Bill-Gkionis/IPM-synRM/README.md

# IPM synRM: an open motor design

A **36-slot, 8-pole permanent-magnet-assisted synchronous reluctance motor** (PMaSynRM): two N45 magnets per pole in a V, M-19 steel, a 90 mm rotor in a 128 mm stator. It is designed, simulated and optimized with open tools, and documented step by step, so that each result can be checked and reused. The motor is built to learn from, not for a specific application.

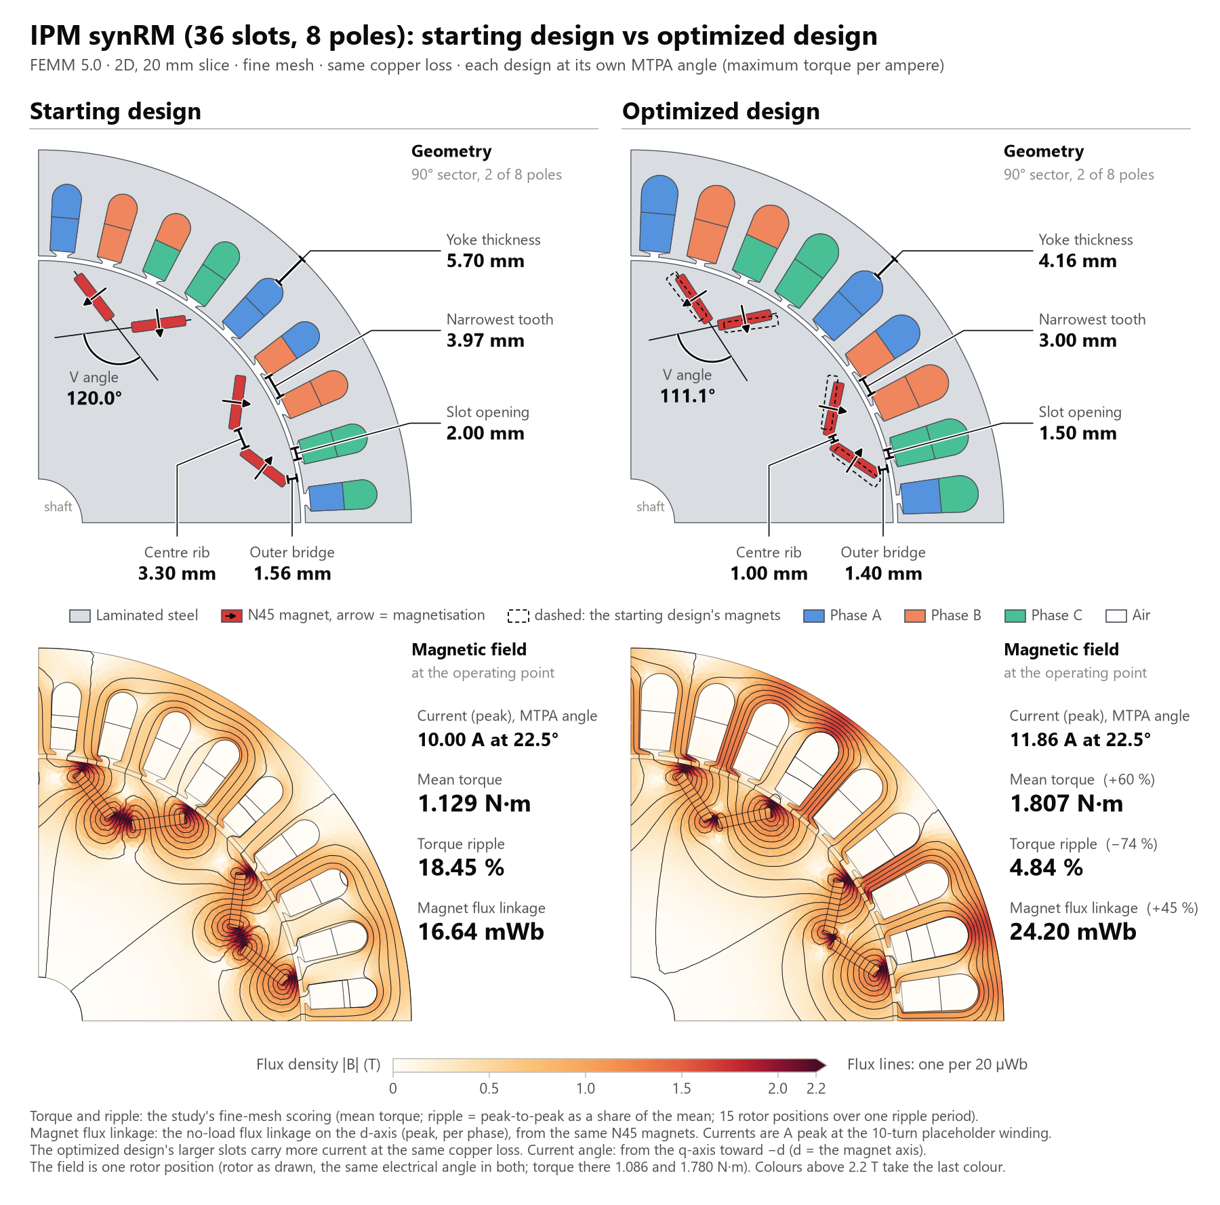
[picture p1: docs/figures/optimization/reference-vs-optimized.png]
The starting design and the optimized design, side by side: geometry and magnetic field


*The starting design (left) and the optimized design (right), at the same scale and the same copper loss, each at its own best current angle: the geometry with the changed dimensions, and the magnetic field. FEMM 5.0, 2D, fine mesh.*

> **Status (November 2026).**
> - **Done, and published here:**
>   - the cross-section, optimized;
>   - its rotor, checked for stress at speed;
>   - its flux maps over the whole current plane, with cross-saturation and the iron loss, validated in MATLAB;
>   - its thermal model;
>   - its copper losses, with the proximity effect, and the winding trade-offs;
>   - its torque–speed, loss and efficiency estimates ([Motor map.md](Motor%20map.md));
>   - an interactive flux page of the three designs ([open it](https://bill-gkionis.github.io/IPM-synRM/explorer/)).
> - **Next:** a flux-map-driven Simulink plant, in place of the constant parameters.
> - **Not yet measured:** every number here is a finite-element estimate. Nothing has been measured on hardware yet.

## The interactive flux page

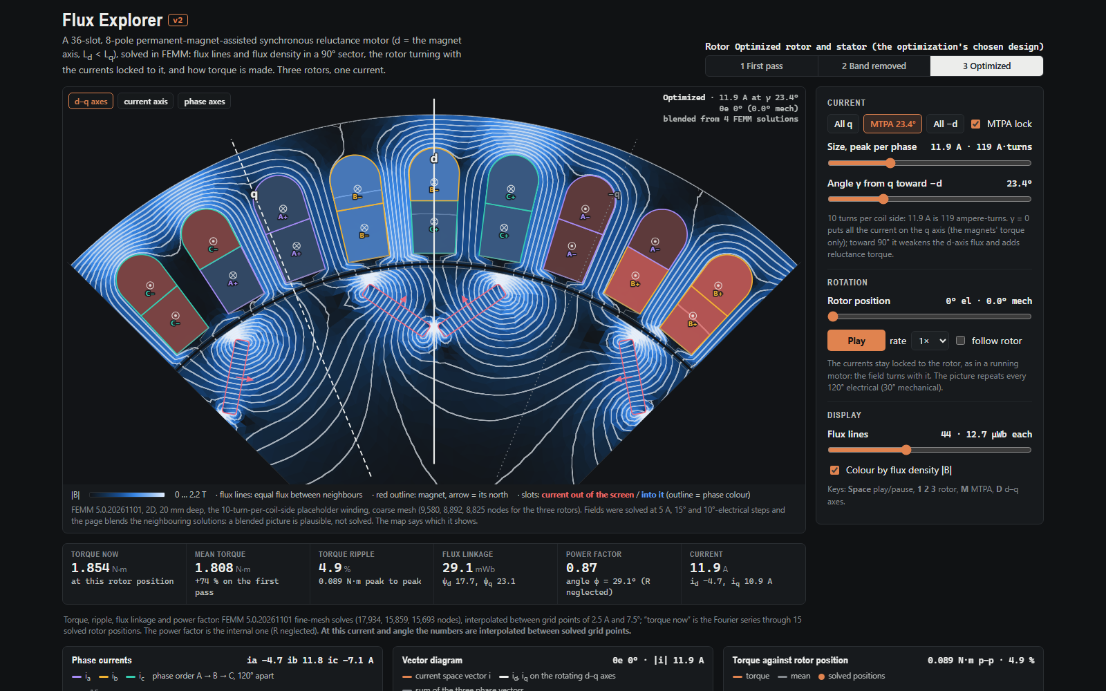
[picture p2: docs/figures/explorer/flux-explorer.png]
The Flux Explorer: the optimized motor's field, currents and torque


**[Open the Flux Explorer](https://bill-gkionis.github.io/IPM-synRM/explorer/)**: the three designs, the first pass with its air band, the band removed and the optimized motor, from 11,718 FEMM solves. It shows:
- the field, with the rotor turning;
- the current dial, with the MTPA angle;
- the phase currents and their vectors;
- the torque ripple;
- the current plane, with field weakening as the speed rises;
- about 3,400 of the designs the optimizer scored: the optimization runs (the 736 sweep designs aren't plotted).

One self-contained page, running in the browser. Pictures between solved points are blended, and the page says so.

## At a glance

| | |
|---|---|
| Topology | PM-assisted synchronous reluctance, interior V magnets, two per pole |
| Slots / poles | 36 / 8, double-layer distributed winding, q = 1.5, winding factor 0.945 |
| Stator | outer diameter 128 mm, bore 91.6 mm |
| Rotor | outer diameter 90 mm (air gap 0.8 mm), shaft Ø15 mm |
| Magnets | N45 sintered NdFeB, 1.57 × 9.08 × 19.14 mm |
| Steel | M-19, laminated |
| Supply | a 48–60 V DC bus (ultra-low voltage) |
| Axis convention | d = the magnet axis, so L_d < L_q |
| The optimized cross-section | outer bridge 1.4 mm, centre rib 1.0 mm, V angle 111°, slot opening 1.5 mm, tooth 3.0 mm, the same magnets. Against the starting design, at the same copper loss: **+60 % torque, and 4.8 % torque ripple instead of 18.5 %** |

**What it can do, estimated** ([Motor map.md](Motor%20map.md) has every assumption). On a 60 mm stack and a 48 V bus, with a fan on the shaft:
- **4.2 N·m continuously** at 3,000 rpm, and **8.7 N·m** for about 25 minutes from a cold start;
- **2.97 kW peak** short-term, and still 2.7 kW at 16,330 rpm, where the speed range ends: the rotor's safe speed, on placeholder strength values;
- **a best efficiency of 95.2 %** (motor only).

These are 2D finite-element estimates, not measurements.

## The pipeline

```mermaid
flowchart LR
  G["Geometry<br/>drawn in Python<br/>(motorgeo)"] --> F["FEMM 5.0<br/>2D magnetostatics,<br/>parallel workers"]
  F --> O["Optimizers<br/>NSGA-II · a full grid ·<br/>a blind Bayesian check"]
  O --> V["Verification<br/>CalculiX stress · Elmer ·<br/>ROSS · SALib"]
  V --> D["Motor data<br/>flux maps · thermal model ·<br/>copper losses"]
  D --> W["Winding<br/>every candidate,<br/>with the heat"]
  W --> P["Motor map<br/>torque–speed, losses,<br/>efficiency"]
  P --> N["Next<br/>MATLAB validation ·<br/>Simulink plant · inverter"]
```

**Three principles:**
- **The geometry is generated, not drawn.** One Python recipe writes the FEMM model, a DXF for CAD, and the meshes for Gmsh and Elmer, so an optimizer can change any dimension, and every candidate is checked for manufacturability before a solver opens.
- **One heavy run at a time.** Every solver run (FEMM, CalculiX, Elmer, MATLAB) takes a slot from a queue, runs at below-normal priority under a timeout, and ends only the processes it started.
- **Every result is checked by a second route:** a known analytic answer, a different solver, or an independent optimizer that never saw the first one's results.

**Solves so far:** about 122,500 FEMM solves:
- 95,588 for the optimization search (step 6);
- 15,202 for the flux maps (step 8);
- 11,718 for the interactive page.

That's besides the studies and the validation runs.

The code is in [`python/`](python/), with a guide to every file in [`python/README.md`](python/README.md).

## How it got here

### 1. The first pass (February–April 2026)

SolidWorks parts, a FEMM model with a rotor sweep by hand from 5° to 90°, the flux linkage extracted in MATLAB, and a first field-oriented-control (FOC) drive with space-vector PWM, in Simulink and Simscape Electrical. The plant ran unloaded, with constant motor parameters.
- **Files:** [`cad/`](cad/), [`femm/`](femm/), [`matlab/`](matlab/), and screenshots in [`docs/figures/`](docs/figures/).

### 2. A scriptable stack (October 2026)

The cross-section was redrawn in Python (`motorgeo`), and FEMM was driven from Python on a 90° sector with periodic boundaries and an air-gap element, in parallel workers.
- The new model reproduces the hand-drawn FEMM model's areas exactly (0.000 %).
- The 90° slice matches the full 360° model within about 1.5 %.

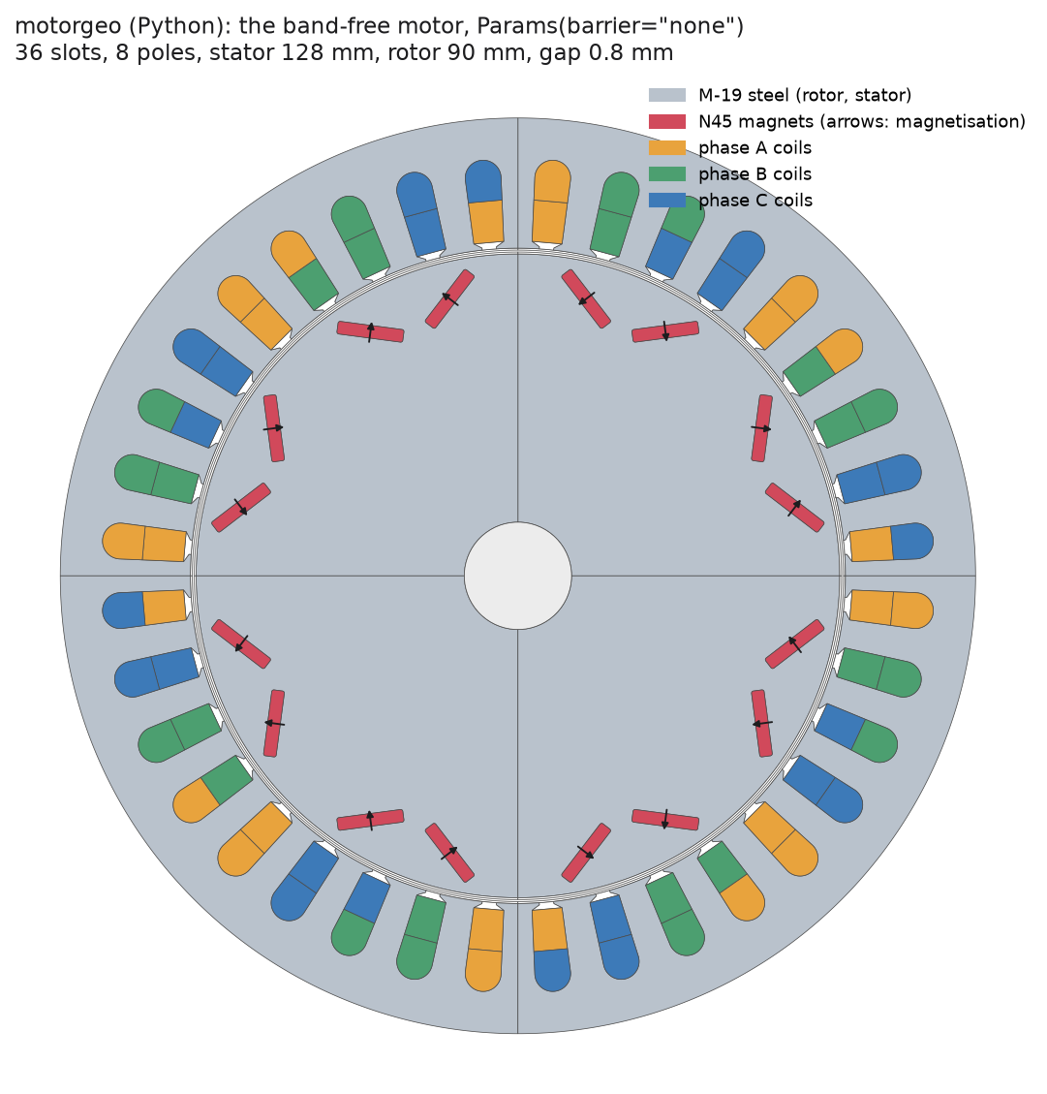
[picture p3: docs/figures/geometry/motorgeo-cross-section.png]
The cross-section drawn by motorgeo


### 3. The first study: the air band (October 2026)

The first-pass rotor had a 1.5 mm air band behind the magnets. Filled with steel, the same rotor gave **37 % more magnet flux and 31–38 % more torque** at the best current angle, with the same reluctance torque and per-cent ripple; the cogging doubled. The band sat in the magnets' return path. **It was removed.** *(FEMM 4.2.)*

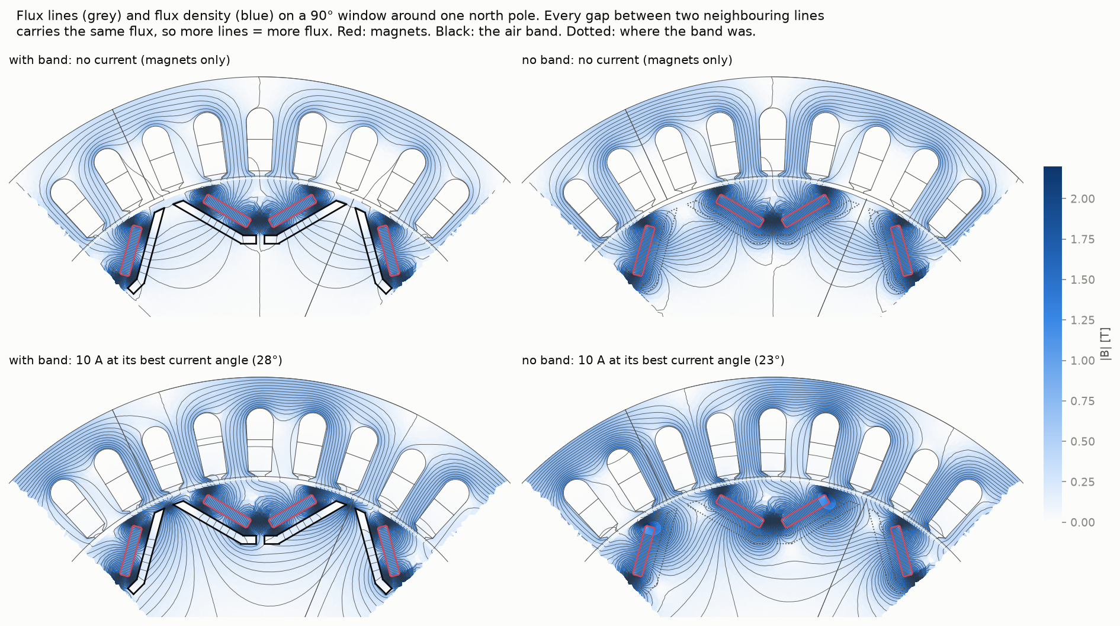
[picture p4: docs/figures/air-band/field-maps.png]
Flux and flux density with and without the air band


<details><summary>More from the air-band study</summary>

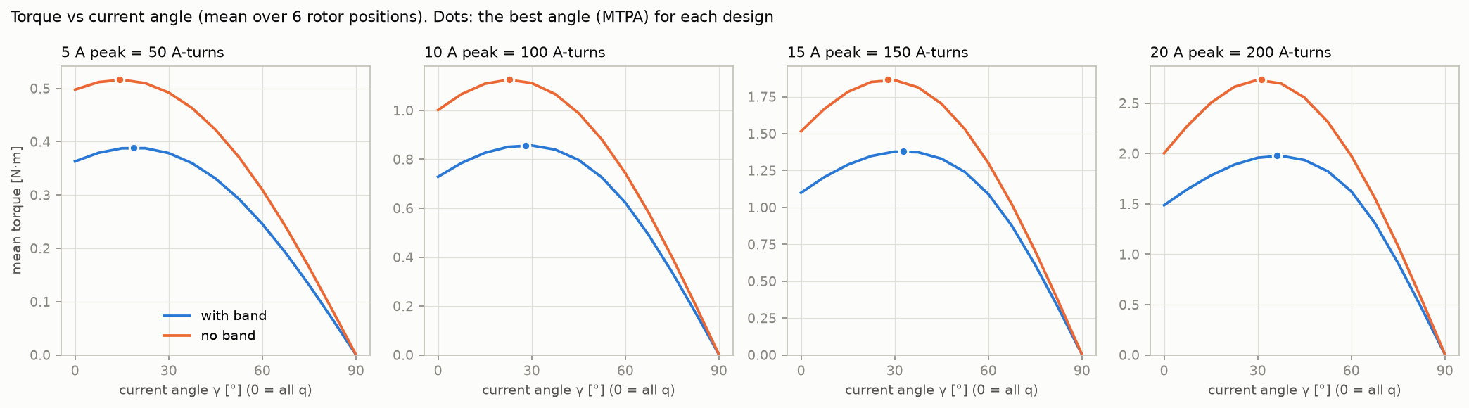
[picture p5: docs/figures/air-band/torque-vs-current-angle.png]
Torque against current angle, with and without the band

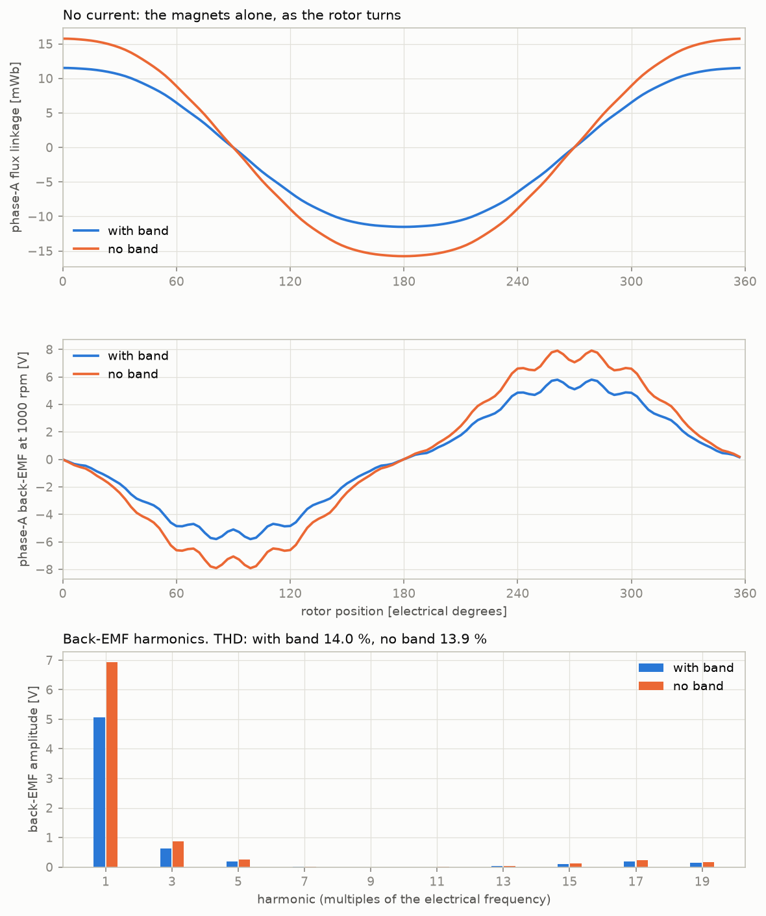
[picture p6: docs/figures/air-band/no-load-flux-and-back-emf.png]
No-load flux linkage and back-EMF


</details>

### 4. The tools, each proven on a known answer (November 2026)

- **FEMM 5.0** replaced FEMM 4.2 after a re-run of every study:
  - every mean torque and flux linkage within 1 % (fine mesh) or 2 % (coarse mesh), apart from a few cases the comparison explains;
  - the whole re-run took 8.6 minutes instead of 2 h 13 min.
- **CalculiX, Gmsh, Elmer, PrePoMax, ROSS and SALib** were each checked against a problem with a known answer, then run on the motor's own rotor in a test bench of 141 checks.
  - 116 of the 119 gating checks pass. The 3 that fail are explained: the chord error of curved edges.
- **The bench's first numbers on the band-free rotor:**
  - the bridges' peak stress: 33.45 MPa at 10,000 rpm (CalculiX);
  - the first critical speed: 22,838 rpm (ROSS, a 60 mm stack and an estimated bearing span);
  - Elmer agrees with FEMM at no load within 0.33 % on its default mesh.

<details><summary>The bench's figures</summary>

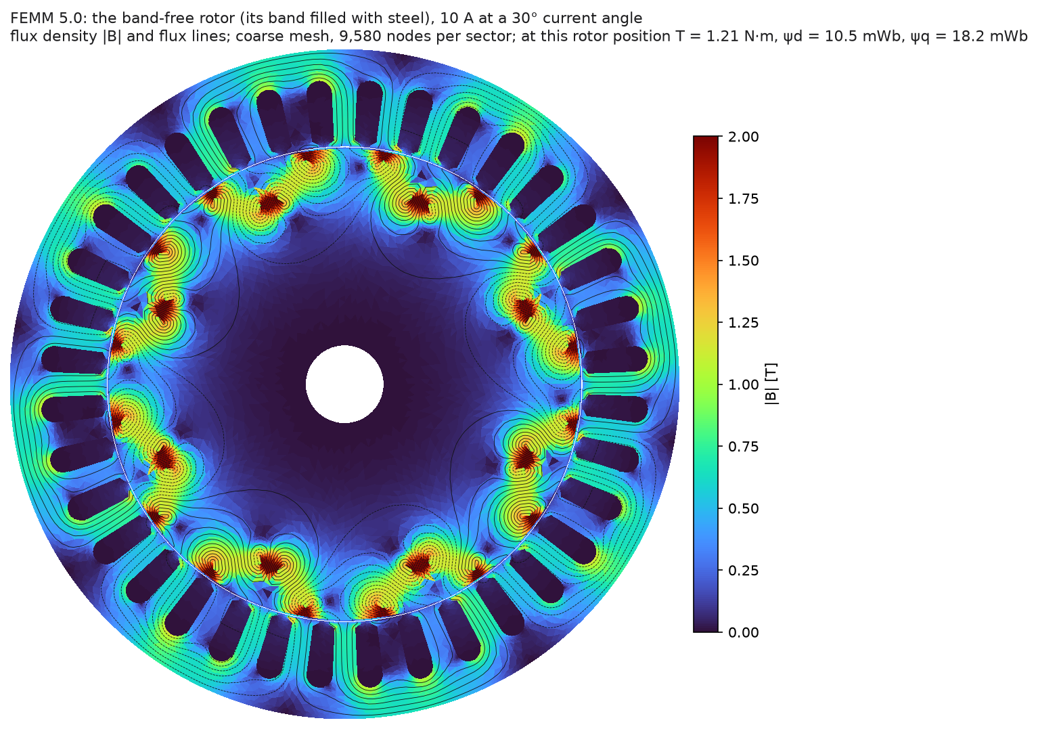
[picture p7: docs/figures/tools/femm-flux.png]
FEMM 5.0: flux density and flux lines of the band-free rotor

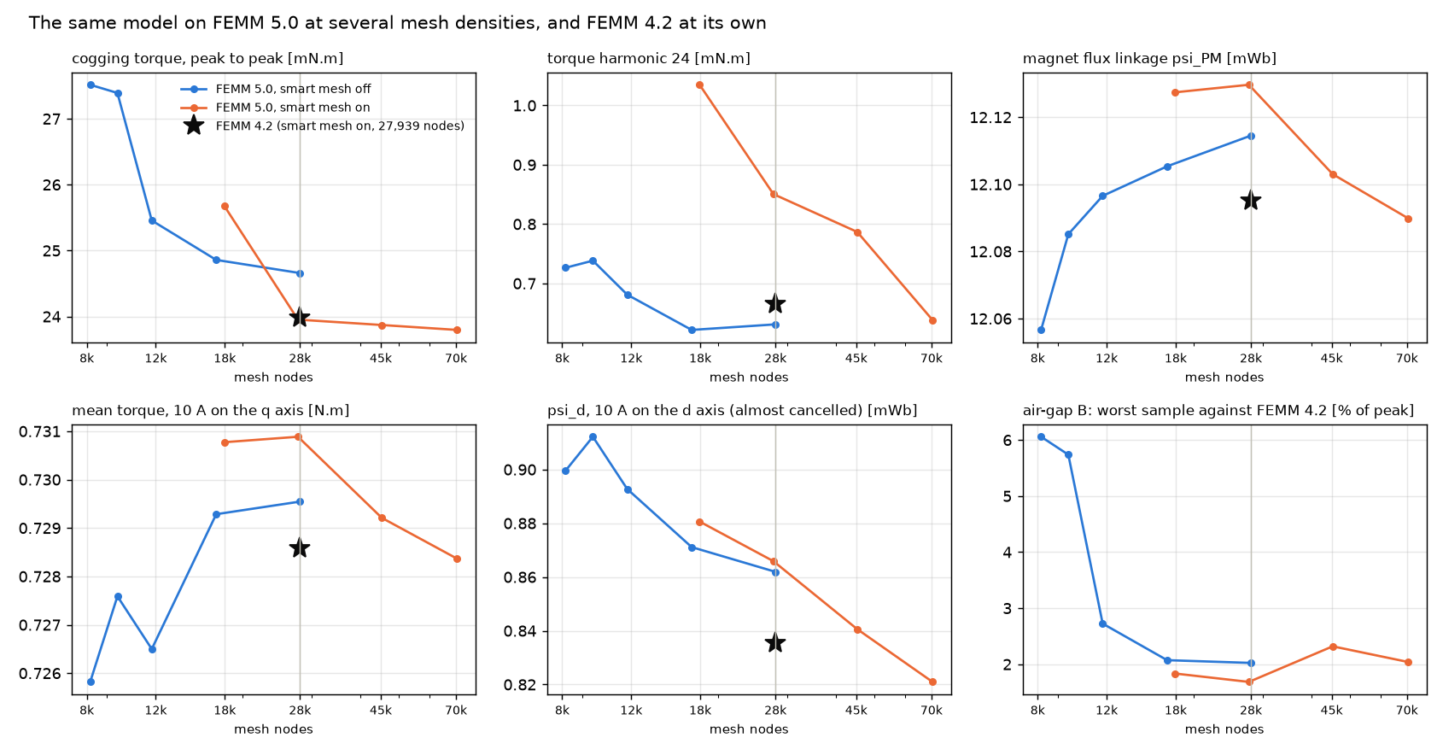
[picture p8: docs/figures/tools/femm-mesh-convergence.png]
FEMM 5.0 against FEMM 4.2: mesh convergence

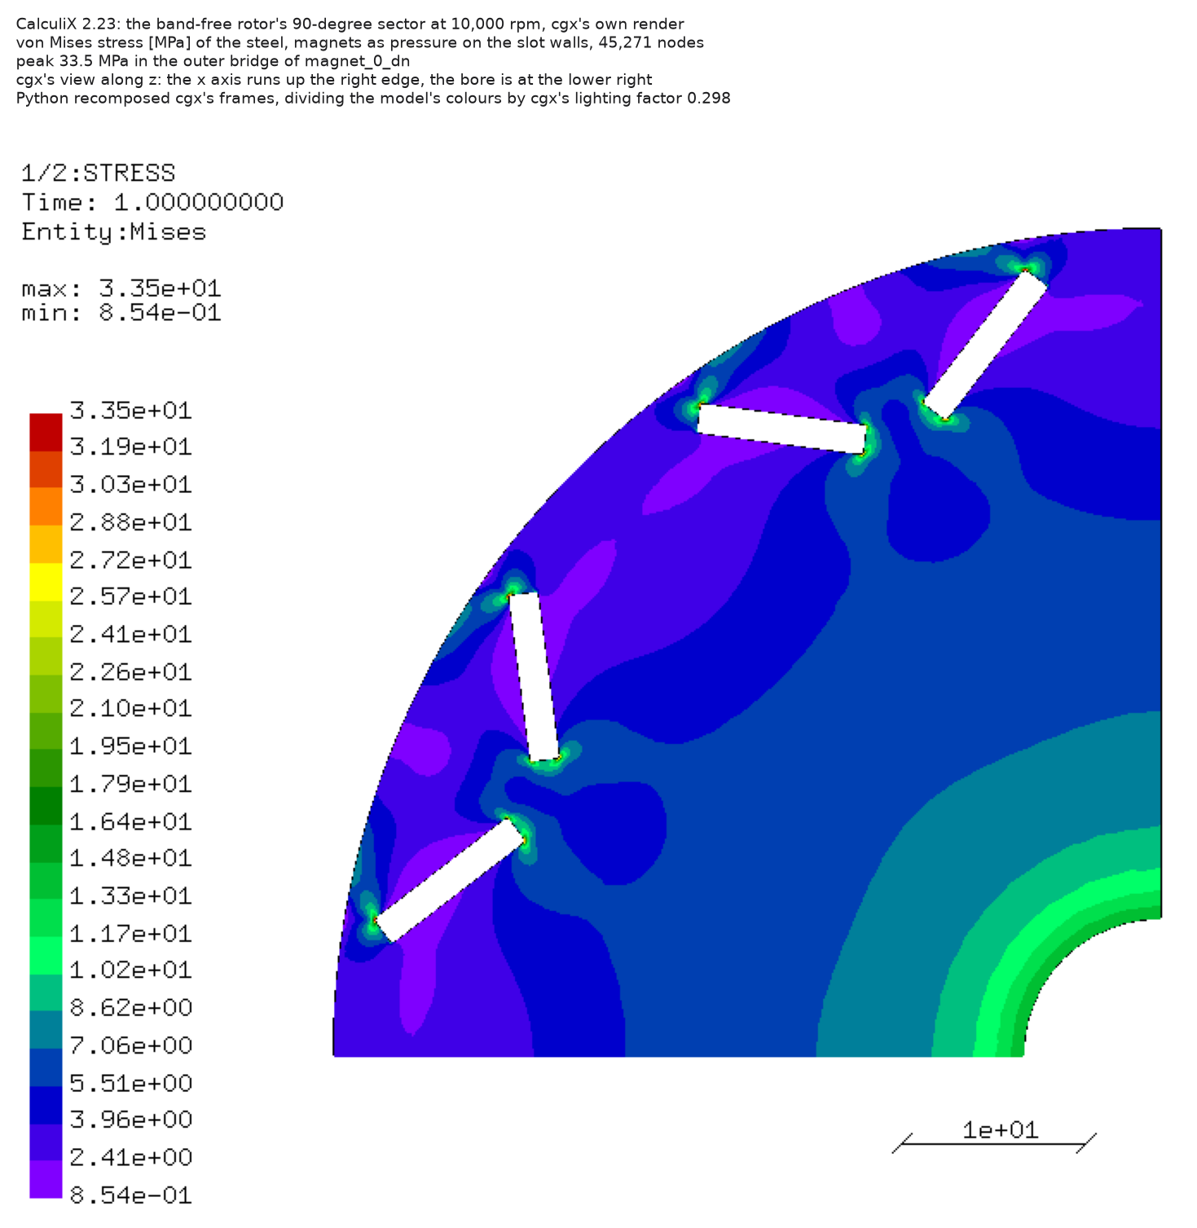
[picture p9: docs/figures/tools/calculix-bench.png]
The rotor's stress in CalculiX

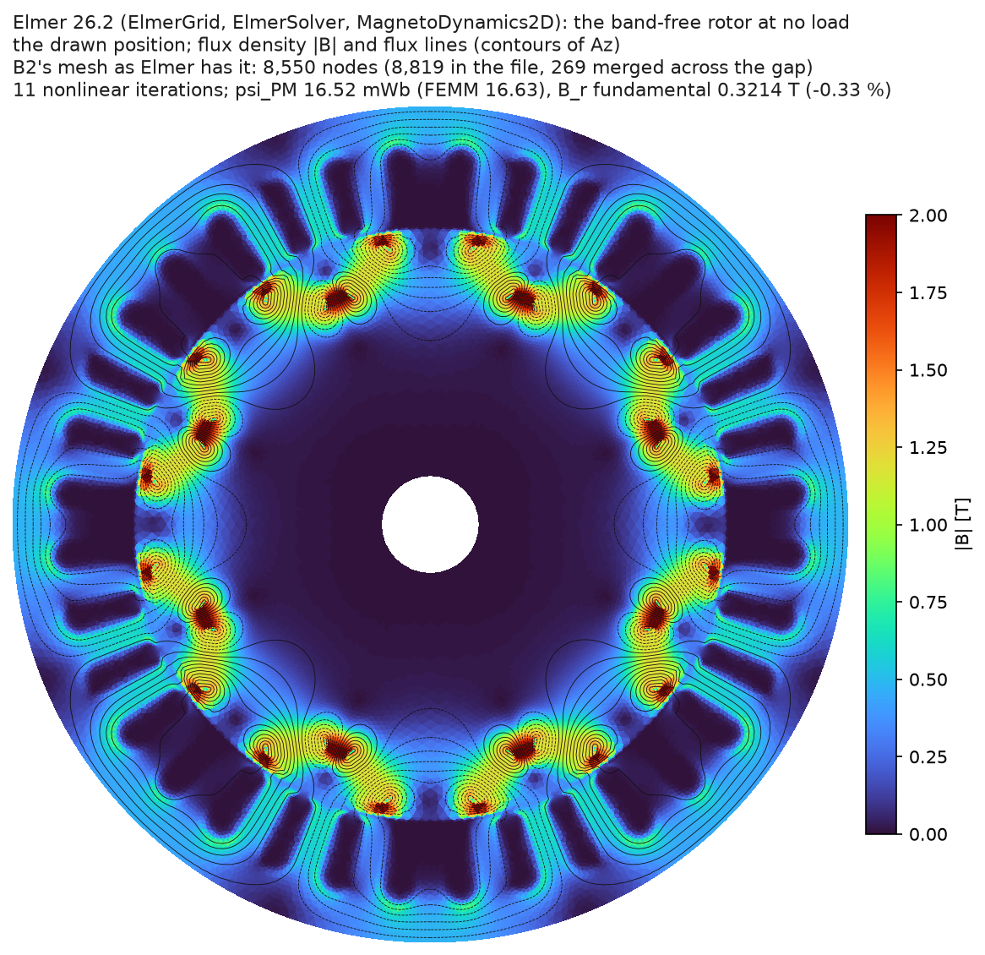
[picture p10: docs/figures/tools/elmer-bench.png]
Elmer against FEMM

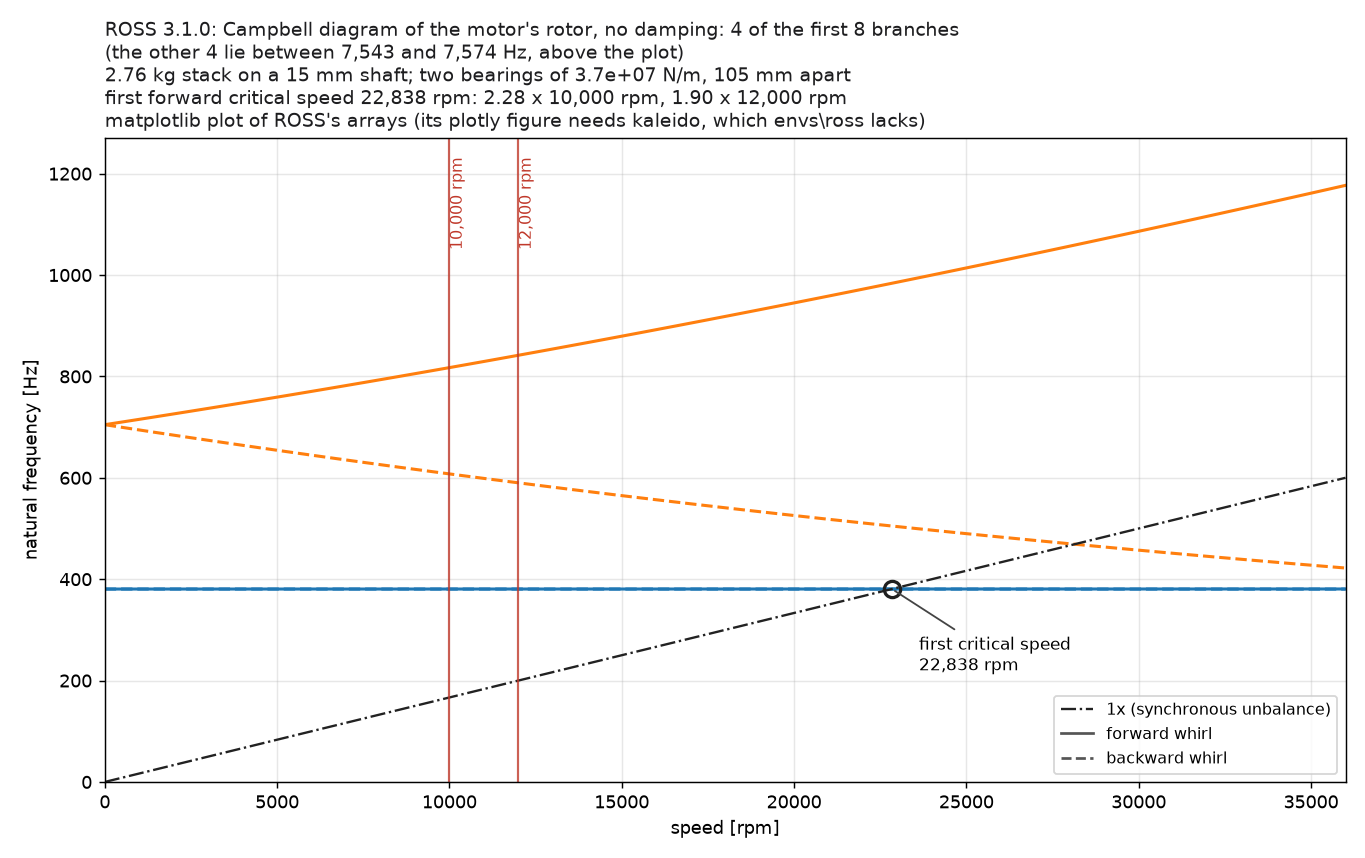
[picture p11: docs/figures/tools/ross-campbell.png]
The rotor's Campbell diagram in ROSS

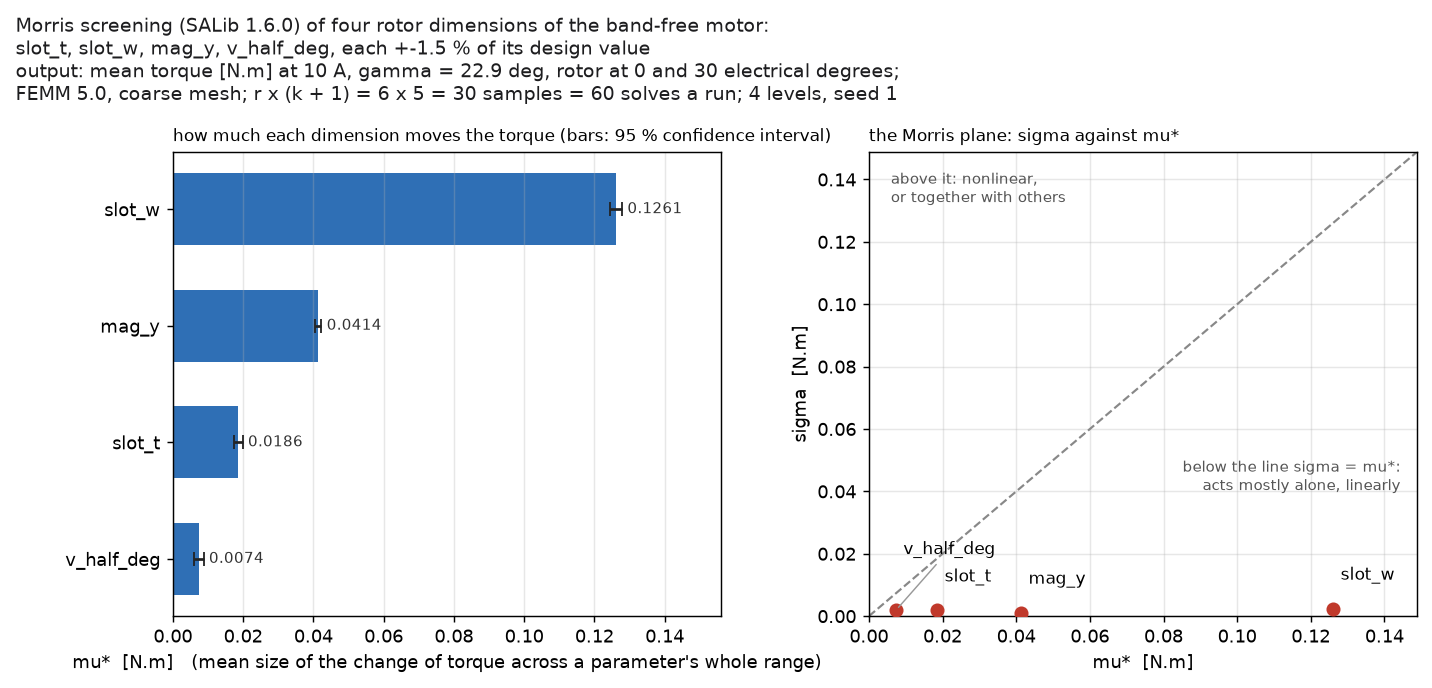
[picture p12: docs/figures/tools/salib-morris.png]
Morris screening of the rotor's dimensions with SALib

M-19's B-H curves

</details>

### 5. The physics, tested in FEMM (November 2026)

On the band-free rotor:
- **Torque in the d-q frame.** At 10 A the torque splits into three field-times-current terms: 0.918 + 0.461 − 0.253 = 1.127 N·m.
- **The magnets make the saliency.** With their coercivity set to zero, the unsaturated bridges short the barrier and L_d = L_q (saliency 1.00, against 1.82 with the magnets).
- **MTPA, the most torque per amp,** on this starting rotor (rated 10 A at the 10-turn placeholder winding), from 5 to 40 A:
  - FEMM's best current angle climbs from 22.9° at 10 A to 43.3° at 40 A;
  - the textbook formula with the 10 A point's constant L_d, L_q and ψ_PM says 37.5° at 40 A;
  - fed each current's own axis inductances instead, it even turns the wrong way, to 25°. Run at that angle, the motor loses about 10 % of its torque.

  The cause is **cross-saturation**, so the controller's table has to come from flux maps.

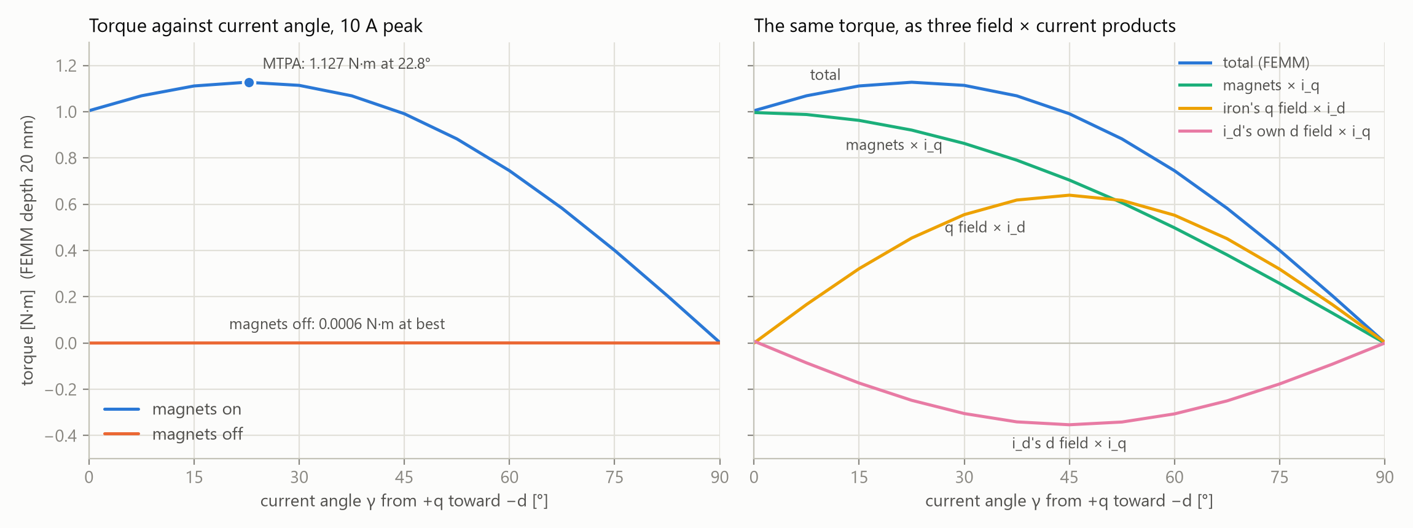
[picture p13: docs/figures/physics/torque-vs-current-angle.png]
Torque against current angle


<details><summary>More</summary>

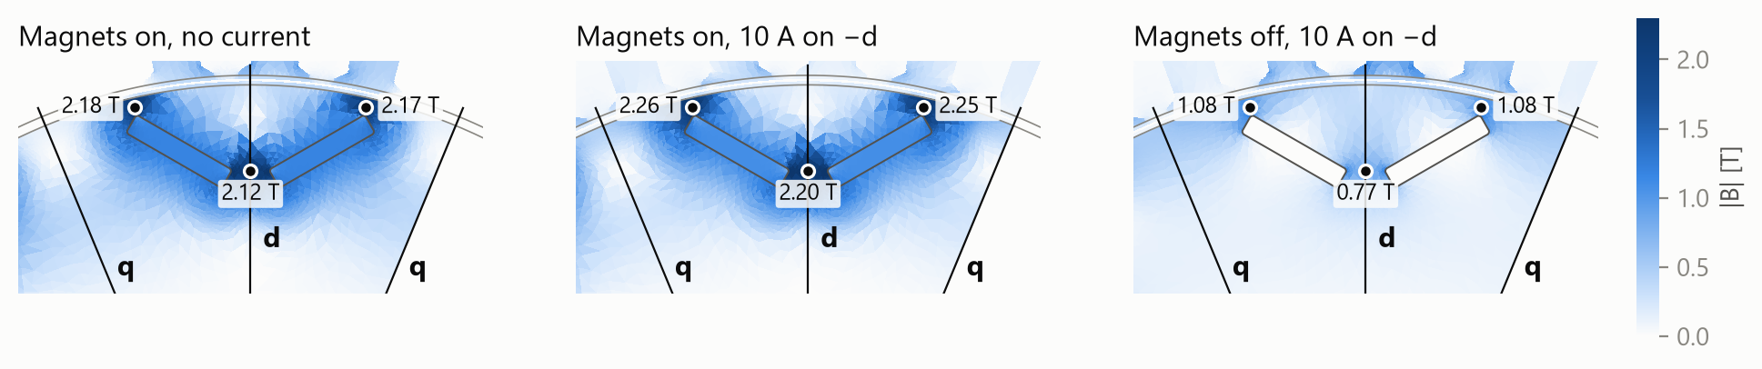
[picture p14: docs/figures/physics/bridges-magnets-on-off.png]
The bridges, with the magnets on and off

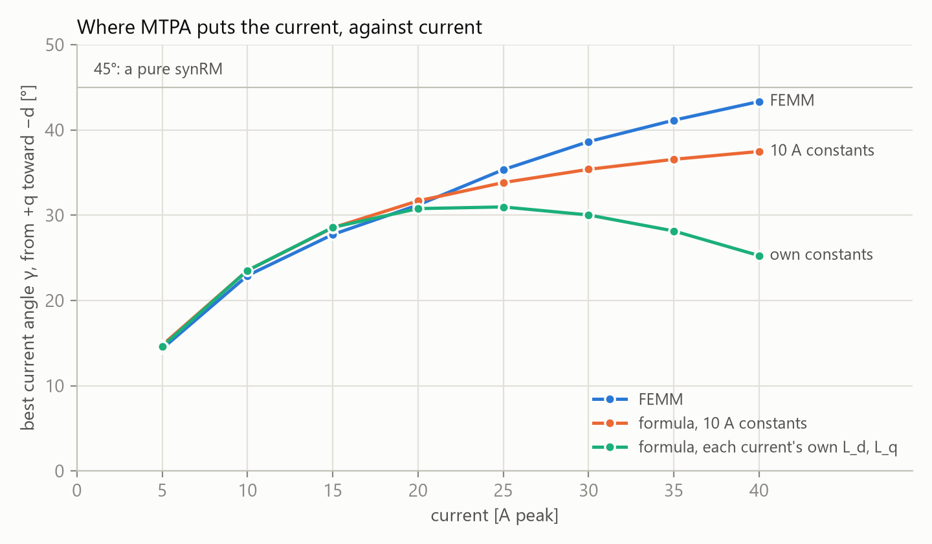
[picture p15: docs/figures/physics/mtpa-angle-vs-current.png]
The best current angle against current

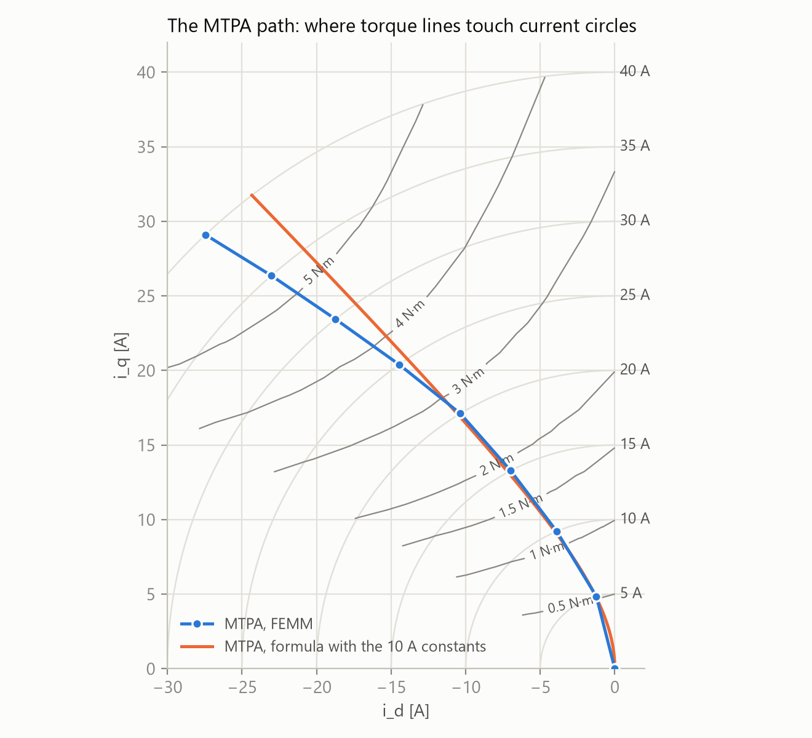
[picture p16: docs/figures/physics/mtpa-path.png]
The MTPA path in the i_d–i_q plane


</details>

### 6. The optimization (November 2026)

**The landscape came first:** sweeps of each dimension, two maps, and a Morris screening. Then each part got the optimizer its landscape called for:
- **NSGA-II (pymoo) for the rotor,** a full grid for the stator, NSGA-II for both together, and every combination for the winding;
- **a blind second run** with a different method (a Bayesian search on Gaussian-process surrogates) found the same design region, with a slightly better front in fewer designs. The chosen design comes from its front.

**The size of the search:** 4,156 designs, each scored with 23 FEMM solves, about 96,000 solves in all:
- the sweeps, 736;
- the screening, NSGA-II and the grid, 1,973;
- the blind run, 1,447.

**The result, on the fine mesh, at the starting design's copper loss:**

| | Starting design | Optimized |
|---|---|---|
| Mean torque | 1.129 N·m | **1.807 N·m (+60 %)** |
| Torque ripple | 18.45 % | **4.84 %** |
| Power factor (resistance neglected) | 0.810 | 0.868 |
| Magnet flux linkage | 16.64 mWb | 24.20 mWb (+45 %, the same magnets) |

**Why:**
- the centre rib went from 3.3 to 1.0 mm, so far less of the magnets' flux is spent saturating steel;
- the bigger slot carries more current at the same loss;
- the V angle and the narrower slot opening cut the ripple.

The side-by-side picture at the top of this page shows both designs.

**Four of the six variables sit on a limit:** the bridge (1.4 mm), the rib (1.0 mm), the tooth (3.0 mm) and the slot opening (1.5 mm). Those limits are the design decisions.

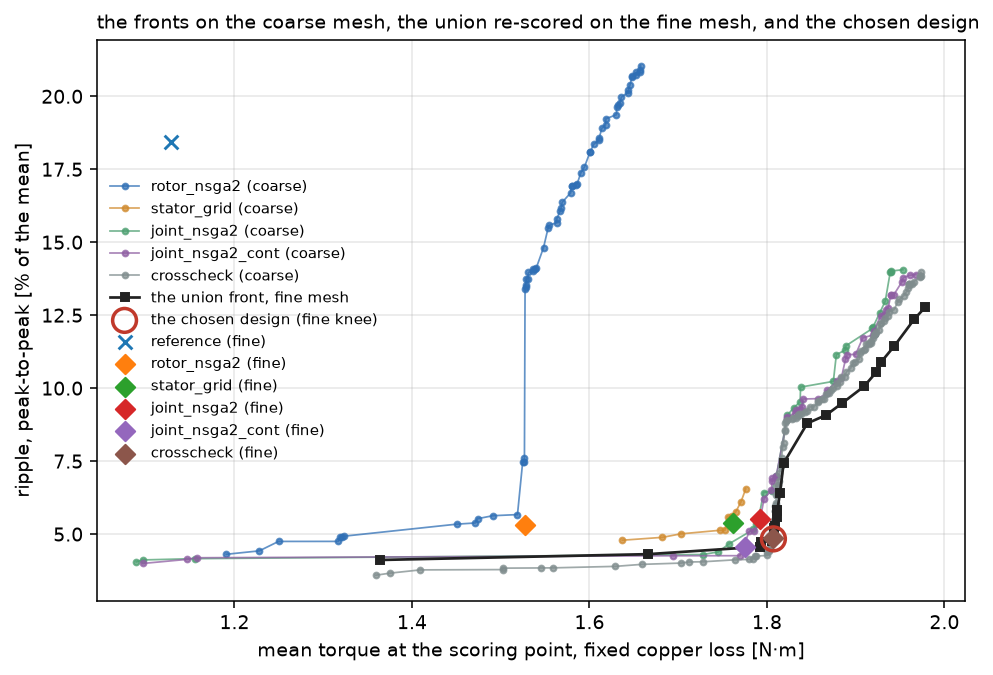
[picture p17: docs/figures/optimization/fronts-fine-mesh.png]
The fronts, re-scored on the fine mesh


*The torque–ripple fronts of each run (the rotor NSGA-II, the stator grid, the joint NSGA-II and its continuation, and the blind Bayesian cross-check), and their union re-scored on the fine mesh. The chosen design sits at the knee.*

<details><summary>More from the optimization</summary>

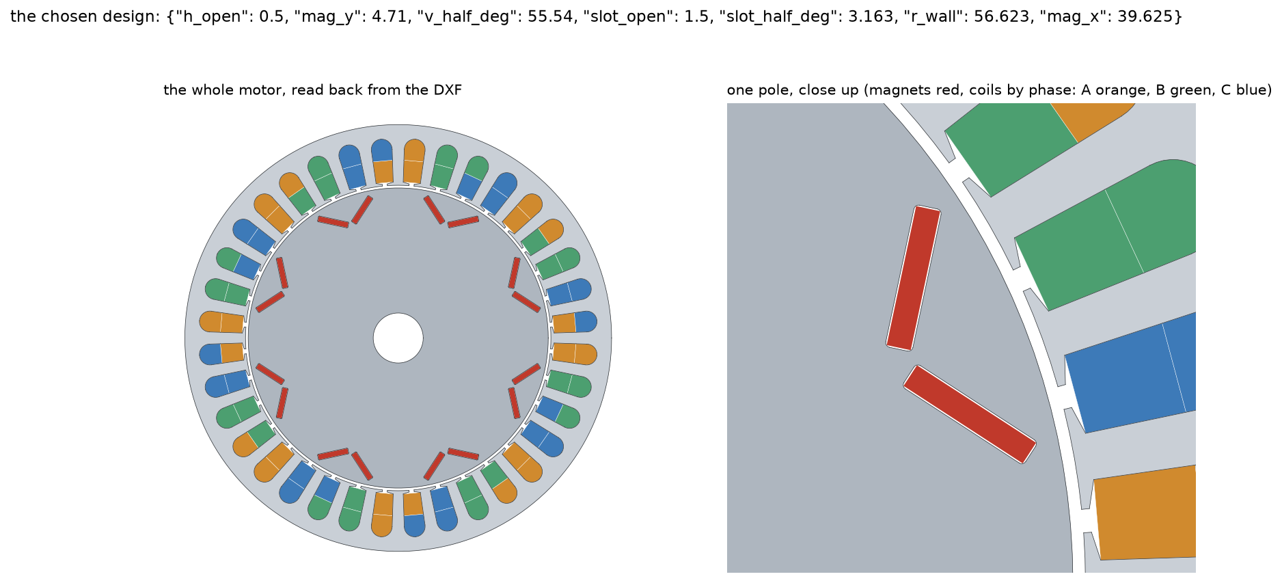
[picture p18: docs/figures/optimization/chosen-motor.png]
The optimized motor, whole

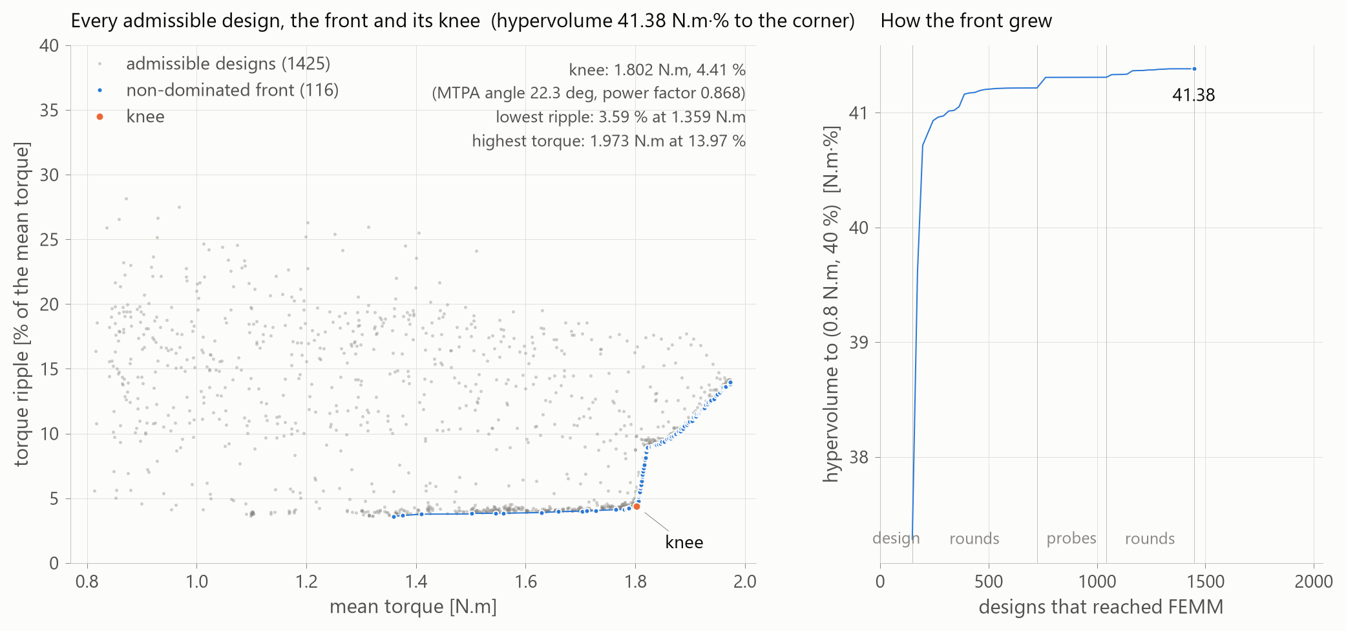
[picture p19: docs/figures/optimization/independent-run.png]
The independent Bayesian run against NSGA-II

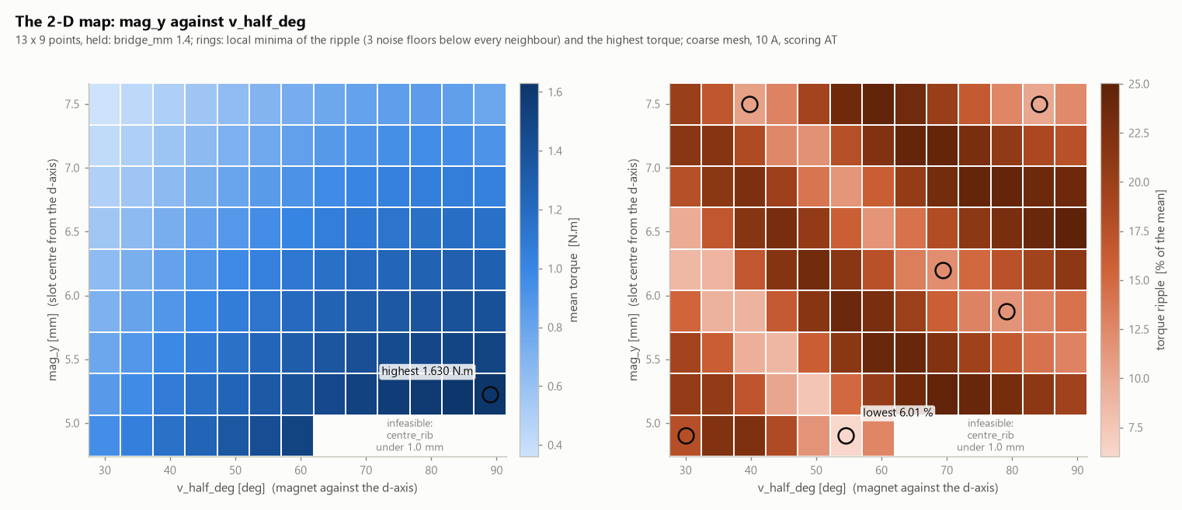
[picture p20: docs/figures/optimization/rotor-ripple-map.png]
The rotor's ripple map

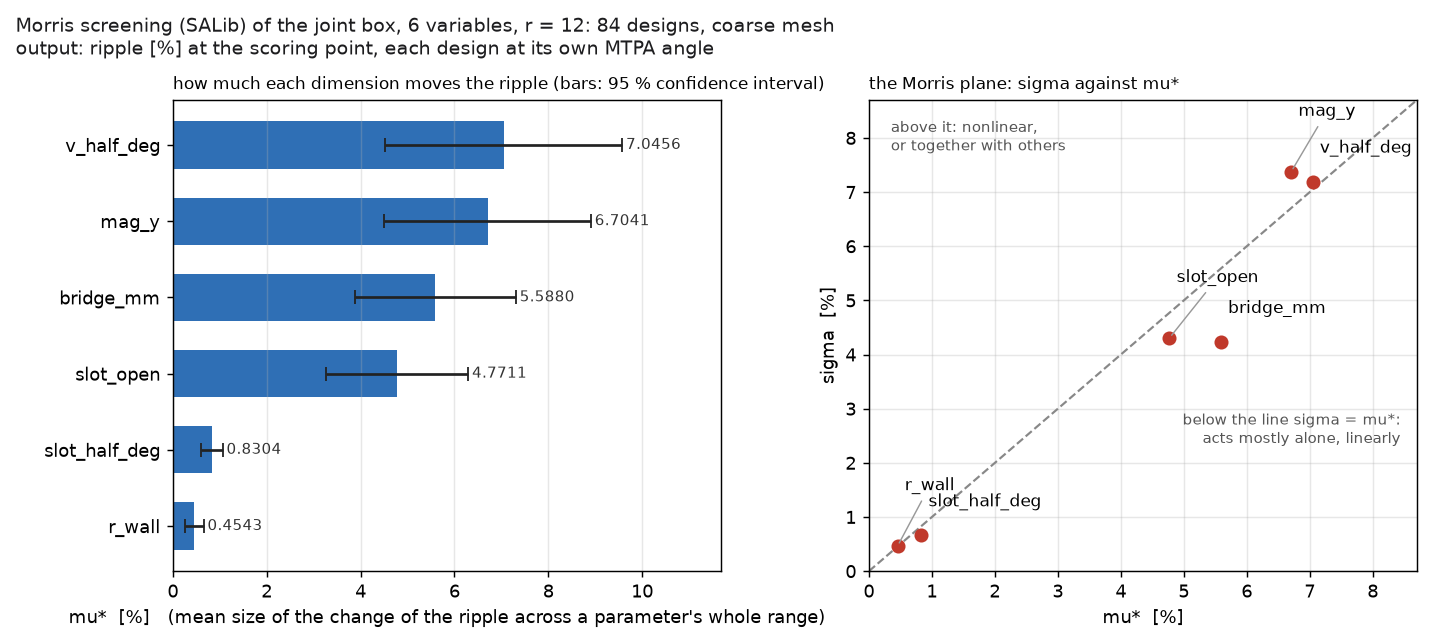
[picture p21: docs/figures/optimization/morris-ripple.png]
Morris screening of the ripple

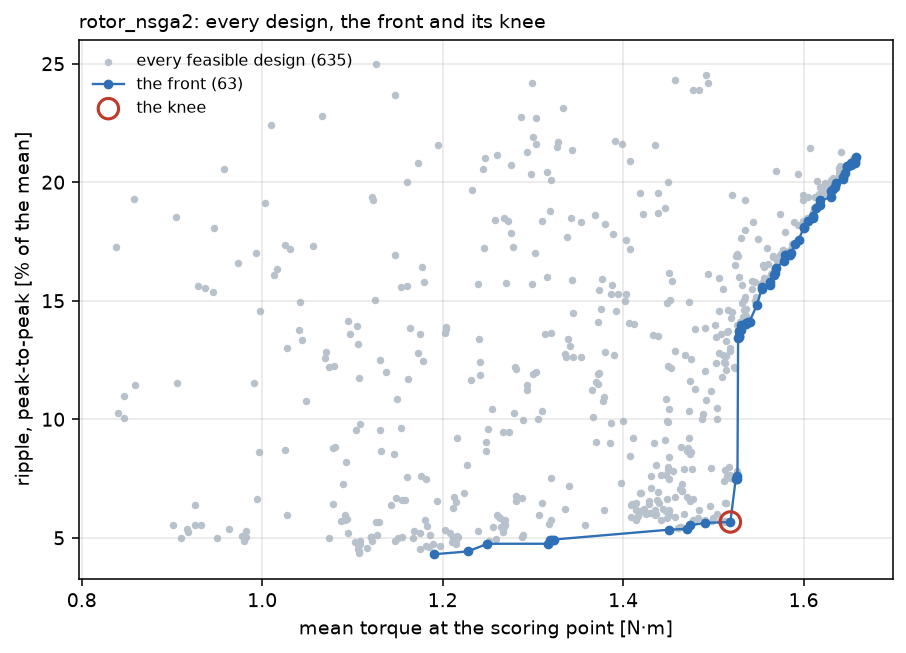
[picture p22: docs/figures/optimization/rotor-front.png]
The rotor's front

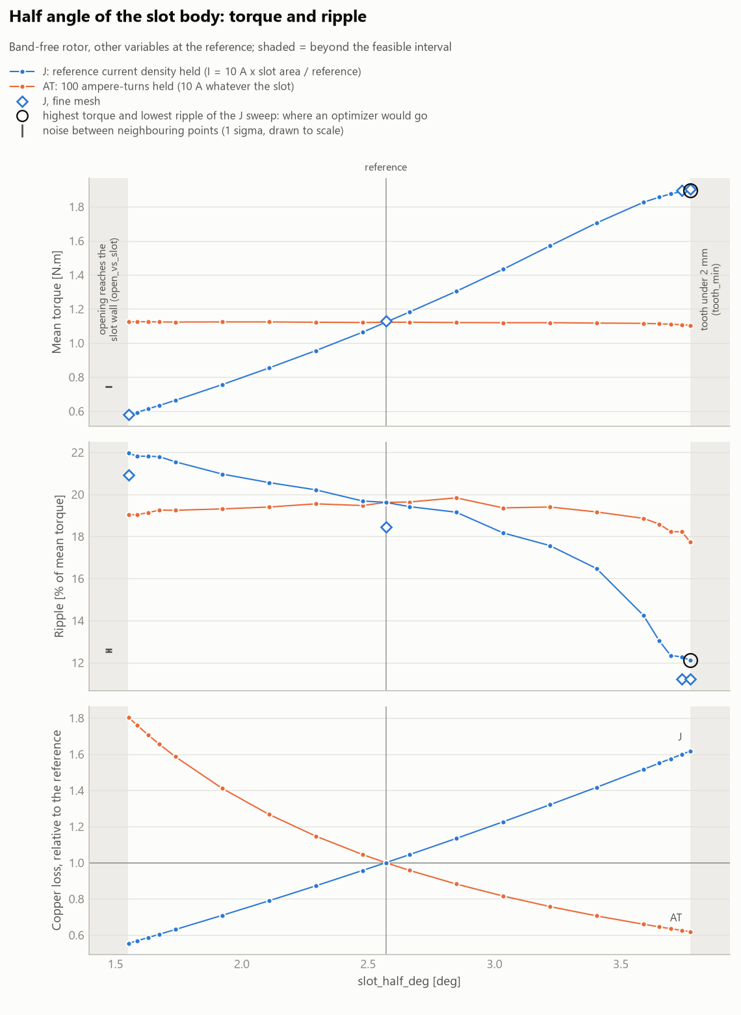
[picture p23: docs/figures/optimization/stator-fixed-j-vs-at.png]
The stator at fixed current density against fixed ampere-turns

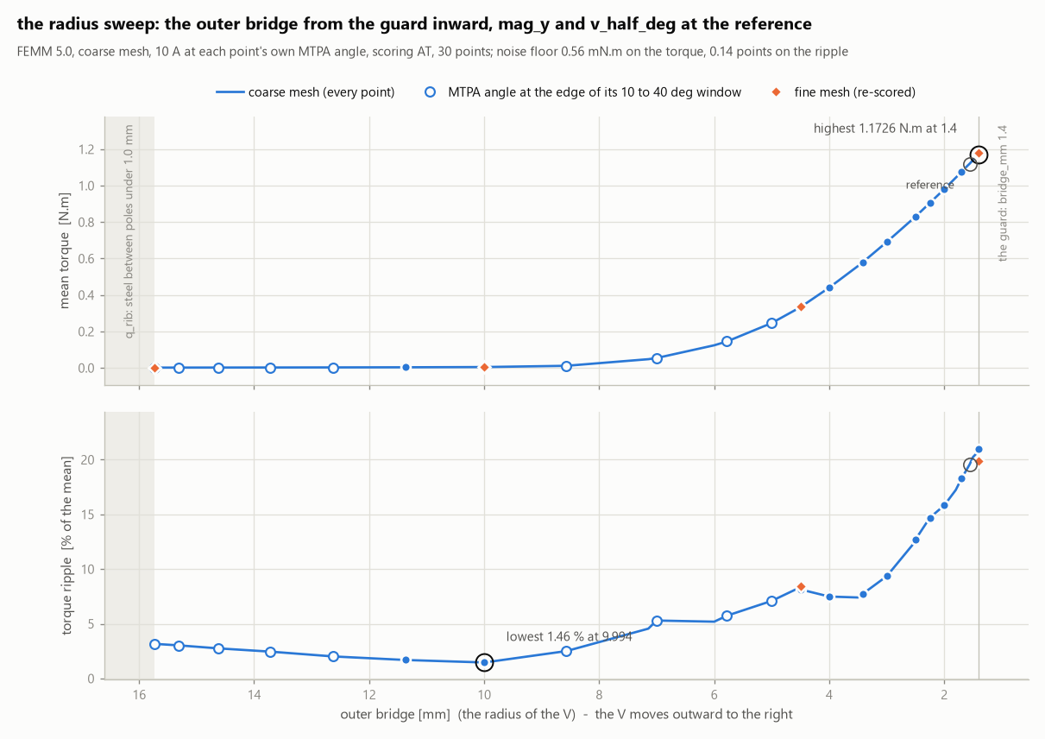
[picture p24: docs/figures/optimization/radius-sweep.png]
The radius sweep

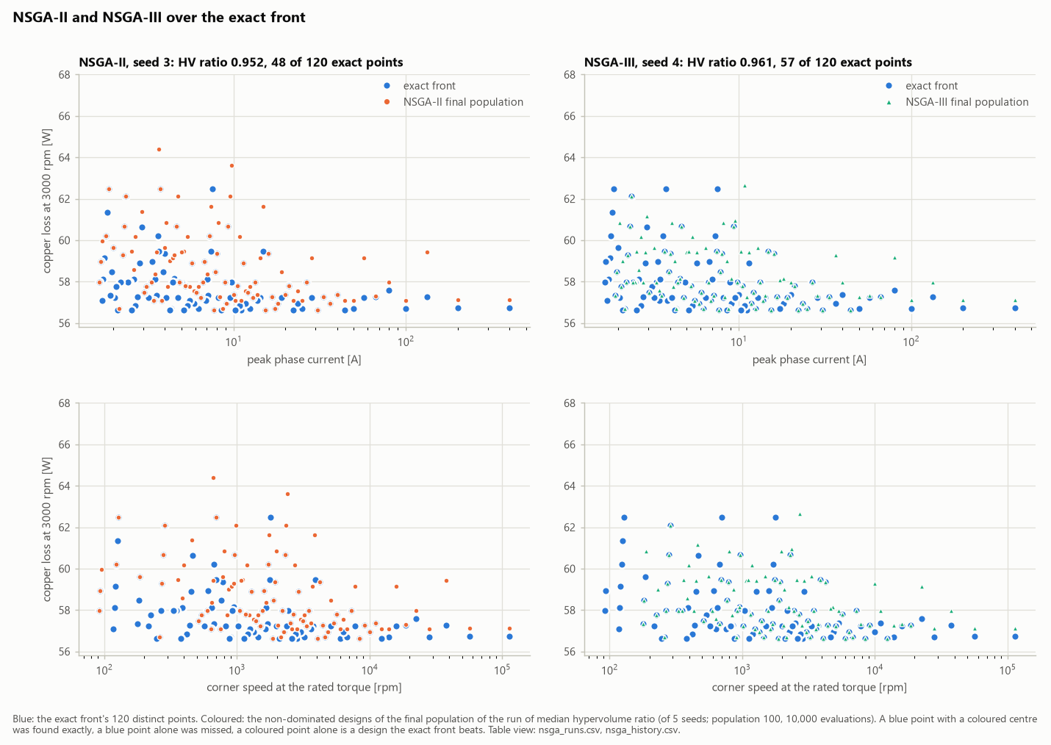
[picture p25: docs/figures/optimization/winding-nsga-vs-exact.png]
The winding: NSGA-II against the exact front


</details>

### 7. The stress check (November 2026)

CalculiX, in 2D plane stress, with the magnets as loose loads on their slot walls (the upper bound):
- **The optimized rotor peaks at 39.06 MPa at 10,000 rpm,** now in the 1.0 mm centre rib. The starting design peaked at 33.45 MPa, in a bridge.
- **Safe speed:** with half the steel's yield stress at a 1.2 × overspeed, on placeholder strength values, it is safe to **16,330 rpm**. The speed range ends there.

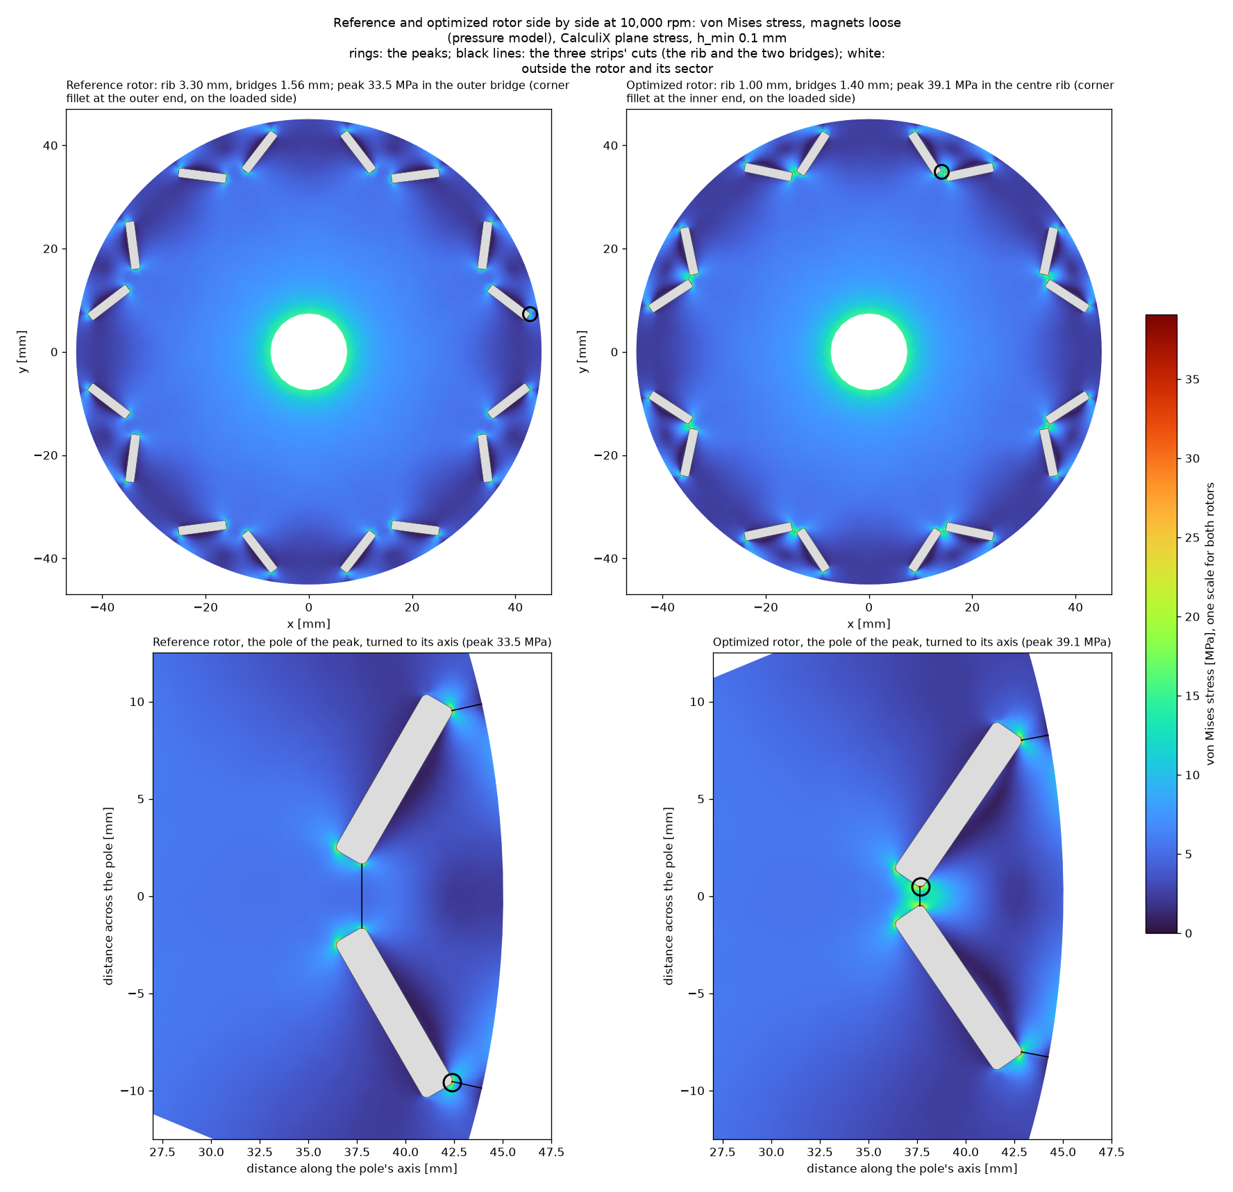
[picture p26: docs/figures/stress/reference-vs-optimized.png]
Stress at 10,000 rpm, starting design against optimized


<details><summary>More</summary>

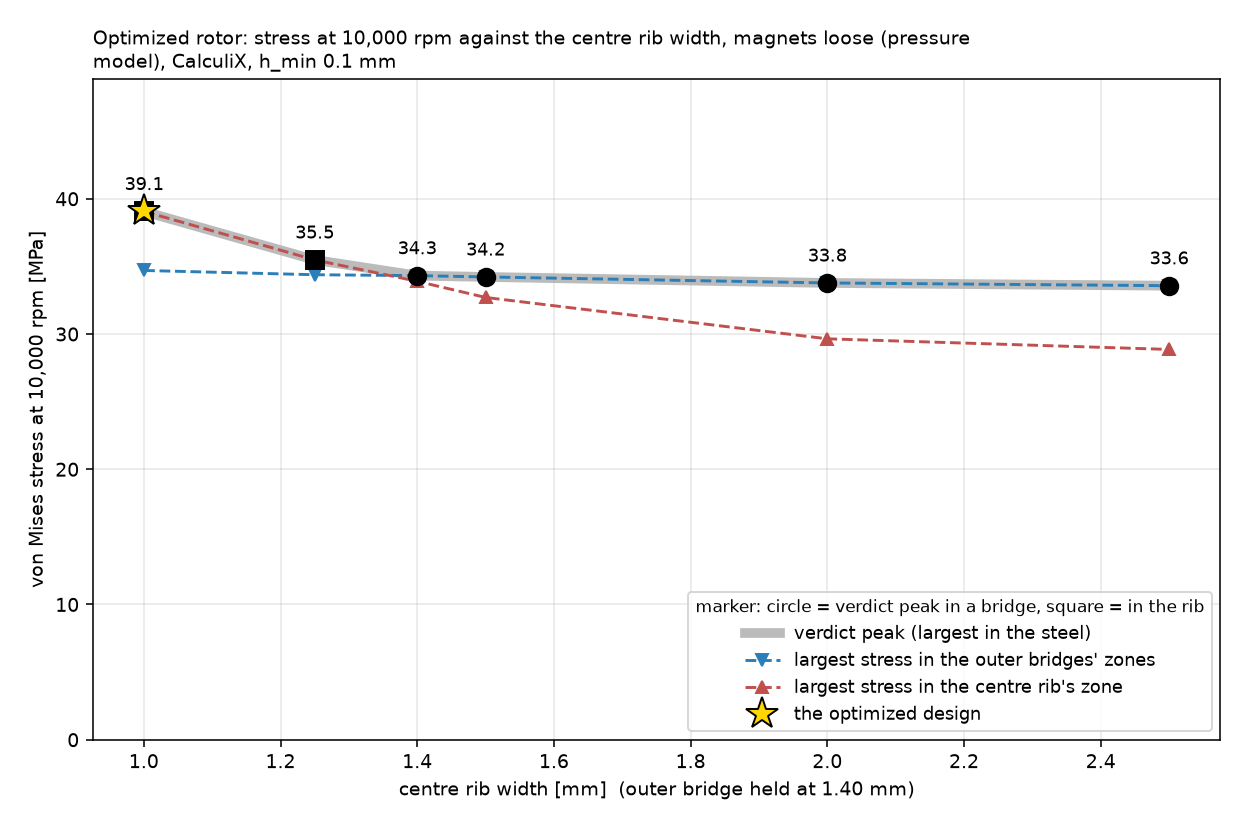
[picture p27: docs/figures/stress/peak-vs-rib.png]
The peak stress against the rib

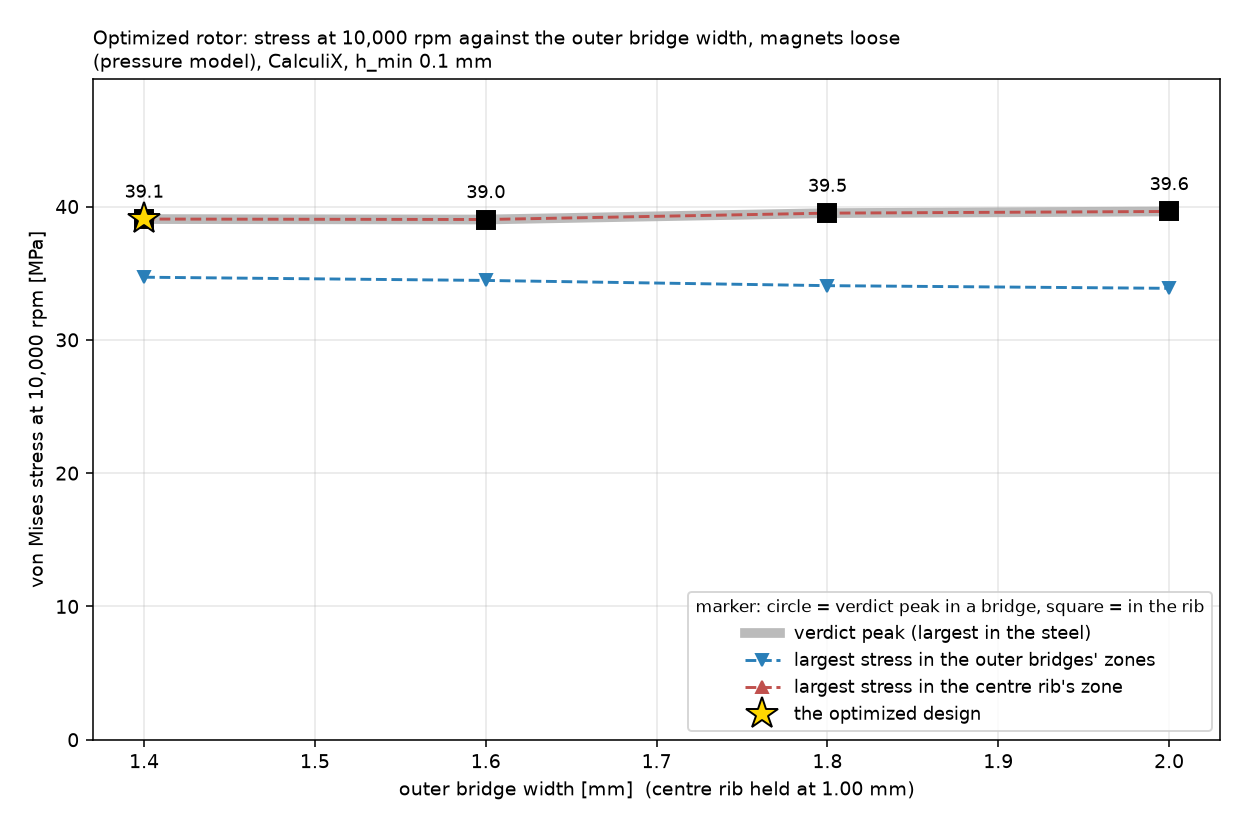
[picture p28: docs/figures/stress/peak-vs-bridge.png]
The peak stress against the bridge


</details>

### 8. The flux maps (November 2026)

The optimization scored one operating point. A drive needs the whole current plane. So the optimized motor's flux linkages ψ_d and ψ_q, its torque and its ripple were mapped over (i_d, i_q), up to 3 × the rated current and into field weakening:
- **425 operating points, 15,202 FEMM solves** on the fine mesh. The negative-i_q half was solved, not mirrored, because the winding isn't mirror-symmetric about the d axis.
- **The checks:**
  - the d-q torque 1.5 p (ψ_d i_q − ψ_q i_d), fed from the maps, matches FEMM's own torque to **0.085 %** at worst;
  - the two cross inductances agree, as reciprocity says they must (median difference 0.015 %).
- **Cross-saturation is strong.** On the optimized rotor, rated at 11.86 A at the placeholder winding (so 3 × rated is 35.6 A):
  - the best current angle (MTPA) is 23.5°, 37.4° and **43.3°** at 1, 2 and 3 × rated;
  - the formula with the rated point's constant L_d, L_q and ψ_PM says 17.3°, 26.2° and **30.9°**. Its angle still rises with current, because magnet torque grows as I and reluctance torque as I², but too little;
  - run at that angle, the motor loses only 3.6 % of its torque at 3 × rated, because the curve is flat near its top;
  - the constant-parameter **model's own torque prediction** there is **41 % too high**: a plant built on it would promise torque the motor can't make.

  So the controller's MTPA table and the Simulink plant both come from the maps. *(The 43.3° here and in step 5 are two rotors at two currents.)*
- **The iron loss:**
  - **The model:** a Bertotti model fitted to M-19 data (rms **6.9 %** cross-validated), applied to every harmonic of each mesh triangle's flux-density waveform over a full electrical period.
  - **The result:** 9.0 W at the rated point at 3,000 rpm, and 129 W at 16,330 rpm (a 20 mm stack, 0.3 mm laminations).
- **For MATLAB and Simulink:** the maps, with five scripts for Simscape's FEM-Parameterized PMSM block, are in [`matlab/maps/`](matlab/maps/).
  - **Validated in MATLAB R2025b:** `check_fem_maps.m` passes all 14 checks against the Python reference, with the MTPA angles to 0° and the torques to 2 × 10⁻¹⁶.
  - **On the 60 mm motor's own winding,** MATLAB and Python agree within 0.2° and 0.02 %.
  - **Next:** filling the Simulink block.

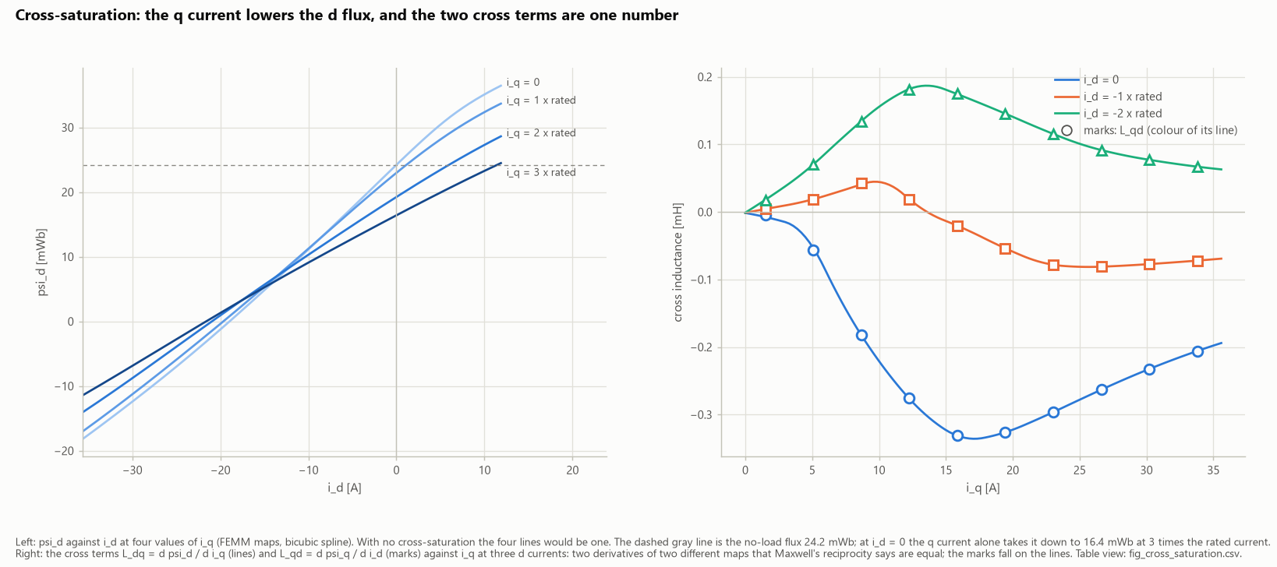
[picture p29: docs/figures/maps/cross-saturation.png]
Cross-saturation: ψ_d against i_d at four values of i_q, and the two cross inductances


<details><summary>More from the flux maps</summary>

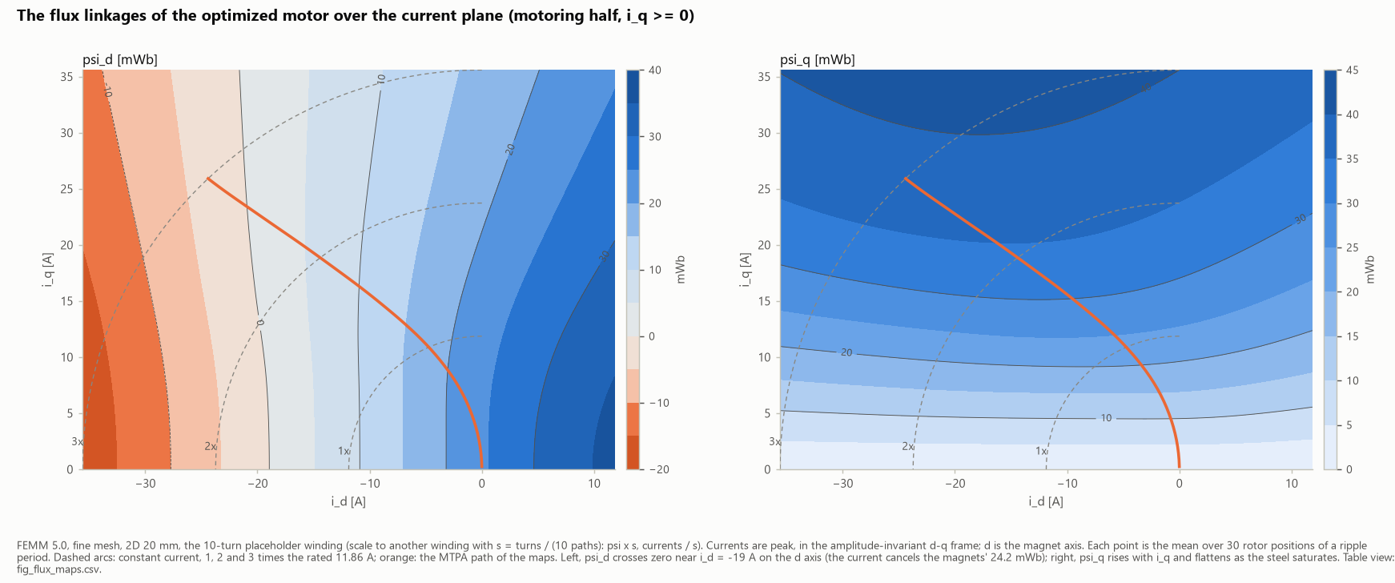
[picture p30: docs/figures/maps/flux-maps.png]
ψ_d and ψ_q over the current plane

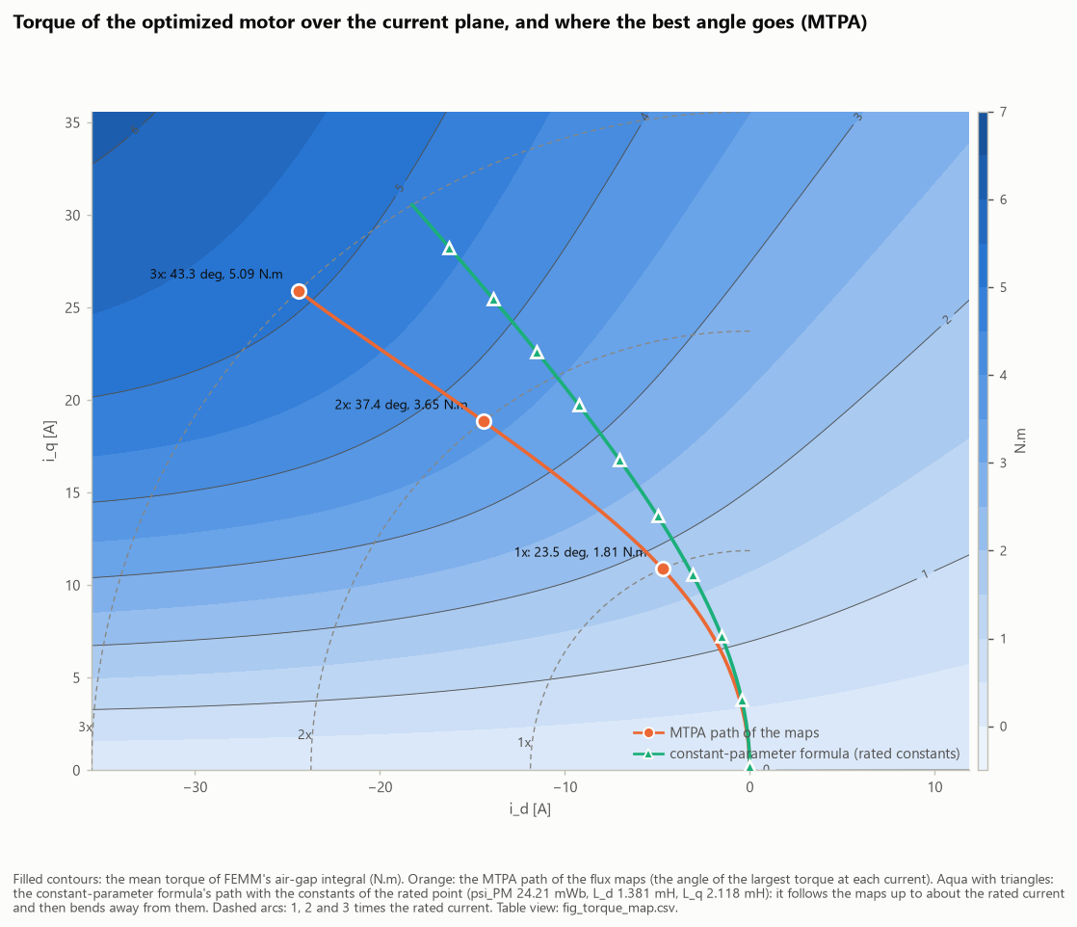
[picture p31: docs/figures/maps/torque-and-mtpa.png]
The torque over the current plane, and the MTPA path from the maps against the constant-parameter formula's

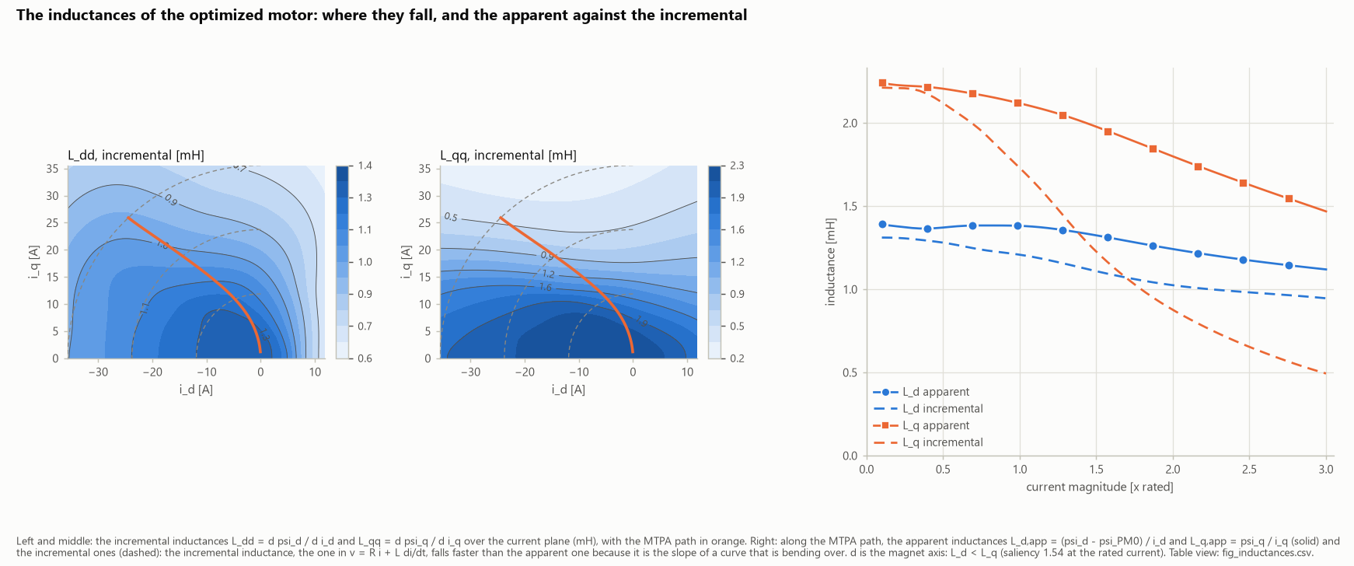
[picture p32: docs/figures/maps/inductances.png]
Apparent and incremental inductances

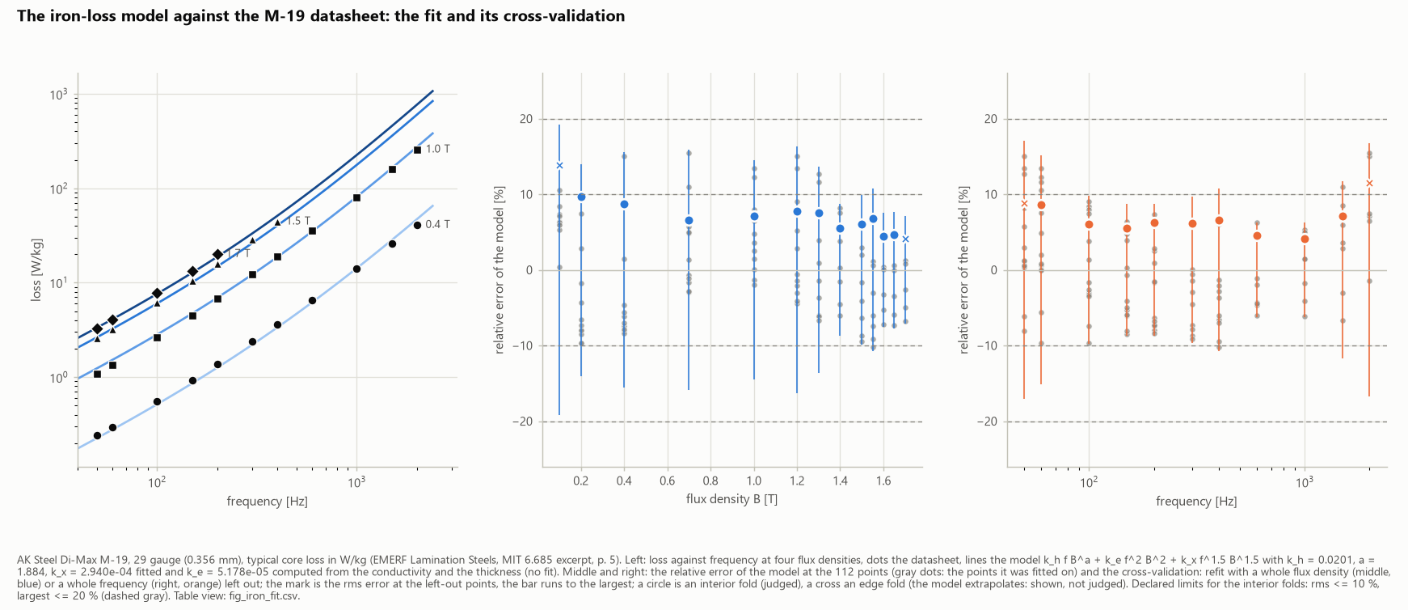
[picture p33: docs/figures/maps/m19-loss-fit.png]
The Bertotti model against the M-19 data

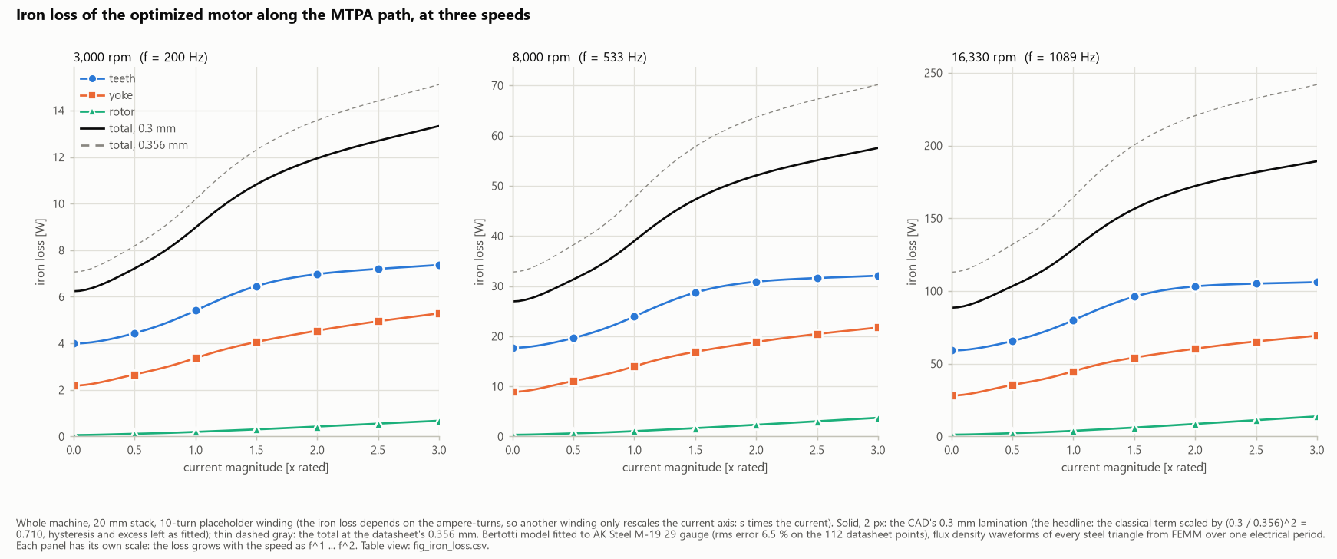
[picture p34: docs/figures/maps/iron-loss.png]
The iron loss along the MTPA path at three speeds, by region


</details>

### 9. The thermal model (November 2026)

**The model:** a lumped thermal network of eleven parts:
- the winding in the slots and its end turns;
- the teeth and the yoke;
- the housing, the end bells and the air in the end spaces;
- the rotor, the magnets, the shaft and the bearings.

Each loss enters at its own part. A steady state solves in a fraction of a millisecond, so the winding study and the motor map can call it at every speed.

**Calibrated first:**
- FEMM's heat flow and CalculiX matched two exact solutions within 0.13 %;
- the network was then checked against a 2D finite-element slice of the stator, and agrees **within 2 %** on the hot spot and on the winding's mean temperature;
- FEMM and CalculiX agree with each other to 0.033 %.

**The cooling** is a fan on the shaft over a finned housing. Its airflow follows the speed, and its own power grows as the cube of the speed, as a load on the shaft.

**What sheds the heat:**
- **with the shaft fan,** forced air over the housing's fins and the end bells carries 73–95 % of it;
- **in still air,** radiation carries 58 %;
- **inside the motor,** the copper in the slots passes about three quarters of its heat to the teeth.

**What limits the rating:** the N45 magnets reach their 80 °C before the winding nears its 155 °C, in every cooling, because the air gap ties the rotor to the stator's temperature. A 150 °C magnet grade would hand the limit to the winding, for 1.4–2.4 × the current.

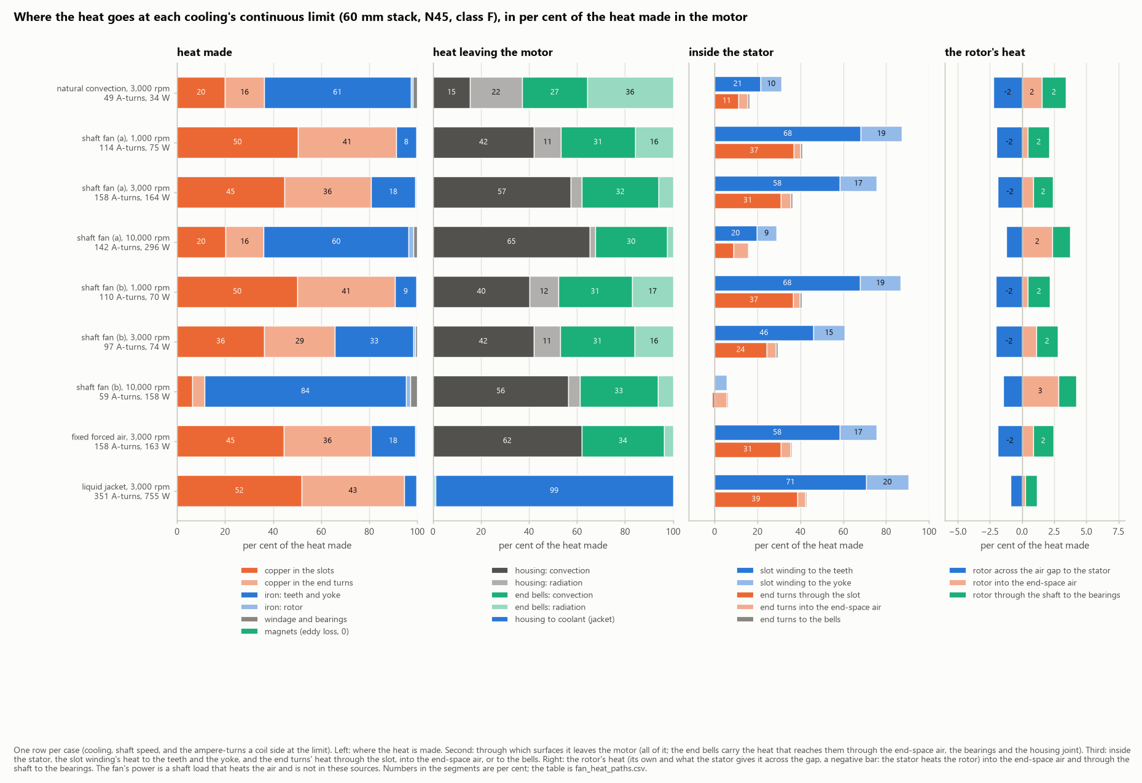
[picture p35: docs/figures/thermal/heat-paths.png]
Where the heat goes at each cooling's continuous limit


<details><summary>More from the thermal model</summary>

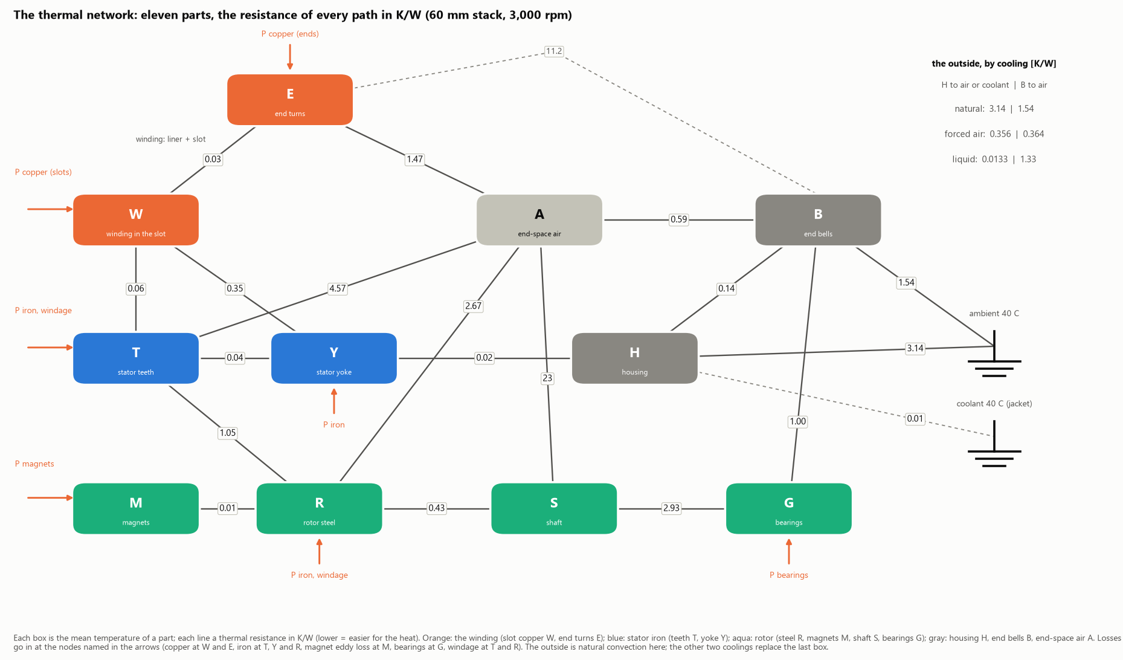
[picture p36: docs/figures/thermal/network.png]
The network and the thermal resistance of every path

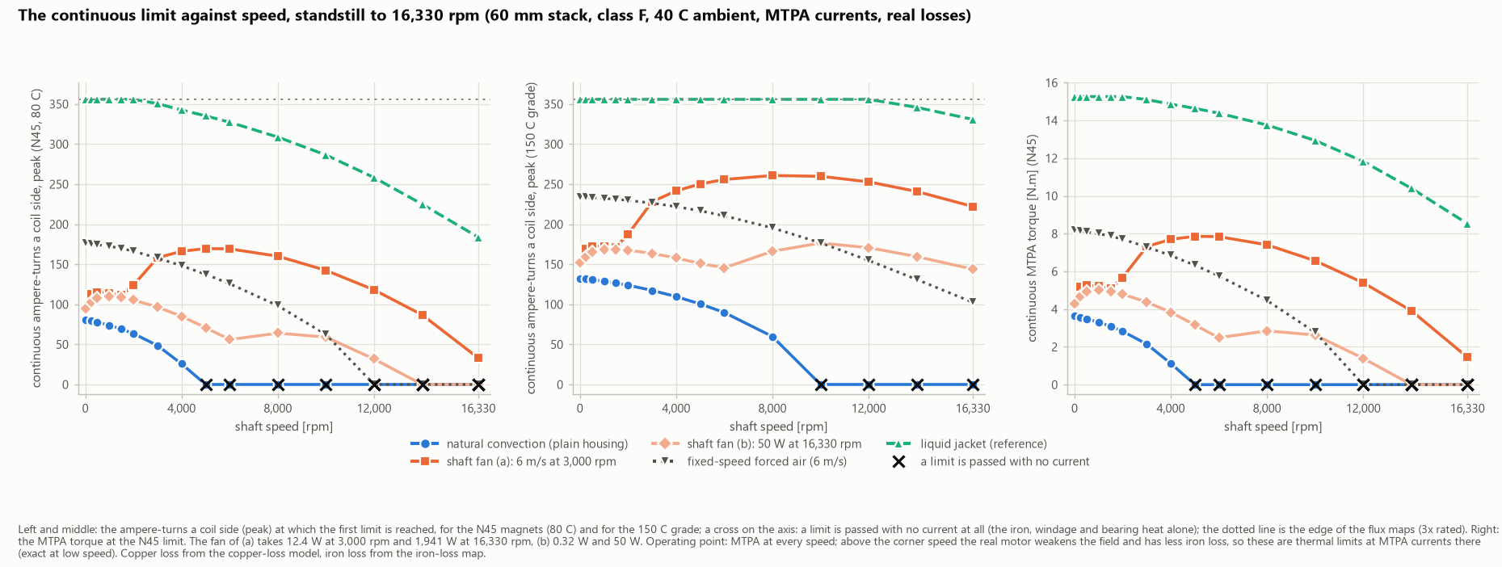
[picture p37: docs/figures/thermal/continuous-limit-vs-speed.png]
The continuous limit against speed for each cooling

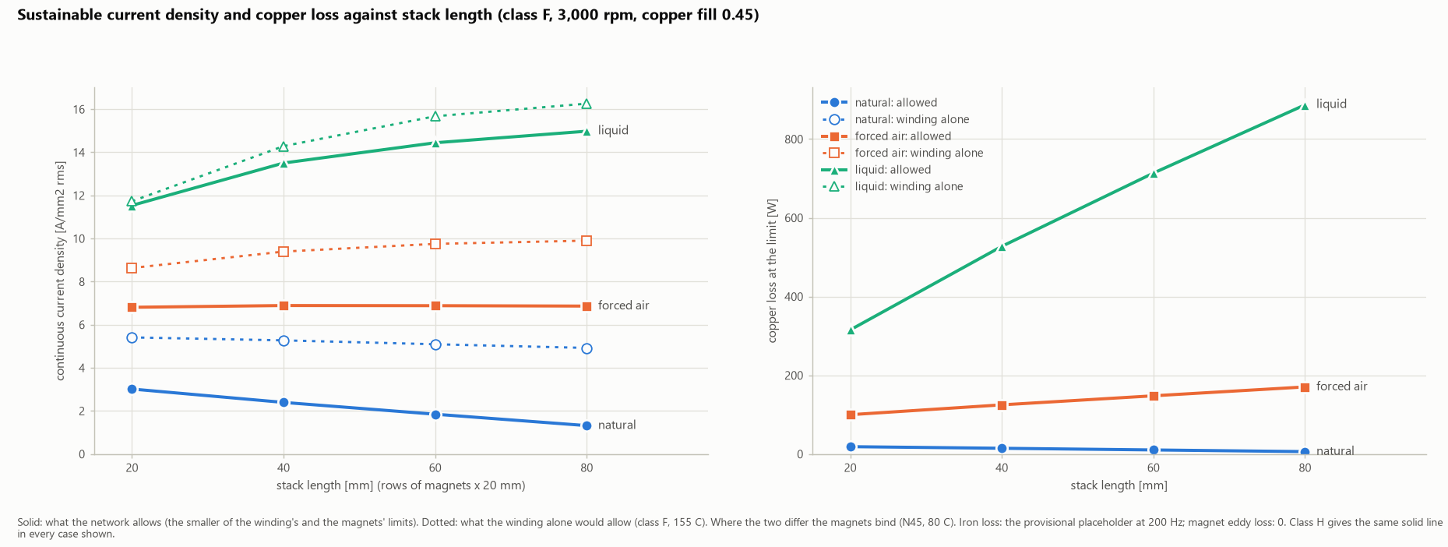
[picture p38: docs/figures/thermal/sustainable-current.png]
The copper loss each cooling can carry, per stack length

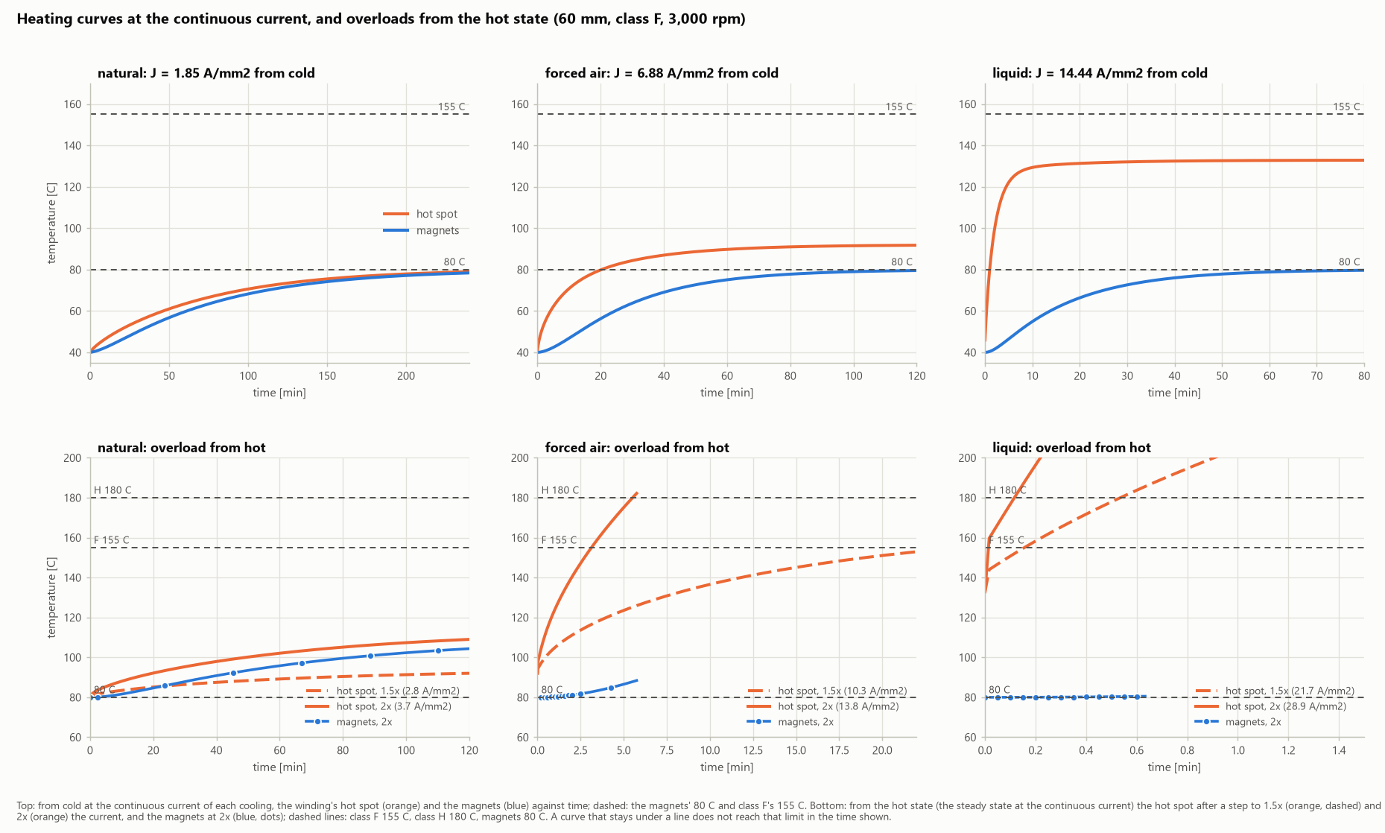
[picture p39: docs/figures/thermal/transients.png]
Heating from cold, and overloads


</details>

### 10. The copper losses and the winding (November 2026)

**The method:**
- FEMM's time-harmonic solver was first checked against the exact solutions for a round wire, over the range of strand sizes the winding uses;
- then the optimized slot was solved strand by strand (416 strands), in the machine's own field over a rotation, with the inverter's PWM ripple and the current circulating between parallel strands.

**What it found:**
- **The proximity loss is small with fine strands:** 0.42 % of the DC loss at 16,330 rpm for 0.315 mm strands, and 1.7 % for 0.63 mm. The PWM ripple adds 0.017 %.
- **The term that matters** is current circulating between a turn's parallel strands when they're spread over the slot's depth: up to 14 % at the top speed, against 0.3–0.4 % when they're bundled together.

**The winding:** every winding that fits the slot, 20,316 of them, was then enumerated against:
- the full copper loss;
- the heat, from the thermal model (step 9);
- the inverter current that the 48 V bus calls for.

The trade-off front shows the choice:
- fewer turns buy speed for current;
- each extra row of magnets raises the current.

The final pick waits for the stack length and the size of the shaft fan.

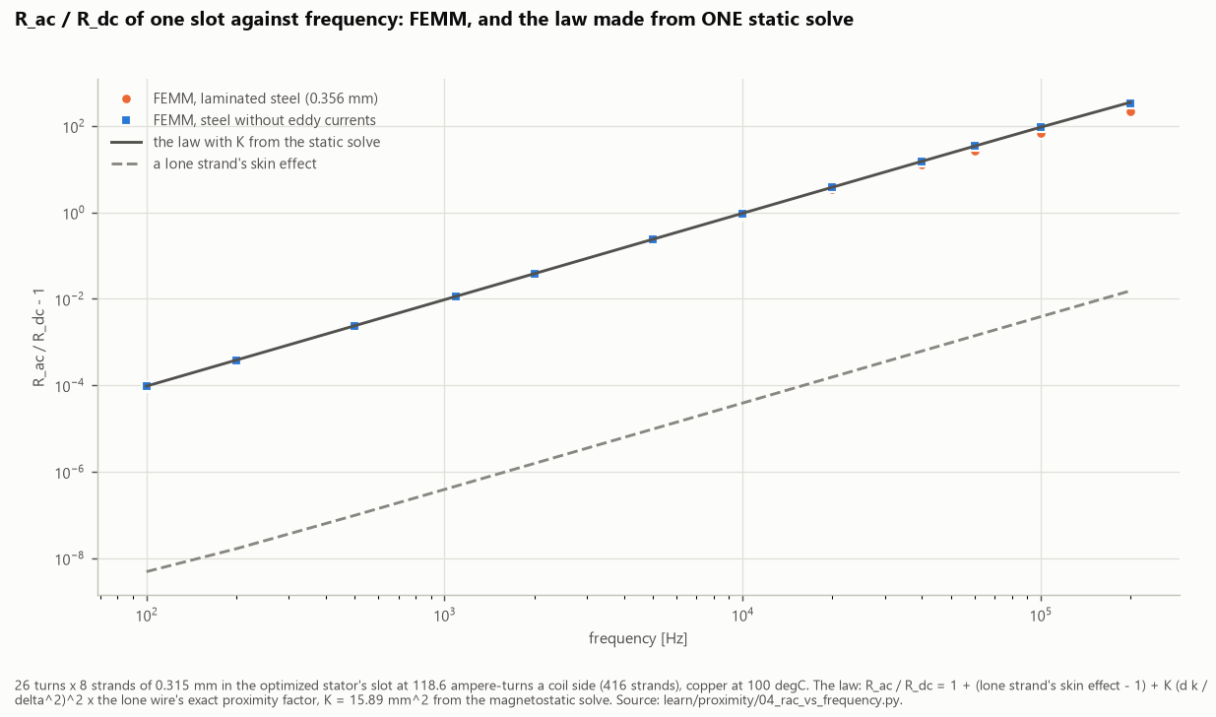
[picture p40: docs/figures/copper-loss/rac-rdc-vs-frequency.png]
R_ac / R_dc against frequency


<details><summary>More on the copper losses and the winding</summary>

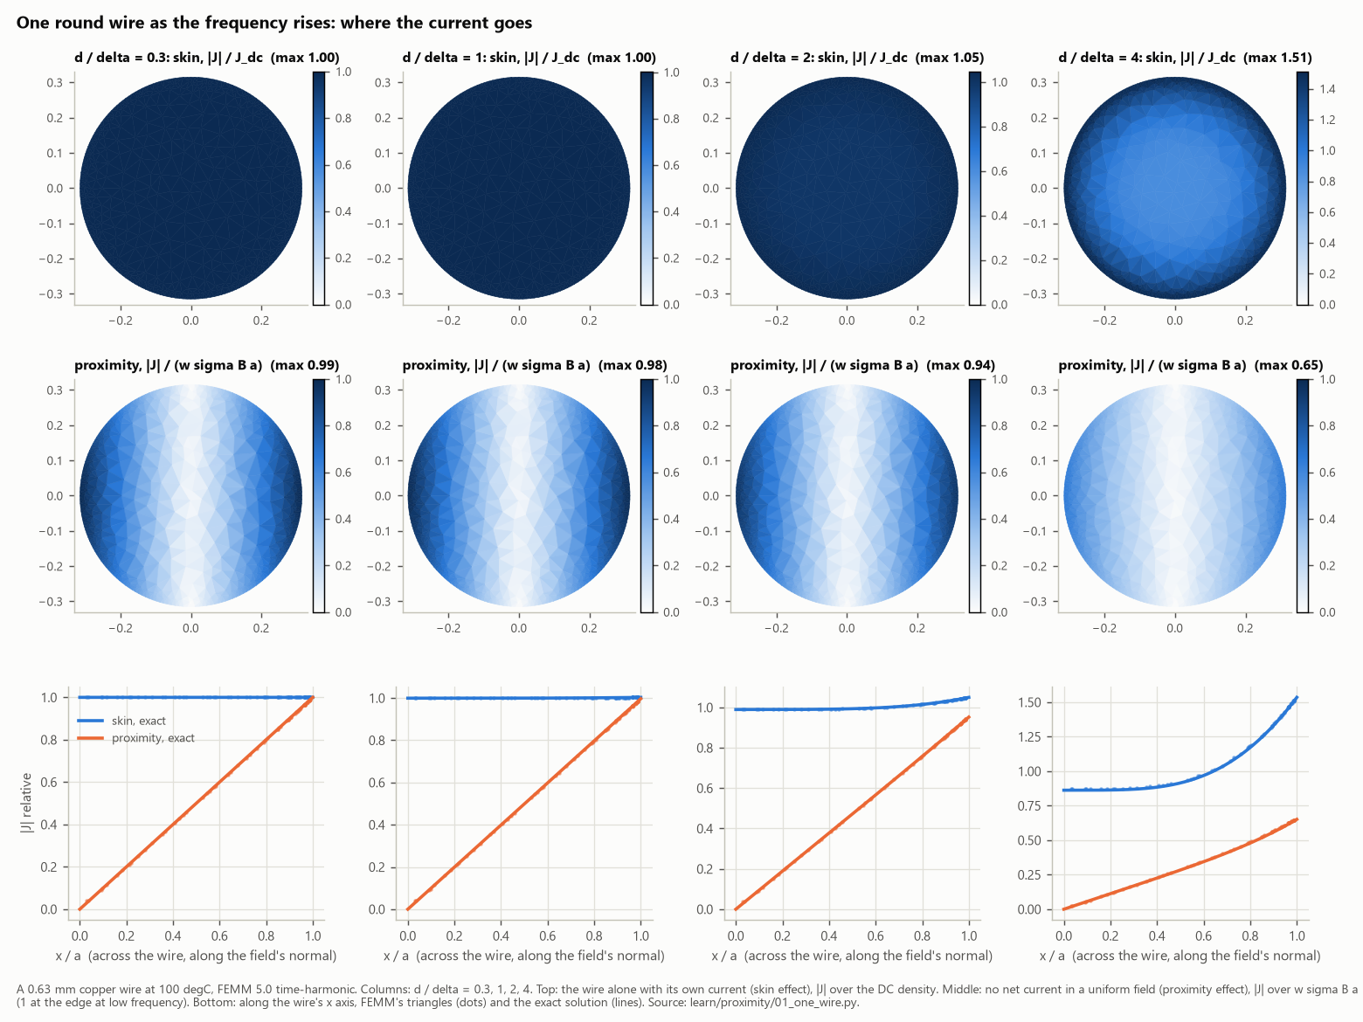
[picture p41: docs/figures/copper-loss/one-wire.png]
One wire: the skin effect

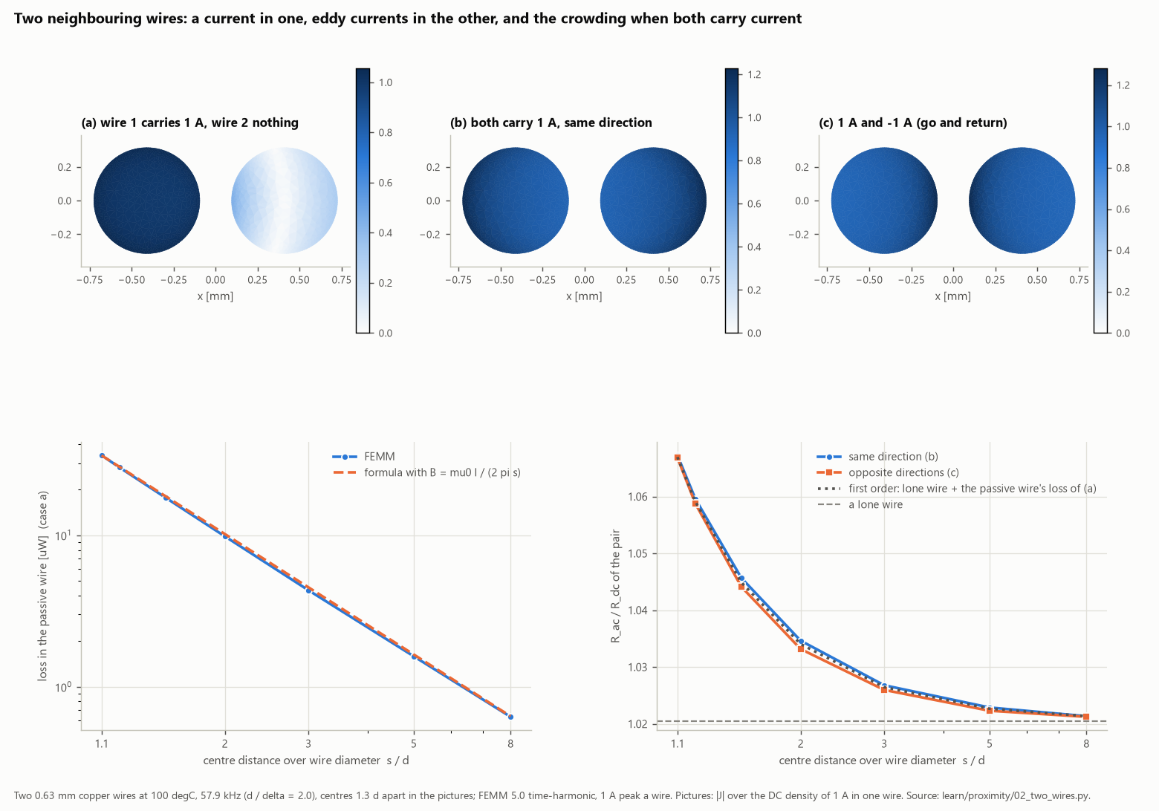
[picture p42: docs/figures/copper-loss/two-wires.png]
Two wires: the proximity effect

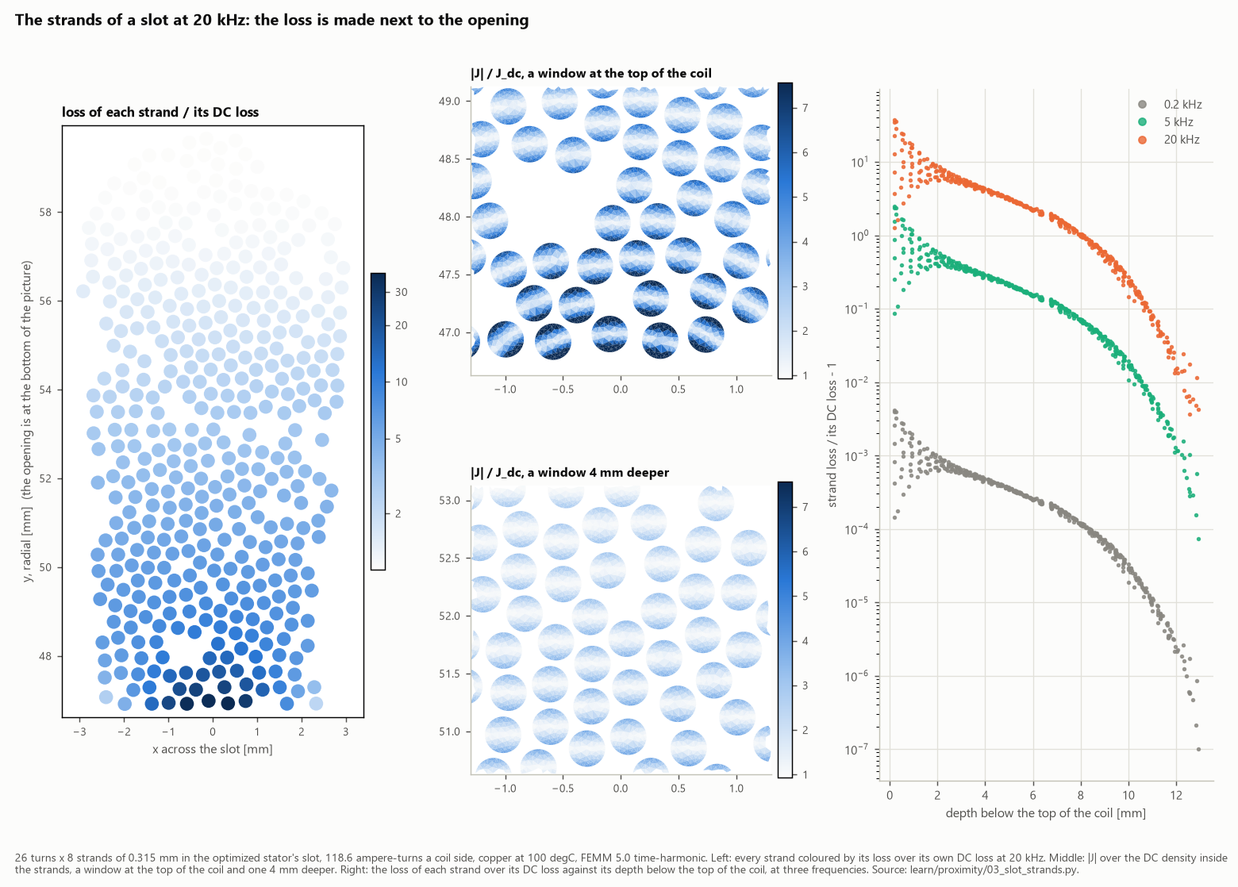
[picture p43: docs/figures/copper-loss/slot-strands-20khz.png]
The slot's strands at 20 kHz

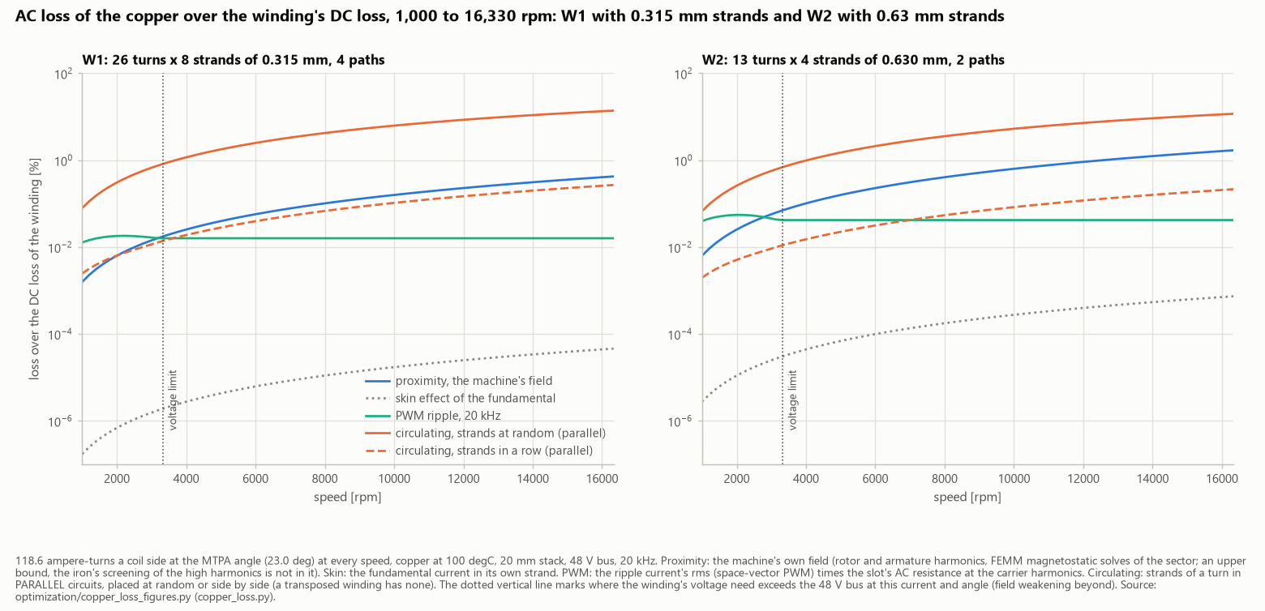
[picture p44: docs/figures/copper-loss/ac-loss-vs-speed.png]
The AC loss against speed

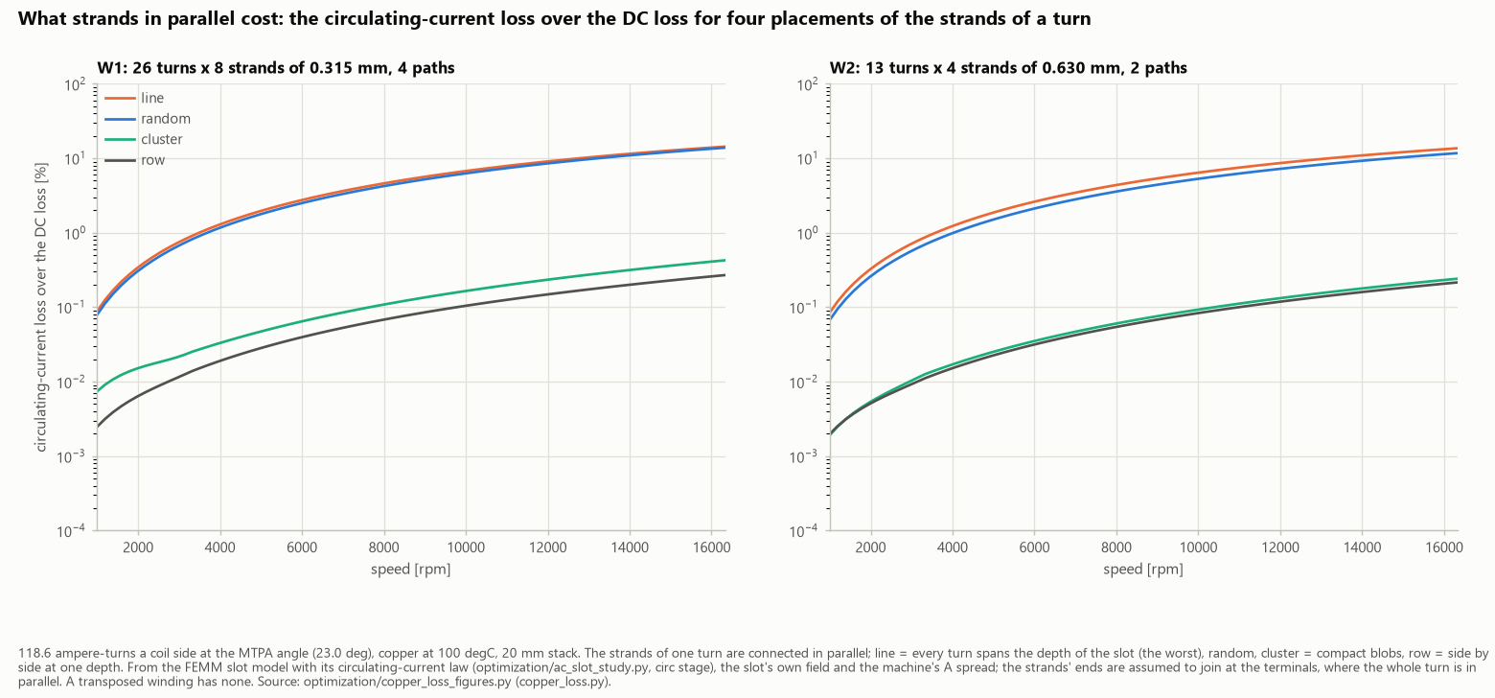
[picture p45: docs/figures/copper-loss/circulating-currents.png]
Circulating currents between parallel strands

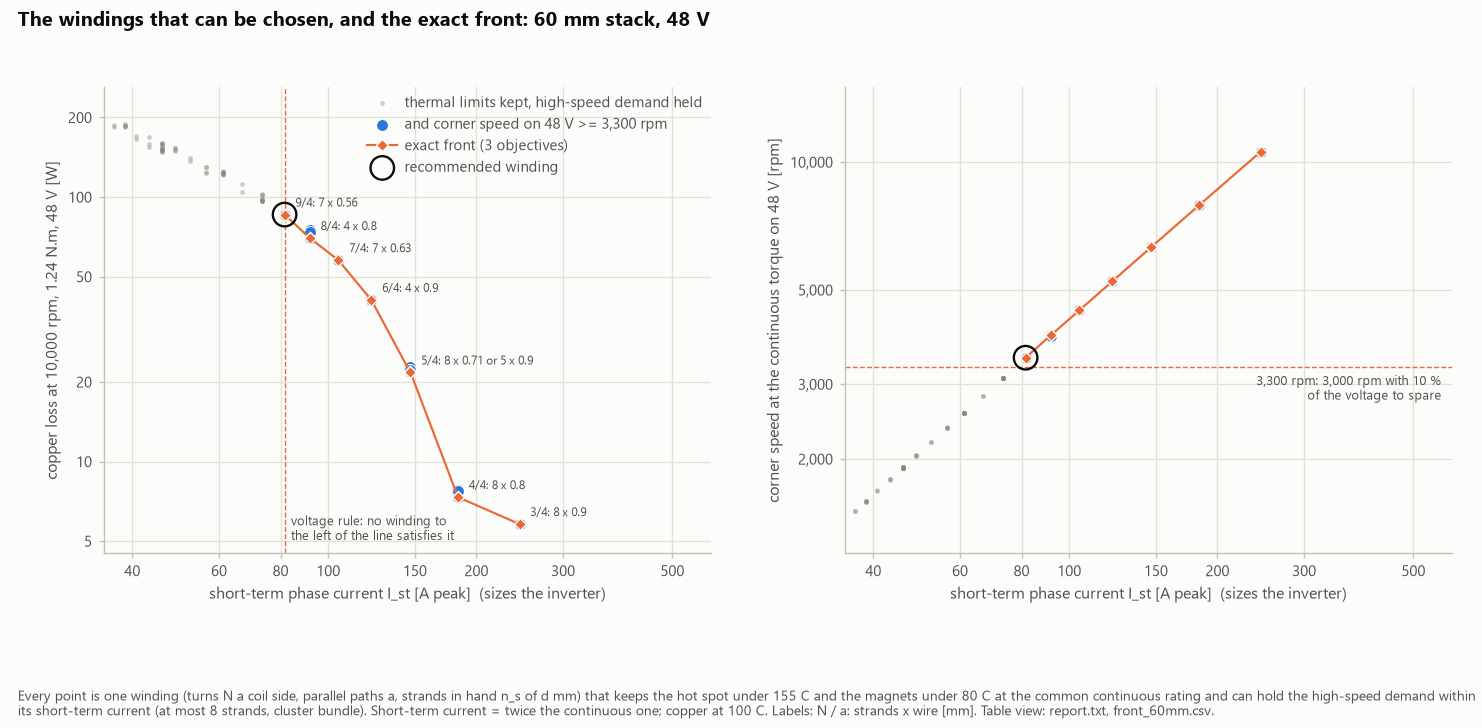
[picture p46: docs/figures/winding/exact-front.png]
Every winding and the exact front

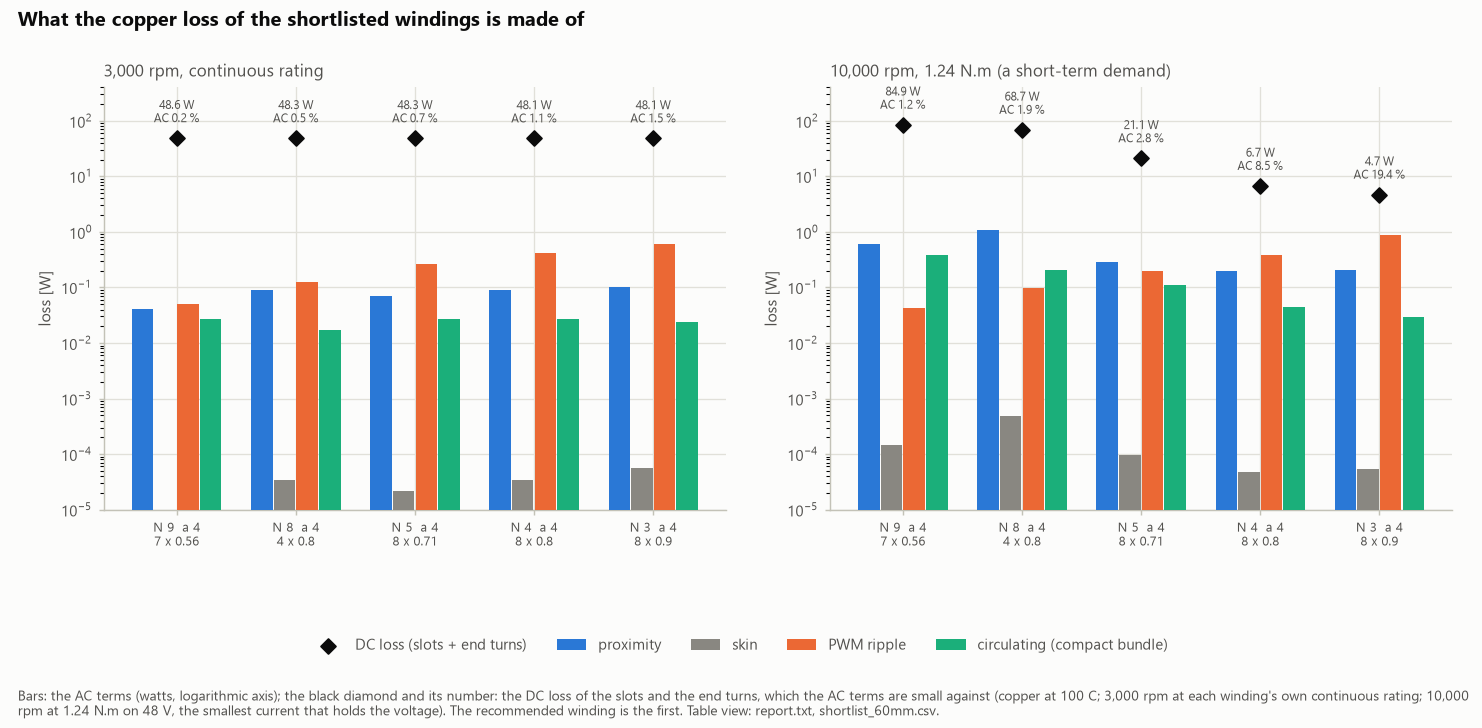
[picture p47: docs/figures/winding/copper-loss-parts.png]
What the copper loss is made of

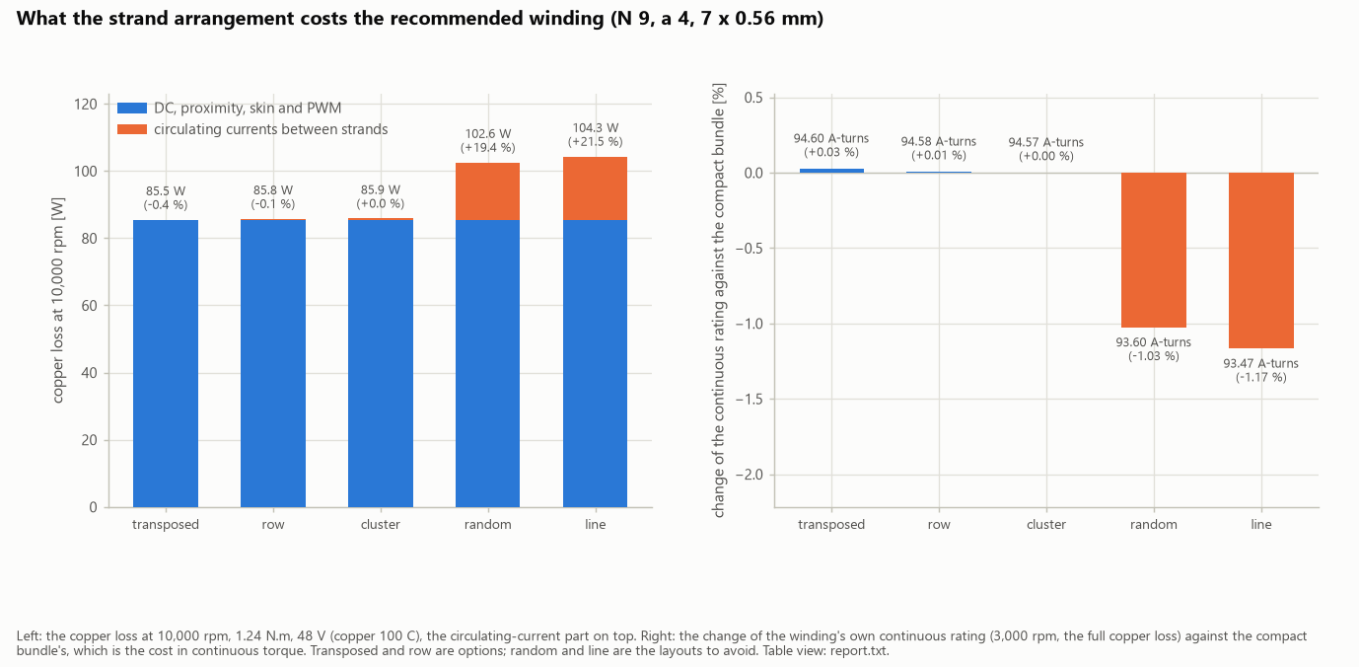
[picture p48: docs/figures/winding/strand-arrangements.png]
The strand arrangements


</details>

### 11. The motor map (November 2026)

The flux maps, the losses and the thermal network combine into what the motor can do across its speed range. [Motor map.md](Motor%20map.md) has every table, figure and assumption.

**On a 60 mm stack and a 48 V bus,** with the smallest of the three shaft fans studied (50 W at the top speed):
- **4.2 N·m continuously** at 3,000 rpm (1.32 kW);
- **8.7 N·m short-term,** up to 2,718 rpm, for about 25 minutes from a cold start;
- **2.97 kW peak,** and still 2.72 kW at 16,330 rpm, the end of the speed range (the rotor's safe speed, on placeholder strength values). The short-term current equals the motor's characteristic current (84 A), so the power stays nearly flat to the top speed;
- **a best efficiency of 95.2 %** (motor only), at 3,746 rpm and 2.9 N·m.

**How it's solved and checked:**
- MTPA, field weakening and MTPV are solved at every speed from the maps;
- the energy balance closes at all 43,493 operating points;
- FEMM re-solves of deep field-weakening points reproduce the maps within 0.016 %.

**Also compared:** three fan sizes, four stack lengths, the winding's alternatives, a 150 °C magnet grade, and natural, external-fan and liquid cooling.

**A note for the inverter:**
- above 4,049 rpm the magnets' own voltage passes the 48 V bus, reaching 194 V at the top speed, so the inverter must hold a field-weakening current at speed;
- an active short circuit is mild here: 84 A steady, and a brake of 0.12 N·m at the top speed.

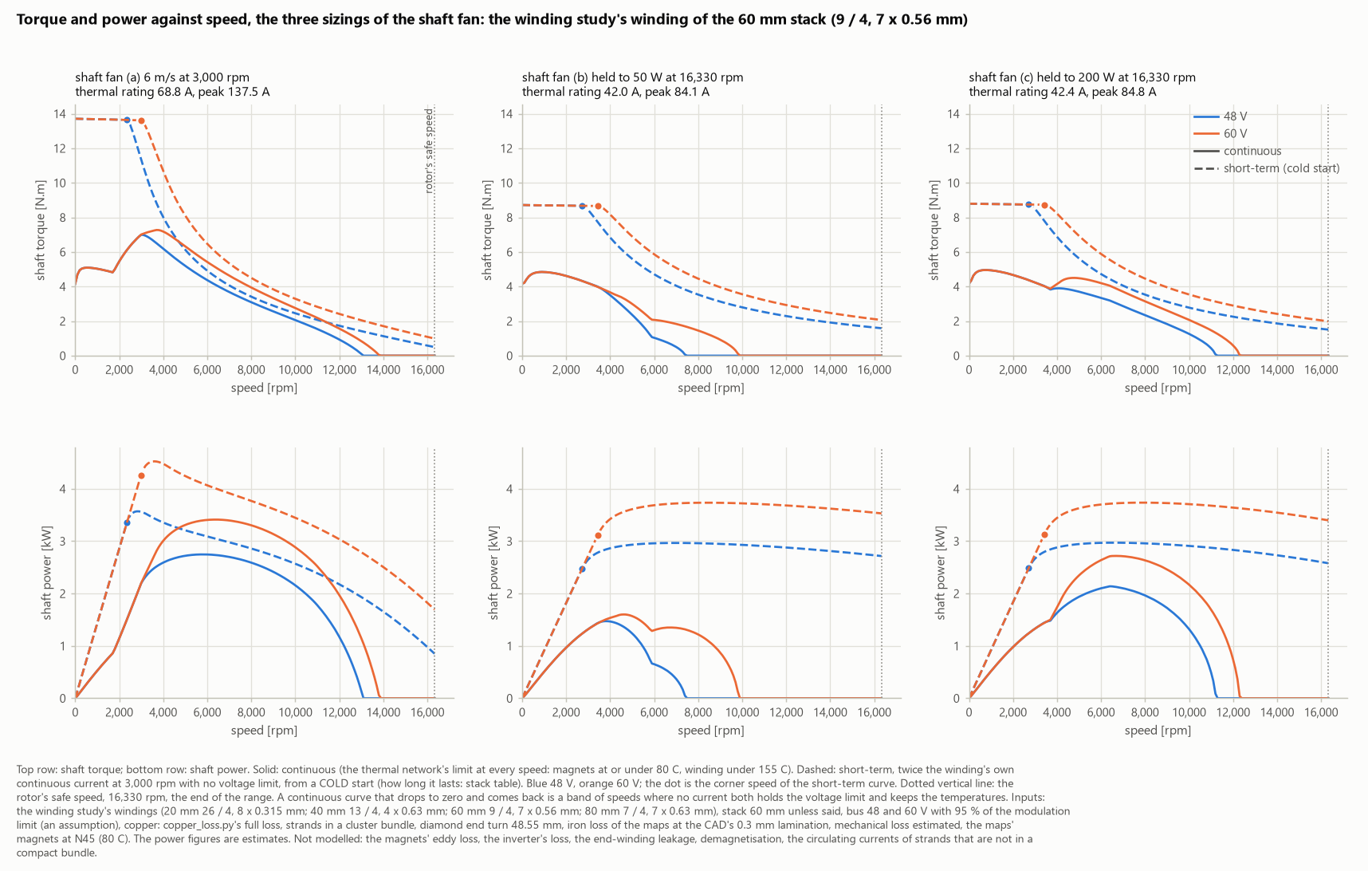
[picture p49: docs/figures/motor-map/envelopes-shaft-fans.png]
Torque and power against speed with the three shaft fans


<details><summary>More from the motor map</summary>

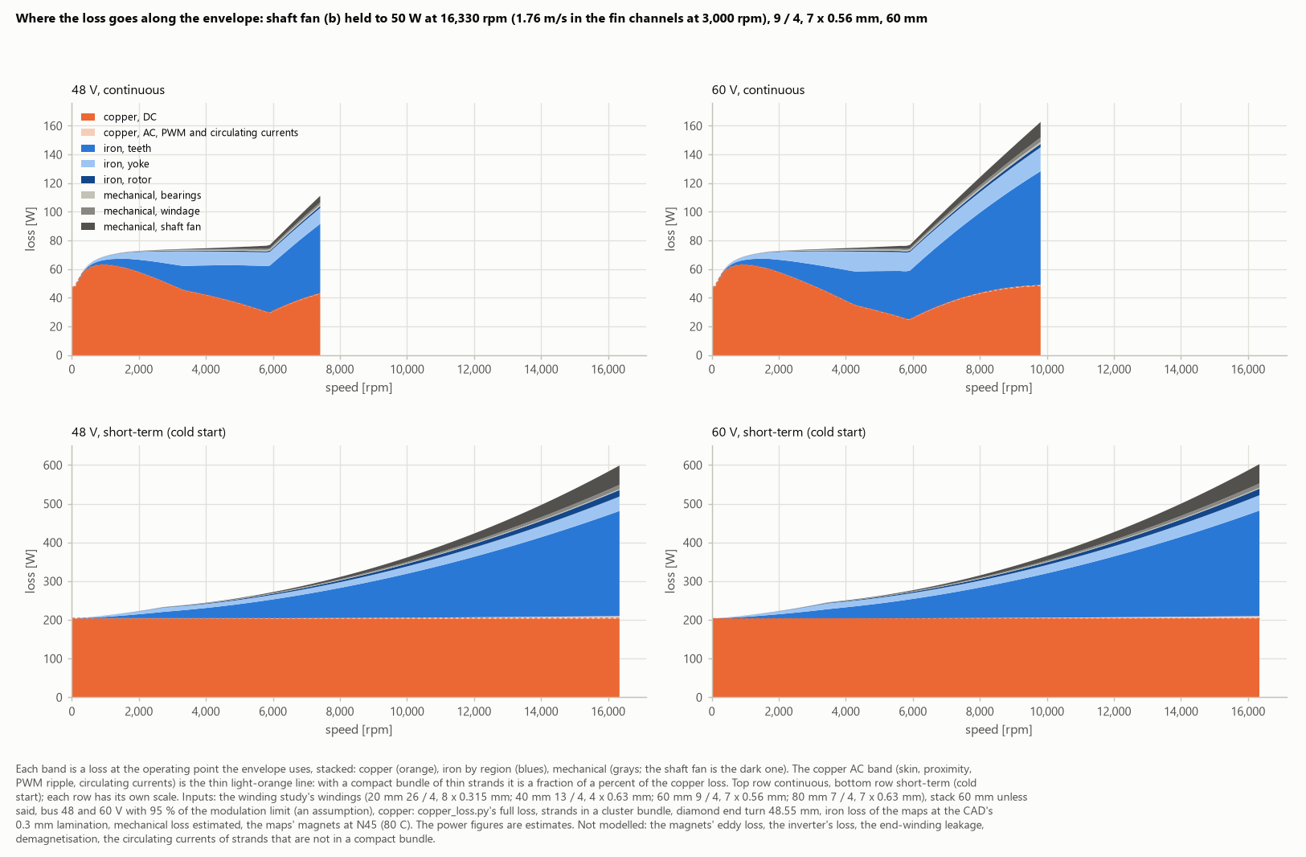
[picture p50: docs/figures/motor-map/losses-fan-b.png]
Where the loss goes along the envelope

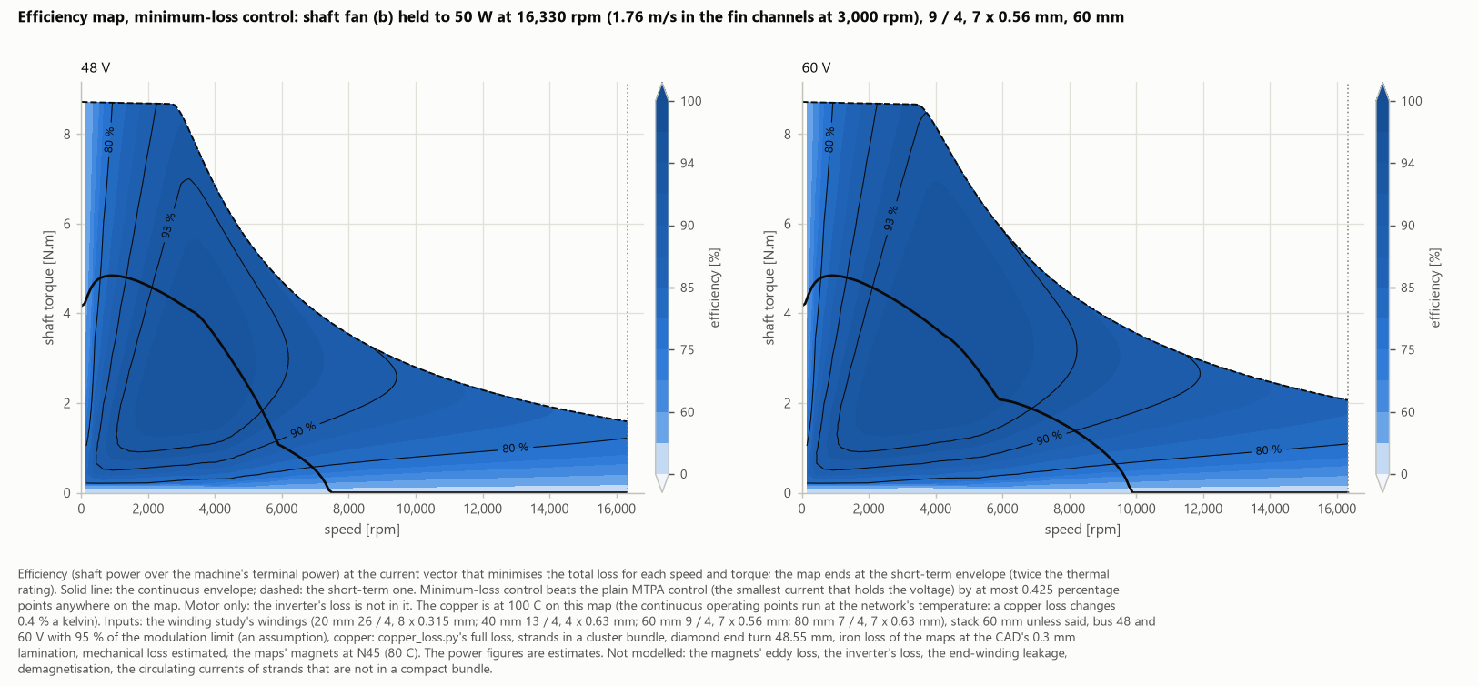
[picture p51: docs/figures/motor-map/efficiency-fan-b.png]
The efficiency map

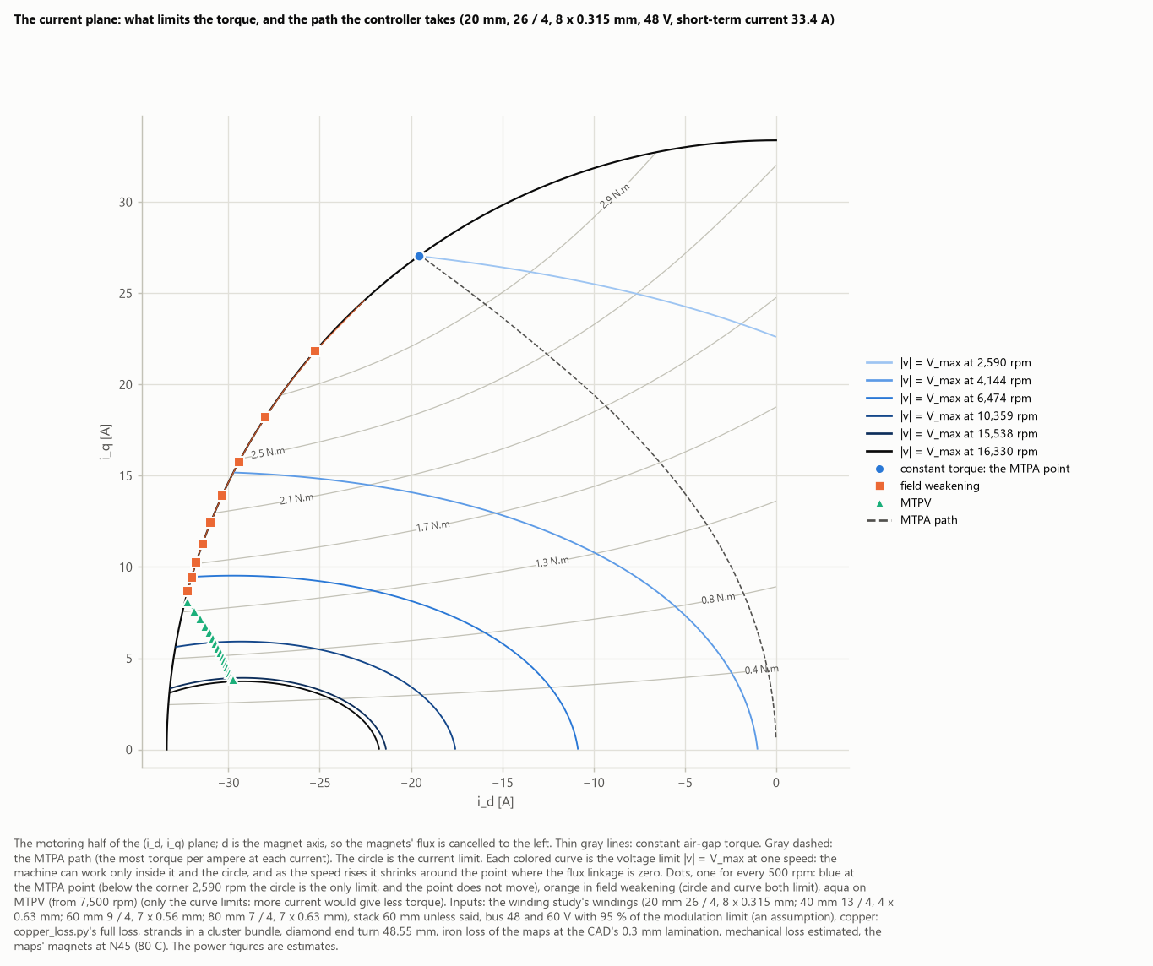
[picture p52: docs/figures/motor-map/current-plane.png]
The current plane: MTPA, field weakening and MTPV

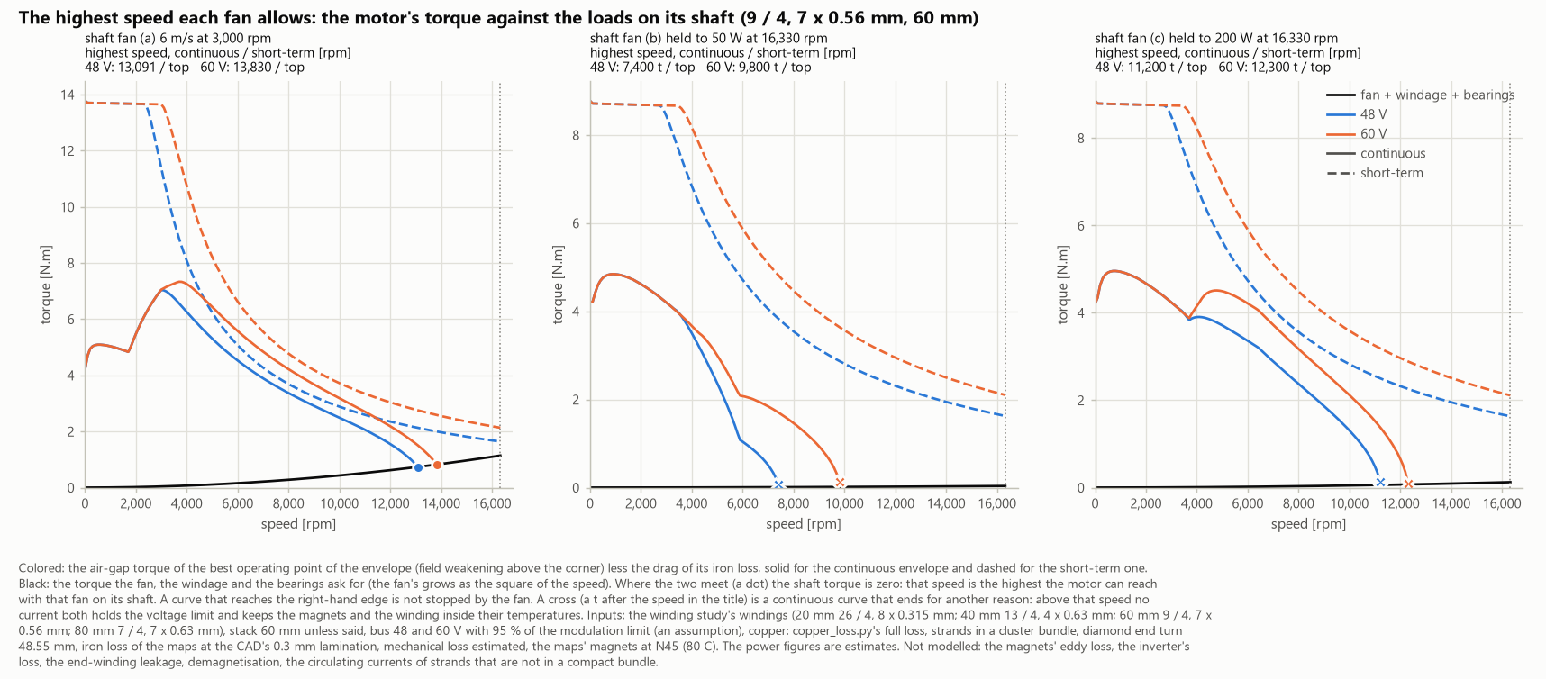
[picture p53: docs/figures/motor-map/top-speed-per-fan.png]
The highest speed each fan allows

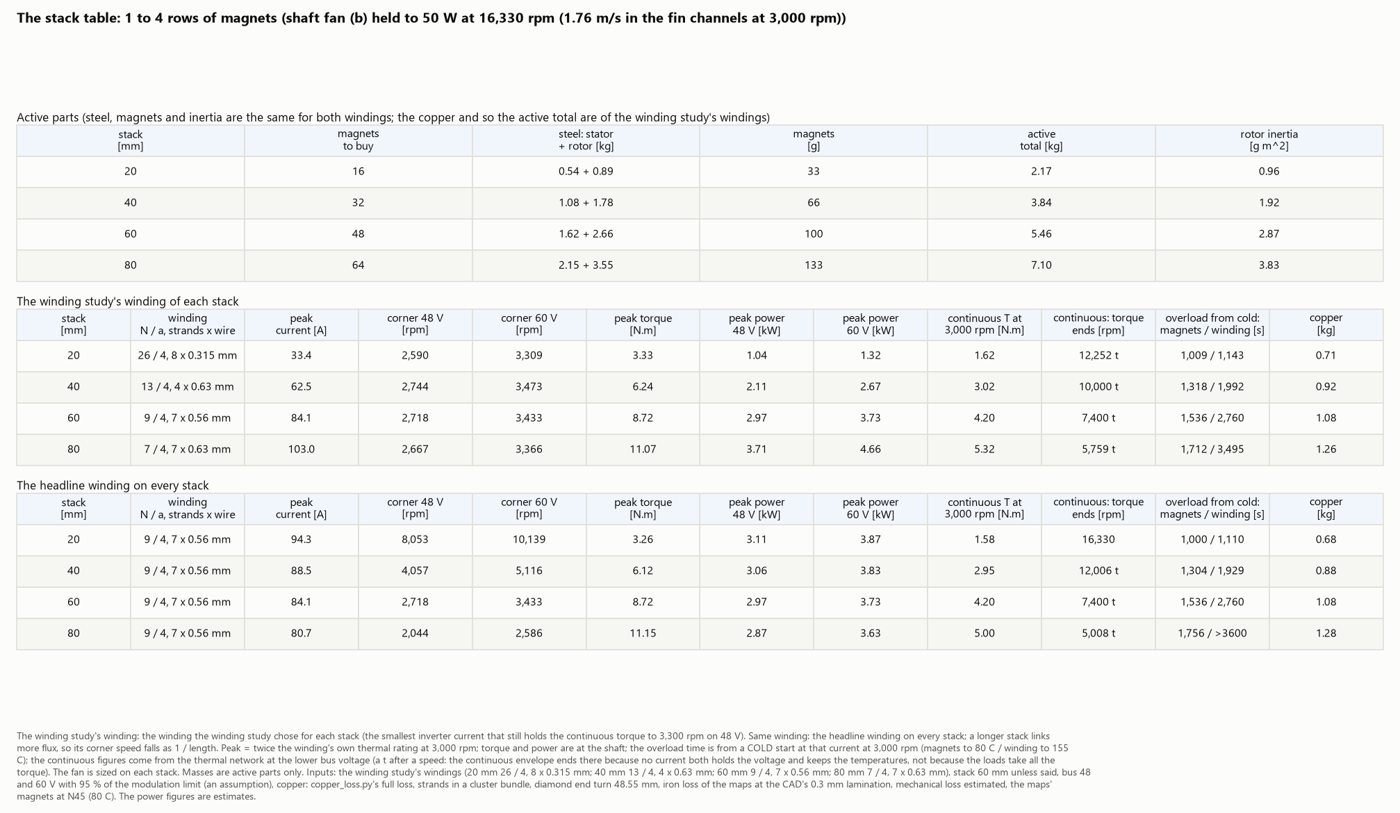
[picture p54: docs/figures/motor-map/stack-table.png]
The stack table

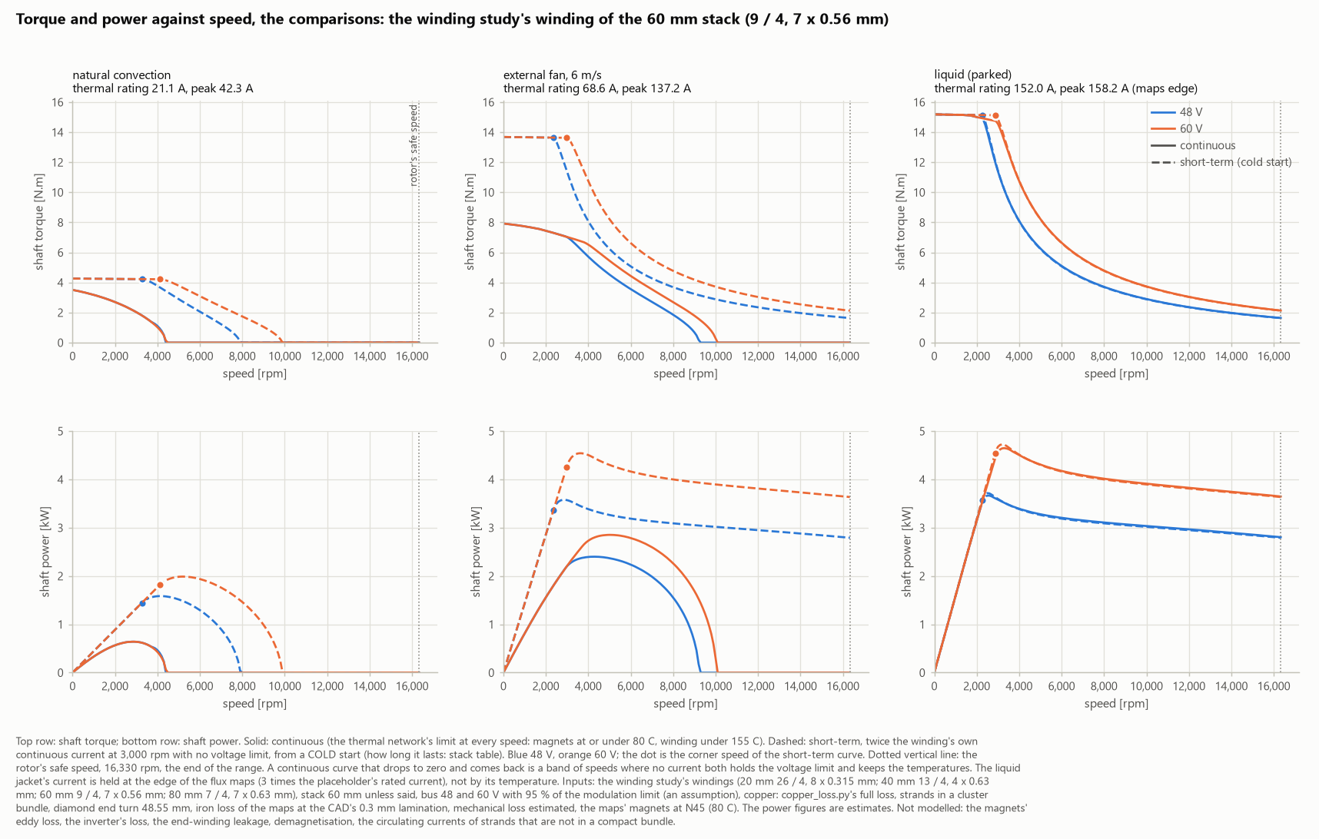
[picture p55: docs/figures/motor-map/envelopes-other-coolings.png]
Natural convection, an external fan and a liquid jacket


</details>

### 12. Next

- **A flux-map-driven Simulink plant:** the validated maps in [`matlab/maps/`](matlab/maps/) go into Simscape's FEM-Parameterized PMSM block, in place of the constant parameters, driven by the FOC loop.
- **Then:**
  - the magnets' demagnetisation and their eddy losses;
  - the rotor in 3D;
  - the protection at speed;
  - the inverter.

## The model-fidelity checklist

| Item | Status |
|---|---|
| Core saturation and cross-saturation | ✅ published (step 8, the flux maps); validated in MATLAB; the Simulink plant next |
| Higher field harmonics | 🟡 measured (air-gap spectrum, back-EMF, ripple); not yet in a plant |
| Hysteresis and iron loss | ✅ published (step 8: Bertotti, per mesh element) |
| Proximity and other AC copper losses | ✅ published (step 10) |
| High-frequency loss, magnet eddy currents | ⬜ Elmer, transient and 3D |
| Torque and inertia scaling with diameter, length and air gap | ⬜ |

## Repository layout

| Path | Contents |
|---|---|
| [`python/`](python/) | The pipeline's code: geometry, FEMM driver, solver queue, studies, optimization, checks and tests ([guide](python/README.md)) |
| [Motor map.md](Motor%20map.md) | What the optimized motor can do: torque, power, losses and efficiency against speed, with every assumption |
| [`matlab/maps/`](matlab/maps/) | The flux maps for Simscape's FEM-Parameterized PMSM block, and the scripts that use them (validated in MATLAB; the Simulink block not yet built) |
| [`docs/figures/`](docs/figures/) | The figures of each step |
| [`docs/explorer/`](docs/explorer/) | The interactive flux page, served by GitHub Pages ([open it](https://bill-gkionis.github.io/IPM-synRM/explorer/)) |
| [`femm/`](femm/) | The first-pass FEMM model and its rotor-sweep screenshots |
| [`matlab/`](matlab/) | The first-pass flux-linkage extraction, the Clarke and Park transforms, the Simulink plants, and `maps/` (above) |
| [`cad/`](cad/) | SolidWorks parts, assembly, drawings and equation files |

FEMM's result files (`.ans`) aren't stored: FEMM regenerates them from the models. The state before the reorganisation is tagged `v0`.

## Running the code

The pipeline was built and run on one Windows PC, with FEMM 5.0 and `uv`. The tool paths live in [`python/config.toml`](python/config.toml) and are set for that machine. A per-machine configuration is planned.

```
cd python
uv sync
uv run pytest -m "not femm"      # the tests that don't need FEMM
uv run python <script>.py        # each script's docstring says what it does and how to run it
```

## How the work is done

Each step runs as a loop:
1. set a goal;
2. decide the step;
3. test it in simulation;
4. check the numbers against a second route;
5. change the decision when the results disagree.

A decision stays a working assumption until a test backs it. The numbers are 2D finite-element estimates (FEMM 5.0 on a 20 mm slice, unless a step says otherwise), and a step says when it scales them.

## License

[Apache-2.0](LICENSE)
