Bill-Gkionis/IPM-synRM/python/README.md

# IPM synRM: the Python code

This folder holds the Python code of an open-source motor-design project: a 36-slot, 8-pole permanent-magnet-assisted
synchronous reluctance motor (IPM synRM). It is the pipeline that draws, solves, optimizes and checks the motor. Python
draws the geometry (`motorgeo`), FEMM 5.0 solves it, optimizers search it, and CalculiX, Elmer, ROSS and SALib verify it,
along with studies of copper losses, windings and heat.

The code is written to be read. Most modules open with a docstring that explains the method, says how to run the file and
what numbers to expect; this README is a guide to those docstrings, grouped by purpose.

It runs on one Windows PC with FEMM 5.0 and [uv](https://docs.astral.sh/uv/). Every program and folder of that PC is named
in [`config.toml`](config.toml), which holds the paths of the PC the code was developed on; a per-machine configuration
is planned.

## Contents

- [Setup and running](#setup-and-running)
- [Tests](#tests)
- [Where the tool paths live](#where-the-tool-paths-live)
- [How heavy runs are organized](#how-heavy-runs-are-organized)
- [Main commands](#main-commands)
- [Guide to the files](#guide-to-the-files): [1 core](#1-the-core), [2 first studies](#2-the-first-studies),
  [3 validation](#3-validation-against-the-original-femm-model-and-against-femm-42),
  [4 tools and test bench](#4-the-tool-checks-and-the-test-bench), [5 materials](#5-the-materials),
  [6 teaching scripts](#6-the-teaching-scripts), [7 optimization study](#7-the-optimization-study),
  [8 rotor stress check](#8-the-rotor-stress-check),
  [9 copper losses and windings](#9-copper-losses-with-the-proximity-effect-and-the-winding-studies),
  [10 thermal, flux maps, motor map](#10-the-thermal-network-the-flux-maps-and-the-motor-map), [11 tests](#11-the-tests)
- [What is not in this folder](#what-is-not-in-this-folder)

## Setup and running

Requirements: Windows, FEMM 5.0 and uv. The tool checks, the test bench and the stress and thermal checks also use
CalculiX, Elmer, PrePoMax and MATLAB (programs named in `config.toml`) and ROSS (in an environment of its own); the Gmsh
Python package and the other libraries come with the environment.

From this folder, in PowerShell:

```
uv sync                          # makes .venv and installs the exact versions in uv.lock
uv run python paths.py           # lists every tool and folder in config.toml; says which program it cannot find
uv run python <script>           # runs any script of this folder with that environment
```

- The environment pins Python 3.13, numpy 2.5.4, scipy 1.18.1, pandas 3.0.6, matplotlib 3.11.2, shapely 2.2.0,
  ezdxf 1.4.5, gmsh 4.15.2, pymoo 0.6.2 and SALib 1.6.0 ([`pyproject.toml`](pyproject.toml), [`uv.lock`](uv.lock)).
  ROSS 3.1.0 is not among them: it pulls in many more packages, so it lives in an environment of its own,
  [`envs/ross`](envs/ross), which `check_tools.py` uses through that environment's python.
- FEMM 5.0 has its own Python binding, `pyfemm-qt` (`import femm`), which talks to FEMM over TCP. `pyproject.toml` links it
  from `D:/Apps/femm-qt/pyfemm`, so FEMM 5.0 must be installed there, or that line changed. It is the one machine path
  outside `config.toml`, because uv reads that file and not the code.
- The numbers quoted in the docstrings and in this guide are FEMM 5.0's (FEMM 5.0.20261101, build 1144, with Python
  3.13.16, run on 2026-11-04 unless a docstring gives another date).
- Scripts write into `out/` (and `runs/` for `evaluate.py`). Both folders are git-ignored; everything in them is
  regenerated by running the scripts again.
- The small teaching scripts in [`learn/`](learn) are run from inside that folder; several modules of
  [`optimization/`](optimization) are run as modules from this one, for example
  `uv run python -m optimization.thermal_fem`. Each docstring gives its own command, and the tables below repeat it.

## Tests

```
uv run pytest -m "not femm"      # the tests that need no FEMM
uv run pytest                    # all tests; the ones marked femm start real FEMM 5.0 processes
```

The tests marked `femm` (21 of them) need FEMM 5.0 and leave nothing running; `tests/conftest.py` quits any FEMM that a
failing test left behind. The others use stand-in processes, made-up data and the real files of this folder, and start no
solver.

**Many tests check the studies' stored results, which the repository does not carry.** They read the results that the studies
write into `out/` (the optimized design, the flux and iron-loss maps, the flux-explorer sweep) and FEMM 4.2's reference outputs
(`femm42-out/`). `out/` is git-ignored and `femm42-out/` is kept outside the repository, so in a fresh clone those tests fail or are
skipped until the studies have run. The table in [section 11](#11-the-tests) names the modules.

Several modules also pin the wording of docstrings and of this README (for example the rows for `bench/` and for
`rulings.py` + `stale.py` in the guide below, and the exit statuses of `check_tools.py`), so a change to those texts shows up as a
test failure.

## Where the tool paths live

[`config.toml`](config.toml) is the one place that names this PC's programs and folders, and [`paths.py`](paths.py) reads it.
No script types a drive path: a script asks for a name, and `tests/test_paths.py` fails if one holds a path of its own.

```
[tools]   femm (FEMM 5.0's folder), ccx, cgx, gmsh, prepomax, elmer, elmergrid, matlab: the programs
[paths]   out, rulings, femm42_out, reference_fem, simulink_plant, motor_structure_mat, dxf_rotor, dxf_rotor_with_band,
          dxf_stator, femm_matlib, docs_figures (the repository's docs/figures): folders and files
[femm]    workers = 8, priority = 'below_normal'
```

```python
import paths
paths.tool("gmsh")                # the program, as a Path; FileNotFoundError naming "gmsh" if it is not there
paths.path("out")                 # a folder or file; a relative entry starts at this folder
paths.setting("femm", "workers")  # a plain value, here the number 8
```

The paths in `config.toml` are those of the PC the code was developed on; a per-machine configuration file is planned, so that
the shared file need not carry one PC's paths. Until then, to change where a program lives, edit its line in `config.toml`
(write a Windows path in single quotes, which keeps the backslashes literal), then run `uv run python paths.py`. It ends with `8 of 8 tools found` when every program is there
(exit status 1 and a `MISSING` row if one is not).

## How heavy runs are organized

One heavy run at a time on the PC: two at once only slow each other down and make the desktop stutter. The code written
for this rule (the bench, `check_tools.py`, `check_queue.py`, the optimization modules) goes through
[`femm_queue.py`](femm_queue.py). It takes one machine-wide slot first (a lock on a file under `out/.femm/`), runs at
below-normal priority under a timeout, runs at most 8 workers or threads (`[femm] workers` in `config.toml`), and ends only
the processes it started itself. `uv run python femm_queue.py` says who holds the slot.

Scripts that start their own FEMMs without taking the slot: `barrier_study.py`, `reference_open.py`, `validate_full.py`,
`optimize_demo.py`, `worker_scaling.py`, `mesh_study.py`, `evaluate.py`, `example.py`, `check_femm.py`,
`validate_fix_zeros.py`, `validation/mesh_checks.py`, `validation/m19_femm5.py` and `validation/run_all.py`, which runs
most of them in turn. Run one of them only while nothing else heavy runs.

## Main commands

Run from this folder.

| What | Command |
|---|---|
| Install the environment | `uv sync` |
| List the configured programs and folders and check they are there | `uv run python paths.py` |
| Check the geometry kernel (no FEMM) | `uv run python check_geometry.py` |
| One-screen tour of `motorgeo`, with a torque sweep in FEMM | `uv run python example.py` |
| Check every tool's round trip | `uv run python check_tools.py [--only femm,gmsh,calculix,prepomax,ross,elmer,salib,pymoo,matlab]` |
| Run the test bench (cases B1 to B9) | `uv run python bench/run_bench.py [--only B1,B3] [--mesh-study]` |
| Run every study script in order and tabulate how each ended | `uv run python validation/run_all.py [--only NAME,...] [--from NAME] [--list]` |
| Compare two sets of results (FEMM 5.0 against FEMM 4.2) | `uv run python validation/compare.py OLD_OUT [NEW_OUT]` |
| List the results that are out of date with the rulings | `uv run python stale.py [folder] [--rulings PATH]` |
| Say who holds the solver slot | `uv run python femm_queue.py` |
| Run the tests without FEMM | `uv run pytest -m "not femm"` |

## Guide to the files

Eleven groups, by purpose. Each table gives, for every file, what it does and how, the command that runs it, and the
headline result where the docstring states one.

### 1. The core

The core is the code that every other script in the folder builds on: the geometry kernel and its writers, the start-up of one private FEMM 5.0 per process, the machine-wide solver slot with its pool of FEMM workers, a reader for FEMM's text files, the file that names the PC's programs and folders, and the bookkeeping that marks stale results. `example.py` at the end runs the chain on one screen. Commands are run from the folder `python/`.

| File | What it does, and how | Run | Result |
|---|---|---|---|
| `motorgeo.py` | The geometry kernel: the cross-section is Python data (lines, arcs, regions) and every tool is a writer. `Params` holds the dimensions (baseline: the hand-drawn `reference/IPM synRM analysis.FEM`, except values marked PLACEHOLDER), `build()` draws one symmetric sector, `check()` flags thin ribs and bridges before any solver runs, `to_femm`, `to_dxf` and `to_gmsh` write the files, and `FemmModel` solves rotor positions. | | |
| `paths.py` + `config.toml` | [config.toml](config.toml) is the one place that names the PC's programs (`[tools]`: FEMM, CalculiX, Gmsh, PrePoMax, Elmer, MATLAB), folders (`[paths]`) and FEMM limits (`[femm]`: 8 workers, below-normal priority). `paths.py` reads it with `tool(name)`, `path(name)` and `setting(section, key)`, so no script types a drive path; a program that moved raises an error naming the line to correct. | `uv run python paths.py [other_config.toml]` | lists every name with its path, then `8 of 8 tools found`, exit status 0 (1 if a tool is missing) |
| `femm_session.py` | One private FEMM 5.0 per Python process. `open_femm()` starts a hidden FEMM on a free port of its own (not the 48015 that an interactive FEMM window answers on) at below-normal priority, set before the start so that FEMM inherits it, and points the `femm.mi_*()` and `femm.mo_*()` calls at it; `close_femm()` quits it. FEMM's folder comes from `config.toml`, else from `FEMM_DIR`. | | |
| `femm_queue.py` | The machine-wide solver slot: one heavy run at a time, an operating-system file lock that is freed when its holder ends, however it ends. `femm_pool(label, ...)` runs up to 8 workers with a FEMM each and retries a task once after ending its stuck worker with its process tree; `run_solver(cmd, ...)` runs any other solver at below-normal priority under a timeout, in a Windows job that ends with its caller. | `uv run python femm_queue.py` | `the solver slot is free`, exit status 0, when nothing runs; exit status 1 while a run holds it |
| `femfile.py` | Reads FEMM's text files without FEMM: the nodes, segments, arcs and block labels of a `.fem`, and the mesh and nodal vector potential of an `.ans`, with the flux density of each first-order triangle. | | |
| `rulings.py` + `stale.py` | `rulings.py` reads `rulings.toml` (one table per design quantity: value, unit, status, source, step, names) and writes `<result>.stamp.json`: a result carries a stamp of the rulings it was computed from, and `stale.py` lists what is out of date and the step to run again. `names` is reserved: a table with a `names` key is always a ruling, so a group may not hold a table called `[group.names]`. | `uv run python stale.py [folder] [--rulings PATH]` | `rulings.toml` is not in the folder, so `stale.py out` exits 2 until one is written (exit 0: nothing is stale, 1: something is); until the studies stamp their results, all are listed as `unstamped` |
| `example.py` | The one-screen tour: builds the baseline rotor, checks it, writes the sector plot, the full DXF, the SolidWorks equations and the Gmsh mesh into `out/`, then one FEMM of its own (see [femm_session.py](femm_session.py)) solves 30 rotor positions over one 60 deg electrical ripple period at `i_q` = 10 A and the script prints the mean torque and the peak-to-peak ripple. | `uv run python example.py` (11 s with FEMM 5.0) | `mean 0.729 N.m, ripple 0.158 N.m peak-to-peak` (coarse mesh) |

### 2. The first studies

The first studies apply the core: their worker processes each open a FEMM of their own through [femm_session.py](femm_session.py) and draw the rotor with `motorgeo.py`. `mesh_study.py` and `worker_scaling.py` check the method (mesh density, number of workers), the air-band study compares the hand-drawn rotor with and without the air band behind each magnet, `evaluate.py`, `optimize_demo.py` and `optimize_plot.py` are a small optimizer demo, and the last three rows are the v1 generator of the interactive flux page (the built page is not in this folder; v2 of the page is published separately). The scripts that use FEMM do not take the solver slot of [femm_queue.py](femm_queue.py), so only one of them should run at a time; outputs go to the git-ignored folders `out/` and `runs/`.

| File | What it does, and how | Run | Result |
|---|---|---|---|
| `mesh_study.py` | Torque over one full on-load ripple period (0 to 60 deg electrical, `i_q` = 10 A) on the coarse and on the fine FEMM mesh, solved on 6 workers. Writes `out/torque_mesh.png` and prints the mean, the ripple and the 6th, 12th, 18th and 24th harmonics. | `uv run python mesh_study.py` (about 7 s with FEMM 5.0) | mean torque 0.7315 N.m on the coarse mesh, 0.7347 N.m on the fine one |
| `worker_scaling.py` | Speed-up against the number of FEMM workers: the same 48 coarse-mesh solves (`i_q` = 10 A) on 1, 2, 4, 6, 8 and 10 workers, each with its own process, FEMM and .fem/.ans files. Writes `out/scaling/scaling.csv`, and a figure if a file name is given. | `uv run python worker_scaling.py [figure.png]` (about 33 s with FEMM 5.0; nothing else should run) | 5.5x on 8 workers and 5.8x on 10, with bit-identical results |
| `barrier_study.py` | The air-band study: the hand-drawn rotor with and without the air band behind each magnet, on the same fine mesh (`--coarse`: the coarse one), so only the band's material changes. Phase 1: no load, cogging and torque against current angle at 4 current levels; phase 2: torque ripple at each variant's own best current angle (MTPA) and field snapshots. 1,070 solves on 8 workers into `out/barrier/`. | `uv run python barrier_study.py [--coarse]` (about 2 min with FEMM 5.0) | at 10 A and each design's best angle: 0.859 N.m with the band (28.0 deg), 1.127 N.m without |
| `barrier_plots.py` | Figures and numbers for the air-band study from the CSVs and .ans files of [barrier_study.py](barrier_study.py), with no FEMM: field maps, magnet close-up, no-load flux linkage and back-EMF, air-gap flux density, cogging, torque against current angle, ripple and inductances. Prints a summary table and writes it to `out/barrier/summary.csv`. | `uv run python barrier_plots.py <output folder>` | |
| `reference_open.py` | The reference point of the air-band study: the magnet inside the band (the earlier prototype layout, `Params(pocket="open")`), with the same tests as the 10 A MTPA sweep of [barrier_study.py](barrier_study.py) on the fine mesh: no-load flux linkage and torque against current angle. Writes `out/barrier/reference_open.csv`. | `uv run python reference_open.py` (about 13 s with FEMM 5.0) | no-load `psi_d` 19.20 mWb, best mean torque 1.265 N.m at 10 A |
| `pf_harmonics.py` | Power factor from the d- and q-axis flux linkages (checked in the time domain) and field harmonics (winding factors, stator MMF, air-gap flux density, back-EMF) of the reference rotor, from FEMM output already on disk, with figures. Reads `out/barrier` and `out/flux_explorer/states.csv`, and imports `flux_explorer_sweep` (below). | `uv run python pf_harmonics.py <figure folder>` | |
| `evaluate.py` | `evaluate(x)`: one optimizer candidate in, one result row out. A candidate is a dict of `Params` overrides; it is drawn and checked without FEMM first, and if it can be built and no rib is too thin, one FEMM of its own solves 15 rotor positions at `i_q` = 10 A, giving mean torque, ripple, magnet mass and q-rib width. Each candidate has private files in `runs/`. | `uv run python evaluate.py` (5 candidates on 4 workers, 6 s with FEMM 5.0) | baseline `T_mean` 0.7289 N.m, `T_ripple` 0.1579 N.m; the last two of the five candidates are rejected without FEMM |
| `optimize_demo.py` | A small NSGA-II run on the reference rotor (8 candidates x 7 generations, coarse mesh): pymoo proposes, `motorgeo.py` draws, shapely checks, FEMM measures at each candidate's own best current angle. Objectives: highest mean torque at 10 A, lowest ripple. The knee design (the best compromise) is written back as a DXF and SolidWorks equations and read back to compare. A demonstration of the loop, not the real study. | `uv run python optimize_demo.py` (about 98 s with FEMM 5.0 on 8 workers) | generation 0: 7 of 8 feasible, best torque 1.0821 N.m; end result 1.112 N.m |
| `optimize_plot.py` | The figure for the optimizer demo: every rotor tried, the Pareto front, the reference design, the knee, and the knee's magnet and band outline beside the reference's, from `out/opt/evaluations.csv` and `pareto_X.npy`. | `uv run python optimize_plot.py <output.png>` | |
| `flux_explorer_sweep.py` | The FEMM sweep behind the interactive flux page (v1): one slider at a time from the first-pass design, 4 sliders x 5 stops = 17 rotors, each with the air band as air and as steel. Per rotor and band, on the coarse mesh, 60 solves: 9 current states at 4 rotor positions give the vector potential on every node (the flux lines) with torque and flux linkages, and further current angles give torque and flux linkages only. Writes `out/flux_explorer/`. | `uv run python flux_explorer_sweep.py` (about 2 min on 8 workers with FEMM 5.0; then `flux_explorer_sweep120.py`, then `flux_explorer_build.py`) | 2,040 solves |
| `flux_explorer_sweep120.py` | The 120 deg electrical end position for the field states of `flux_explorer_sweep.py`: the picture repeats every 120 deg electrical (rotated by 30 deg mechanical), but blending from 90 to 120 deg inside one period needs the 120 deg position on the same mesh, so it is solved explicitly (9 field states per rotor and band). Writes `out/flux_explorer/` files ending `_p120`. | `uv run python flux_explorer_sweep120.py` (after `flux_explorer_sweep.py`; about 20 s on 8 workers with FEMM 5.0) | 306 solves |
| `flux_explorer_build.py` + `flux_explorer_template.html` | Packs the sweep into one self-contained HTML page, `pages/Rotor Flux Explorer.html` (the built page is not in this folder): for each of the 17 rotors the coarse mesh and the vector potential on every node for 2 bands x 9 currents x 5 rotor positions, at 12-bit precision, gzipped and base64-encoded, plus a JSON block of torque and flux linkages, embedded in the template. The footer of the page names the FEMM, the number of solves and the day, read from the installed FEMM and the sweeps' own tables and not typed in; the page loads nothing from the network. | `uv run python flux_explorer_build.py` (after both sweeps) | The page of the FEMM 5.0 sweep is about 17 MB (2,346 solves, 9,580 nodes) |

### 3. Validation against the original FEMM model and against FEMM 4.2

These files hold the code against the original hand-drawn FEMM model and against FEMM 4.2, the program the motor scripts were first run on: the reference files, the top-level checks and validations, and the `validation/` folder.

#### The reference files (`reference/`)

`reference/` holds the files that the checks measure the code against: the hand-drawn FEMM model, three CAD drawings, and the Simulink plant with its parameters. They are kept as they are and only read (the MATLAB checks work on copies). [config.toml](config.toml) names them under `[paths]` (`reference_fem`, `dxf_rotor`, `dxf_rotor_with_band`, `dxf_stator`, `simulink_plant`, `motor_structure_mat`).

| File | What it does, and how | Run | Result |
|---|---|---|---|
| `reference/IPM synRM analysis.FEM` | The hand-drawn full 360 deg FEMM model, kept byte for byte (the committed model with its rotor turned 67.5 deg; its pole-0 d-axis sits at 0.5 deg). Read by `check_vs_fem.py`, `validate_full.py` and `validation/hand_reference_check.py`, never saved: `validate_full.py` works on copies. | | |
| `reference/Rotor.DXF` | The rotor as the CAD exported it on 2026-01-13, byte for byte, read only: the 16 magnet slots only, no air band. `bench/b2_gmsh.py` uses it as the independent check that removing the band from `SynRM rotor.DXF` takes the band and nothing else. | | |
| `reference/SynRM rotor.DXF` | The rotor as the CAD last exported it (2026-01-22), byte for byte, read only. It has the air band (16 pockets, one beside each magnet slot), which the script that reads it (`bench/b2_gmsh.py`) removes in memory. | | |
| `reference/Stator_refined.DXF` | The stator as the CAD exported it (2026-01-13), byte for byte, read only. `bench/b2_gmsh.py` reads it together with the rotor drawing. | | |
| `reference/Improved_plant.slx` | The motor's Simulink plant (the motor as the controller sees it), byte for byte from the repository's `matlab/simulink/` folder. The MATLAB checks of `check_tools.py` work on copies of it and hash the original before and after, so no run can change it. | | |
| `reference/motor structure.mat` | The parameters the plant needs: the workspace variables it is loaded with (the same file as the repository's `matlab/motor structure.mat`). The MATLAB checks of `check_tools.py` handle it like the plant: a copy is used, the original is hashed before and after. | | |

#### The checks and validations at the top level

These scripts sit at the top of `python/`. They check that the geometry kernel builds and refuses what it should and that `motorgeo` draws the hand-drawn reference model (neither needs FEMM), that FEMM gives sane physics at one rotor position, that the solver queue works with real FEMMs, and that the 90 deg slice agrees with the full 360 deg model. Each prints its numbers; the table gives the ones to expect.

| File | What it does, and how | Run | Result |
|---|---|---|---|
| `check_geometry.py` | Geometry-only checks, no FEMM: builds the baseline sector, runs the shapely checks (rib, bridge, tooth and yoke widths), the winding and its factor kw1, a DXF round trip and a Gmsh mesh, and confirms that two infeasible candidates (`v_half_deg` 55, `mag_x` 38.4) are caught before any solver runs. Writes its files to `out/`. | `uv run python check_geometry.py` | 40 regions, kw1 = 0.9452, DXF round trip within +0.030 % |
| `check_vs_fem.py` | Does `motorgeo` reproduce the hand-drawn FEMM model? Compares region areas, the winding and the magnet directions of `motorgeo`'s 90 deg sector with the reference .FEM (rotor and stator shifted separately, because the .FEM was saved at another rotor position) and writes an overlay plot, `out/check_vs_fem.png`. No FEMM. | `uv run python check_vs_fem.py [model.FEM]` (default: the reference .FEM of config.toml) | Rotor steel, bands and magnets 0.000 %, stator steel -0.009 %; slot 54.127 against 54.152 mm2; the winding is the mirror of the .FEM's |
| `check_femm.py` | Physics sanity checks on the baseline model at one rotor position: four (id, iq) solves in a FEMM of its own, printing flux linkages and three torques (air-gap element `T_age`, weighted stress tensor `T_wst`, flux linkages `T_dq`). Expects psi_q close to 0 at no load, `T_age` and `T_wst` within 0.1 %, and more torque for id < 0 than id > 0 (Ld < Lq). | `uv run python check_femm.py [--fine]` (`--fine`: the fine mesh) | Coarse mesh (9,580 nodes): `T_age` 0.8087 and `T_wst` 0.8085 N.m at iq = 10 A; no-load psi_d / psi_q 11.991 / 0.031 mWb |
| `check_queue.py` | The live check of [femm_queue.py](femm_queue.py) with real FEMMs: two FEMM pool jobs and one `run_solver` call start within three seconds of each other and must take turns for the one solver slot, with no overlap, every worker and FEMM at below-normal priority, and no FEMM left running afterwards. | `uv run python check_queue.py [--hold SECONDS]` (about 9 s; it takes the real solver slot, so nothing else heavy should run meanwhile) | `PASS`: the three runs took turns, none overlapped, nothing is left running (8.9 s in each of three runs) |
| `validate_full.py` | Is the 90 deg `motorgeo` slice the same machine as the full 360 deg hand-drawn .FEM? Both get a fixed stator field while the rotor turns through one electrical period, at no load and at 10 A, and phase-A flux linkage and torque are compared. 96 solves on 8 workers (about 27 s with FEMM 5.0) on copies of the .FEM; writes `out/validate/validate.csv`. | `uv run python validate_full.py` | The slice is within 1.13 % of the full model on flux linkage and within 1.43 % on the peak torque at 10 A (FEMM 4.2: 1.15 % and 1.48 %) |
| `validate_fix_zeros.py` | Re-solves the rows of `out/validate/validate.csv` whose slice flux linkage came back as exactly 0.0 (an anomaly of the FEMM 4.2 run, caused by two jobs sharing one file name), one fresh FEMM per point, and patches the table. It stays as the check that no slice row is 0.0 and as the repair for a table made by an older `validate_full.py`. | `uv run python validate_fix_zeros.py` (after `validate_full.py`) | With FEMM 5.0 it prints `0 rows to re-solve` (FEMM 4.2: 11 of the 24 no-current slice solves returned psi_a = 0.000) |

#### The validation/ folder (FEMM 5.0 against FEMM 4.2)

`validation/` holds the tools that compared FEMM 5.0 with FEMM 4.2, the program the motor scripts were first run on. They re-run the scripts on FEMM 5.0, show that both programs were given the same model, compare the numbers one by one and test whether mesh density explains the differences. FEMM 4.2's reference outputs are the folder `femm42-out/`, which is not in this folder; the written report is kept in the project notes.

| File | What it does, and how | Run | Result |
|---|---|---|---|
| `validation/run_all.py` | Re-runs the project's scripts on FEMM 5.0 from a table of 33 steps, one at a time, with a log per step and a table `out/validation/run_all.csv` of how each ended (exit code, seconds, FEMM programs left running, status). It judges how a step ended, not its numbers. Its flux-page steps run the `flux_explorer_*` scripts of section 2. | `uv run python validation/run_all.py [--list] [--only NAME[,NAME...]] [--from NAME] [--timeout-factor N]` | All 33 steps in about 9 minutes on FEMM 5.0 (FEMM 4.2: 2 h 13 min) |
| `validation/compare.py` | Puts every number FEMM 4.2 left (`femm42-out/`, not in this folder) beside FEMM 5.0's, with a verdict against a tolerance: 1 % (fine mesh) or 2 % (coarse) for torques and flux linkages, 10 % for ripple, cogging and harmonics. Writes `femm5_vs_femm42.csv`; its flux-page check imports `flux_explorer_sweep` and reads the built page, `pages/Rotor Flux Explorer.html` (not in this folder). | `uv run python validation/compare.py femm42-out [out] [--csv FILE] [--detail FILE] [--audit]` (after `validation/run_all.py`) | 350 verdicts, 19 of them FLAG (each explained in the written report) and 1 DIFFERS (a picture); the others are identical, ok or info |
| `validation/mesh_checks.py` | Tests whether mesh density explains the FEMM 4.2 / 5.0 differences: solves the model again on FEMM 5.0 at FEMM 4.2's node count and on a ladder of five or six densities (only the mesh sizes change), and re-reads FEMM 4.2's saved solutions. Thirteen parts, about 23 min. Reads `femm42-out/` (not in this folder) and imports `flux_explorer_sweep`. | `uv run python validation/mesh_checks.py femm42-out [--only calibrate,slice,states,post42]` | At FEMM 4.2's node count FEMM 5.0 gives the cogging torque within 0.2 % of FEMM 4.2's (7 % high at its own); mean torques and magnet flux line up only at 45k to 70k nodes |
| `validation/provenance.py` | Four analyses of other scripts' output files, for the written report's numbers that no other script prints: the psi_d offset, the worst air-gap flux density samples, CSV values pandas reads slightly off, and the differing pixels of `check_vs_fem.png`. No FEMM. Needs `femm42-out/` (not in this folder) and, via `mesh_checks.py`, `flux_explorer_sweep`. | `uv run python validation/provenance.py femm42-out [--only offset,gap,pandas,picture]` | psi_d offset +0.0392 mWb with band; 27 of 192 parameters read one unit in the last place off by pandas; 850 of 1,901,250 pixels differ |
| `validation/m19_femm5.py` | Puts numbers on what would change if the model used FEMM 5.0's "M-19 14 mil" instead of FEMM 4.2's "M-19 Steel", which the model keeps on both programs: each curve's H at 0.5 to 1.8 T against the steel maker's DC curve, then `check_femm.py`'s four solves with each steel and with curve and fill factor mixed (about 20 s, one FEMM). | `uv run python validation/m19_femm5.py` | FEMM 5.0's steel as the library has it moves the torque by 2 to 7 % and psi_d by 4 % |
| `validation/same_model.py` | Checks without FEMM whether two `.fem` files are the same model: both are read into numbers and names and compared (boundaries, materials with their B-H points, circuits, nodes, segments, arcs, labels) to a tolerance; formatting, comment and order are listed apart and never decide. Exit 0 = same model, 1 = a difference, 2 = unreadable. | `uv run python validation/same_model.py OLD.fem NEW.fem [--rtol 1e-9]` | The `check_femm.py` model on FEMM 5.0 against FEMM 4.2's: `MODEL DIFFERENCES: 0` (167 nodes, 40 labels compared), `RESULT: the same model` |
| `validation/hand_reference_check.py` | Checks that the hand-drawn reference .FEM is still the model `validate_full.py` works on: the three changes that script makes (air-gap label to group 0, rotor turned, currents set) are applied to the reference as plain arithmetic and compared, with `same_model.py`, with one of that script's copies (`--job K`). Exit 0 = the same model. | `uv run python validation/hand_reference_check.py HAND.fem [--job K] [--reference REF.fem]` | 984 plain differences fall to 0 once the three changes are applied (FEMM 4.2 copy of job 0; the same holds for each of the 48 copies) |
| `validation/compare_materials.py` | Compares two runs of the `materials/` scripts key by key: the JSON files in `out/materials/` (keys, list lengths, numbers to a tolerance, default exactly equal), the CSV line by line, and with `--figures` the PNG files pixel by pixel. When only FEMM changes, only numbers measured on solved fields (`fields.json`, parts of `magnetic.json`) can move. | `uv run python validation/compare_materials.py OLD_DIR NEW_DIR [--rtol 0] [--figures]` | |
| `validation/README.md` | Says that the written report on FEMM 5.0 against FEMM 4.2 is kept in the project notes, lists what stays in this folder (the table, four of the scripts, a copy of each figure) and names FEMM 4.2's run, `femm42-out/`, as read only, with its SHA-256 list. | | |
| `validation/femm5_vs_femm42.csv` | The table `compare.py` writes: one row per compared number or group (columns study, quantity, femm42, femm50, delta_pct, verdict, kind, limit_pct, plain_pct, n, n_flagged, n_plain_flagged, note). A group of numbers writes three lines: the median, the 95th percentile and the maximum of its differences. | | 462 data lines for 350 verdicts |
| `validation/m19_curves.png` | Figure of `m19_femm5.py`: left, the B-H curves of FEMM 4.2's "M-19 Steel", FEMM 5.0's "M-19 14 mil" and the maker's 16 points; right, the H each library curve needs against the maker's at the same B, in percent. The script copies it here from `out/validation/`. | | |
| `validation/mesh_convergence.png` | Figure of `mesh_checks.py` (part `figure`): cogging torque, torque harmonic 24, magnet flux linkage, mean torque, psi_d and the worst air-gap flux density sample against node count, for FEMM 5.0 at several mesh densities (smart mesh off and on) and FEMM 4.2 at its own. The script copies it here from `out/validation/mesh/`. | | |

### 4. The tool checks and the test bench

The tool checks show, one tool at a time, that each program of the pipeline gives a known answer when driven from Python. The test bench then uses the tools on the motor itself.

#### The tool checks (`check_tools.py` and `checks/`)

These files check that each tool the pipeline depends on (FEMM, Gmsh, CalculiX, PrePoMax, ROSS, Elmer, SALib, pymoo and MATLAB) gives one known answer, driven from Python the way the pipeline drives it, before the tool is used on the motor. `check_tools.py` runs one case per tool from the modules of `checks/`, prints a table and exits 0 only when every row passes; the commands run from `python/`, and the numbers are those of the run of 2026-11-06. Every tool's program runs through [`femm_queue.run_solver`](femm_queue.py), one at a time, at below-normal priority and in a Windows job that ends with the run (the in-process Python libraries Gmsh, SALib and pymoo take no slot).

| File | What it does, and how | Run | Result |
|---|---|---|---|
| `check_tools.py` | Runs the known-answer case of each tool, one at a time (eleven rows for nine tools: Gmsh and PrePoMax have two cases each), prints the table and writes `out/check_tools.csv` (tool, case, expected, measured, verdict, seconds; this run's rows only). A missing tool is a failed row, not a crash. A lock on `out/check_tools` makes a second run wait. | `uv run python check_tools.py`; `uv run python check_tools.py --only gmsh,salib` (names: femm, gmsh, calculix, prepomax, ross, elmer, salib, pymoo, matlab); `uv run pytest tests/test_check_tools.py -q` (its tests, no tool is run) | Exit status 0 if every row passed, 1 if one failed or a tool is missing, 2 for a wrong --only, 130 after Ctrl-C (the rows made so far are in the CSV). With every row passing it prints "check_tools: PASS, all 11 rows pass"; a full run takes about 30 s on a quiet PC. |
| `checks/__init__.py` | What every case shares: `Row` (a table line), `Missing` (a tool that is not there becomes the row `missing: <name> (<where>)`), the registry behind `--only`, the run lock, `fresh()` (empties only folders inside `out/check_tools`) and `intact_path()`. A case module offers `run(folder)`, a generator, so rows made before a later part fails are kept. | | |
| `checks/femm_check.py` | FEMM case. Runs [check_femm.py](check_femm.py) as a child of `run_solver` in the case folder (it opens a private FEMM on a free port) and reads its 10 A line (id = 0): the torque from the air-gap element (T_age) and from the weighted stress tensor (T_wst) are two methods on one solution and must agree within 0.1 %. | `uv run python check_tools.py --only femm` | T_age 0.8087 and T_wst 0.8085 N.m, 0.025 % apart |
| `checks/gmsh_check.py` | Gmsh case, two rows. The Python module (4.15.2) meshes the default rotor through `motorgeo.to_gmsh` (MSH 2.2 file for ElmerGrid) and must give more than 1,000 nodes; the app `gmsh.exe -version` must print 4.15.2 (its text is compared, not its exit status). `gmsh.initialize()` cuts the process's PATH short; `intact_path()` puts it back. | `uv run python check_tools.py --only gmsh` | 9,176 nodes (MSH 2.2); the app prints 4.15.2 |
| `checks/ccx_check.py` | CalculiX case. A quarter of a flat steel ring (inner radius 7.5 mm, outer 45 mm) spinning at 10,000 rpm is meshed by the code (96 x 96 eight-node plane-stress elements) and solved by `ccx_static.exe` under a centrifugal load; the mean hoop stress at the bore must be within 0.5 % of Lame's exact formula. | `uv run python check_tools.py --only calculix` | bore hoop stress 14.1060 MPa against Lame's 14.0977 MPa (+0.06 %) |
| `checks/prepomax_check.py` | PrePoMax case, two rows, without opening its window. The version resource of `PrePoMax.exe` must read 3.0.0; the solver that PrePoMax's `settings.bin` names (key `_calculixExe`, read by [nrbf.py](checks/nrbf.py)) is run with `-v` and must print version 2.23. A setting that cannot be read reliably fails the row. | `uv run python check_tools.py --only prepomax` | PrePoMax.exe 3.0.0; settings.bin names ccx_static.exe, which prints "This is Version 2.23" |
| `checks/ross_check.py` | ROSS case. The python of ROSS's own environment ([envs/ross](envs/ross/)) runs `ross_shaft_case.py` through `run_solver`; ROSS's first natural frequency of a 15 mm by 300 mm steel shaft on two very stiff bearings must be within 2 % of the Euler-Bernoulli formula for a simply supported bar (ROSS's Timoshenko beams land a little below it). | `uv run python check_tools.py --only ross` | f1 = 339.17 Hz against the formula's 340.18 Hz (-0.30 %) |
| `checks/ross_shaft_case.py` | ROSS's half of the ROSS row; it runs inside the ROSS environment and imports only the standard library and ROSS. It reads `case.json`, builds the shaft from Timoshenko beam elements with a spring bearing in x and y at each end, takes the natural frequencies at rest with `run_modal(speed=0)` and writes `result.json`. | run by `ross_check.py`; by hand, with ROSS's python: `envs\ross\.venv\Scripts\python.exe -I checks\ross_shaft_case.py <case folder that holds case.json>` | ross_version 3.1.0; first natural frequency about 340 Hz, a little under the formula's 340.2 Hz |
| `checks/elmer_check.py` | Elmer case. A solid round wire (radius 10 mm, 100 A, alone in air) is meshed by Gmsh (0.2 mm at the wire), converted by `ElmerGrid` and solved by `ElmerSolver` (MagnetoDynamics2D); B along a line is compared with Ampere's law, 2.0 mT at r = R and 1.0 mT at r = R/2, and both must be within 2 %. | `uv run python check_tools.py --only elmer` | B at r = R 1.9904 mT (-0.48 %), at r = R/2 1.0019 mT (+0.19 %) |
| `checks/salib_check.py` | SALib case. The Sobol first-order indices of the Ishigami function (exact: 0.3139, 0.4424, 0) are estimated from 8,192 scrambled Sobol points (N = 1024, fixed seed) and must be within 0.05 of the exact values; the function is evaluated in numpy and compared with SALib's own copy at every point. | `uv run python check_tools.py --only salib` | first-order indices 0.3156, 0.4383, 0.0014 for seed 1 |
| `checks/pymoo_check.py` | pymoo case. NSGA-II (population 40, 250 generations, seed 1) on the 30-variable ZDT1 problem; the IGD, the mean distance from 100 points of the true front to the nearest point found, must be below 0.05. With 100 generations, 40 individuals never reached the limit on any of 100 seeds, which is why 250 are run. | `uv run python check_tools.py --only pymoo` | IGD 0.0134 for seed 1, 40 non-dominated points (limit 0.05) |
| `checks/matlab_check.py` | MATLAB case. `matlab -batch` (with `-singleCompThread`) runs a script that loads a copy of `Improved_plant.slx` without simulating it, then builds `Sine -> Gain(3) -> To Workspace` and checks output = 3 x input. It also needs the script's last line reached, the reference files unchanged and, watched read-only, a job that is empty once MATLAB ends. | `uv run python check_tools.py --only matlab` | exit code 0; the job held MATLAB's own processes and was empty within 0.05 s of the last matlab.exe; gain error 0 |
| `checks/nrbf.py` | Reads a .NET BinaryFormatter file (MS-NRBF) without starting any .NET program: record by record to MessageEnd, and the stream must be used up exactly. An unknown record, a length past the end or a dangling reference raises `NrbfError` with the byte offset. `prepomax_check.py` uses it on PrePoMax's `settings.bin`. | | |
| `envs/ross/` | ROSS's own uv environment: `pyproject.toml` pins `ross-rotordynamics==3.1.0`, `uv.lock` locks every package, `.python-version` names Python 3.13.16. ROSS pulls in many packages that the motor environment must not carry, so it lives apart; the ROSS row runs the python of this folder's `.venv` (built by uv, not committed). | `uv sync` in `envs/ross/` | |

#### The test bench (`bench/`)

The bench tries each tool of the pipeline on the motor's own band-free geometry (the air band behind each magnet left out), driven from Python, and holds every number against an expectation whose source is named: an earlier result, a hand estimate or another tool. It has nine cases, B1 FEMM, B2 Gmsh, B3 Elmer, B4 CalculiX, B5 PrePoMax, B6 ROSS, B7 SALib, B8 MATLAB and B9, which tests the machine-wide run rules themselves; `bench/__init__.py` holds the shared part and those rules. Each case leaves `results.json`, `figure.png`, `run.log` and `runs.json` in `out/bench/<case>/`, and `bench/run_bench.py` is the one command that runs them.

| File | What it does, and how | Run | Result |
|---|---|---|---|
| `bench/` + `bench/run_bench.py` | The entry point of the bench, whose cases B1 to B9 are the rows below: each tries a tool on the band-free motor from Python and holds every number against an expectation whose source is named; a gating check decides the exit status, a reported one is shown and counted apart. `--only` takes case names (commas or repeated), `--out` writes under another root inside `out/`, which the run locks, and `--mesh-study` makes B1 solve a finer mesh as well. It writes `out/bench/summary.json` (the cases it ran and their checks counted: gating and reported, failed and skipped, by case) and, in `out/bench/<case>/`, `results.json`, `figure.png`, `run.log`, `runs.json` and the case's own files. It ends with exit status 1 whenever B2 runs: B2's 3 FAILs are the ruled chord error of `to_gmsh`'s mesh (a straight-edged mesh of a curved boundary loses the circular segments), not a fault. Every solver goes through `femm_queue`. `uv run pytest tests/test_bench*.py -q` tests it, with no solver. | `uv run python bench/run_bench.py [--only B1,B3] [--out out/bench/mine] [--mesh-study]` | 2026-11-06: 141 checks, 119 gating (116 pass), 22 reported (18 pass, 3 fail, 1 skipped), 784 s |
| `bench/__init__.py` | Shared part and rules: the geometry is `motorgeo.Params(barrier="none")` (air band left out in Python, `reference/` read-only); every solver goes through `femm_queue` (one heavy run at a time machine-wide, below normal priority, a timeout, at most 8 workers or threads); every number is a check against a sourced expectation, never relaxed after a run. | | |
| `bench/b1_femm.py` | B1, FEMM 5.0: a pool of 8 FEMMs solves the band-free 90-degree sector for psi_PM (no-load flux linkage), the MTPA torque at 10 A peak (mean of six rotor positions at each current angle) and the cogging torque over its 5-degree period; psi_PM and torque are held within 0.5 % of the band-free row of `barrier_study.py` (16.61 mWb, 1.127 N.m). | `uv run python bench/run_bench.py --only B1` | band-free sector: psi_PM 16.629 mWb (+0.114 %), MTPA torque 1.12914 N.m (+0.190 %) |
| `bench/b2_gmsh.py` | B2, Gmsh: two roads to a mesh, each checked for physical groups, triangle quality and areas against motorgeo's. Path 1: `motorgeo.to_gmsh` on the band-free 90-degree sector (the mesh B3 gives to Elmer). Path 2: the CAD drawings in `reference/` through ezdxf, shapely (the 16 air bands of `SynRM rotor.DXF` removed in memory, files untouched) and Gmsh. | `uv run python bench/run_bench.py --only B2` | path 1 mesh areas against motorgeo's: N45 -0.172 %, air +0.319 %, coil -0.237 % (limit 0.1 %: the chord error of straight edges on curved boundaries, the 3 FAILs B2 reports) |
| `bench/b3_elmer.py` | B3, Elmer: B2's path-1 mesh through ElmerGrid and ElmerSolver (MagnetoDynamics2D) at no load, N45 magnets, M-19 on its B-H curve, periodic sector edges. The air-gap flux density B_r and psi_PM are held against FEMM's (B1's model). Two runs: `laminated` (FEMM's 0.98 lamination fill: the verdict) and `plain` (the curve alone: reported only). | `uv run python bench/run_bench.py --only B3` | laminated run: B_r fundamental -0.33 %, psi_PM -0.65 % from FEMM's (limit 3 %) |
| `bench/b4_ccx.py` | B4, CalculiX 2.23: the band-free rotor sector (plane stress, 6-node triangles, mesh from Gmsh) spun at 10,000 and 12,000 rpm; the peak von Mises stress and its place are checked against Lame's disc, equilibrium, the (12/10)^2 stress ratio and a hand estimate. The magnets load the steel as slot-wall pressure (the verdict), bonded, or soft (diagnostic). | `uv run python bench/run_bench.py --only B4` | pressure model: peak 33.45 MPa at 10,000 rpm and 48.17 at 12,000 (ratio 1.4400), in the outer bridge of a magnet slot |
| `bench/b5_prepomax.py` + `bench/b5_prepomax_script.py` | B5, PrePoMax 3.0.0 run headless (`-g No`, `--script`): B4's deck is imported, CalculiX 2.23 runs through PrePoMax's analysis object, and the peak von Mises stress is compared with B4's (B5 alone skips that comparison). `b5_prepomax_script.py` runs inside PrePoMax and adds the `*DLOAD CENTRIF` load and the section thickness that the importer misses. | `uv run python bench/run_bench.py --only B4,B5` | peak 33.4541 MPa, +0.0003 % from B4's |
| `bench/b6_ross.py` + `bench/b6_ross_case.py` | B6, ROSS: the rotor as a disc (90 mm x 60 mm stack) on a 15 mm shaft and two ball bearings: critical speeds (the first held within 10 % of a Jeffcott hand estimate), the Campbell diagram and the margins at 10,000 and 12,000 rpm. `b6_ross_case.py` runs in ROSS's own environment (`envs/ross`), started by `b6_ross.py`; the two exchange `case.json` and `result.json`. | `uv run python bench/run_bench.py --only B6` | first forward critical speed 22,838 rpm, 1.84 % below Jeffcott's estimate; margins 2.28 x 10,000 rpm and 1.90 x 12,000 rpm |
| `bench/b7_salib.py` | B7, SALib and FEMM: Morris screening of four rotor dimensions of the band-free motor (`slot_t`, `slot_w`, `mag_y`, `v_half_deg`, each within +-1.5 % of the design); the 30 designs are solved in FEMM on the coarse mesh at two rotor positions, 10 A at 22.9 degrees, and the output is the mean torque. Two runs must give identical indices. | `uv run python bench/run_bench.py --only B7` | `mu*` in N.m: `slot_w` 0.1261, `mag_y` 0.0414, `slot_t` 0.0186, `v_half_deg` 0.0074; two runs identical to the last bit |
| `bench/b8_matlab.py` + `bench/b8_mtpa_map.m` | B8, MATLAB: FEMM computes a 6 x 6 flux map; Python saves it as `flux_map.mat` and runs one MATLAB (`matlab -batch b8_mtpa_map`) that interpolates it linearly and finds the MTPA angle at 10 A. Python compares it with scipy's on the same map (a control map with a closed-form angle guards the layout) and checks that no project file or MATLAB preference changed. | `uv run python bench/run_bench.py --only B8` | MTPA angle 22.69 degrees in MATLAB and in Python (limit 0.5 degrees); largest torque 1.1223 N.m |
| `bench/b9_rules.py` | B9: two `run_bench.py` runs, each of B3 and B6, started at once, one root each, and watched from outside. The second must wait for the machine's one solver slot and print who holds it; both must end complete with agreeing numbers, nothing left running, every process below normal priority, at most 8 workers. Two runs on one root must take turns. | `uv run python bench/run_bench.py --only B9` | the second run waited and both ended complete; 2,037 numbers compared; on one root the second started 0.1 to 0.2 s after the first's last file |
| `bench/femm_points.py` | The FEMM side that B7 and B8 share, imported by them and not run on its own: `solve_points` runs in a pool worker, builds one coarse-mesh model of a band-free design (a design `motorgeo.check` rejects is refused), writes it under a file name of its own and solves a list of (rotor position, id, iq) points, returning flux linkages and three torques. | | |

### 5. The materials

These scripts compute the numbers and draw the figures about the motor's materials (M-19 steel, N45 magnets, copper, insulation and the structural parts) in four domains: magnetic, electrical current, thermal and structural. Every number is either computed in a script or read from a source named beside it in the code, and none of the scripts starts a solver; values the code marks `[CHECK ...]` are still being cross-checked online and may change. Each script saves its numbers (JSON, CSV) and its PNG figures in `out/materials/`; if the environment variable `MOTOR_FIGURES_DIR` names a folder, each figure is copied there too, and `MOTOR_FIGURES_DIR=docs` copies it into the repository's `docs/figures` folder (`docs_figures` in `config.toml`).

| File | What it does, and how | Run | Result |
|---|---|---|---|
| `materials/common.py` | Shared by the other materials scripts: the physical constants (CODATA 2018), readers for the material blocks of the reference FEMM model (`reference/IPM synRM analysis.FEM`) and of FEMM 5.0's `matlib.dat`, one plot style, and `save()`, which writes each figure to `out/materials/` and copies it elsewhere only if `MOTOR_FIGURES_DIR` names a folder, or says `docs` for the repository's `docs/figures`. | | |
| `materials/crosssection.py` | Draws the motor's cross-section coloured by material (36 slots, 8 poles, 128 mm across): [motorgeo.py](motorgeo.py) builds one 90-degree sector with every region tagged by material, and the script rotates it four times. The shaft and the housing are not in the FEMM model, so they are sketched and labelled as such. Writes `materials-cross-section.png`. | `uv run python materials/crosssection.py` | |
| `materials/current.py` | Follows charge through the materials from one electron in copper upwards: conductivity, drift speed, resistance and loss, resistivity against temperature (the 234.5 rule, Matthiessen's rule), Nordheim's rule for silicon steel, skin depth, eddy currents in the laminations and the magnets, and the insulation. Saves `current.json` and its figures. | `uv run python materials/current.py` | Cutting a magnet into k pieces divides its eddy-current loss by k^2 while each piece stays under a skin depth (a scaling, not an absolute). |
| `materials/fields.py` | Reads the solutions that [barrier_study.py](barrier_study.py) saved in `out/barrier/fields/` (90-degree sectors with and without the air band, at no load and at 10 A at the best angle) through [femfile.py](femfile.py), no FEMM needed. Draws flux lines over the materials and measures B along each magnet's own magnetisation direction, triangle by triangle. | `uv run python materials/fields.py`, after `barrier_study.py` | |
| `materials/magnetic.py` | From a current making a field up to the magnets: iron's magnetisation, FEMM's M-19 B-H curve as J and mu_r(B), hysteresis, Weiss's molecular field, N45's straight line, (BH)max and knee when hot, and where the motor's magnets work. Saves `magnetic.json`, a CSV and five figures. The maker's curve, `materials/research/m19_dc_maker.csv`, is plotted when it is there. | `uv run python materials/magnetic.py`, after `fields.py` and `current.py` | M-19: J levels off near 2.0 T (saturation). N45: FEMM's line has Br 1.359 T, the datasheet's nominal is 1.35 T. |
| `materials/research/m19_dc_maker.csv` | Data: the DC magnetisation curve of the M-19 steel's maker, 16 points (columns `B_T` and `H_A_per_m`, from 0.20 T to 2.10 T). `validation/m19_femm5.py` compares FEMM's two M-19 curves with it, and `materials/magnetic.py` plots it when it is there. | | |
| `materials/structural.py` | Mechanical properties and what speed does to them: stiffness against melting point, density from the crystal, hoop stress in a spinning ring and Lame's disc, thermal expansion, the property table for CalculiX and ROSS, and the nominal stress in the rotor bridges by hand (the real peak needs a finite-element solve). Saves `structural.json` and two figures. | `uv run python materials/structural.py` | CalculiX checked against Lame's disc at 10,000 rpm: bore 14.106 MPa (0.06 %), rim within 0.27 %. The 300 MPa yield limit is a placeholder for M-19 (M-15, the neighbouring grade, has 358). |
| `materials/thermal.py` | Heat in the materials: kT at the motor's temperatures, who carries heat (Wiedemann-Franz against measured conductivity), heat capacity and diffusivity, layers (a laminated stack, a wound slot), copper and iron loss per kilogram, what heat does to each property, and insulation life (Arrhenius). Saves `thermal.json` and three figures. | `uv run python materials/thermal.py` | Insulation life halves about every 10 K (Arrhenius gives 7-11 K); a class is defined to reach 20,000 h at its own temperature. |

### 6. The teaching scripts

Code written to teach: five small examples of the tools the pipeline is built on, scripts that draw explanatory figures, the FEMM runs behind two studies (torque in d-q, maximum torque per ampere) and demos of the proximity effect. Each Run cell says where to run from: the small examples and the first two figure scripts from `learn/`, everything else from `python/`. The `.m` files are MATLAB versions of some of the maths in Python, written but not yet run in MATLAB.

#### The five small examples

Five short scripts that each teach one tool the pipeline uses. They are run from inside `learn/`, where `02_ezdxf_basics.py` writes `tiny.dxf`, `03_pyfemm_magnet.py` writes `magnet.fem` and `magnet.ans`, and `04_workers.py` makes `out/`; only 03 and 04 need FEMM.

| File | What it does, and how | Run | Result |
|---|---|---|---|
| `learn/01_shapely_basics.py` | shapely in 20 lines, a calculator for flat shapes: areas, a hole cut out, the distance between two shapes (the "steel bridge" between a square and a magnet), union, point-in-shape, rotation, and `polygonize`, which turns loose lines into closed faces the way a DXF or .fem file becomes regions again. | `uv run python 01_shapely_basics.py`, from `learn/` | Square area 16.0, 12.0 with a hole cut out; a box with a wall down the middle gives 2 faces of 8.0. |
| `learn/02_ezdxf_basics.py` | ezdxf in 20 lines: writes a DXF a CAD program can open (a line, an arc and a closed polyline on a layer of its own, in millimetres) as `tiny.dxf` in the current folder, then reads it back and prints each entity, flattening the arc to points within 0.01 mm of the curve. | `uv run python 02_ezdxf_basics.py`, from `learn/` | |
| `learn/03_pyfemm_magnet.py` | pyfemm in 30 lines: one 10 x 2 mm N45 magnet in a box of air with an A = 0 boundary, drawn and solved by a FEMM of its own (started through [femm_session.py](femm_session.py)); B is read above the magnet and inside it. Needs Windows and FEMM 5.0. | `uv run python 03_pyfemm_magnet.py`, from `learn/` | By = 0.1378 T above the magnet and 0.1582 T inside it; mesh: 4872 nodes. |
| `learn/04_workers.py` | Why FEMM workers must be separate processes, each with its own FEMM and its own files: 4 process workers give 4 separate `femm_headlessw.exe`; 2 thread workers fail (a process can hold only one FEMM); 2 process workers sharing one file name make one read the other's answer; with private file names each reads its own. | `uv run python 04_workers.py`, from `learn/` (FEMM 5.0, about 17 s) | 4 `femm_headlessw.exe` while 4 workers are busy; a shared file name makes the magnet job read B = 0.0000 T, private names give 0.1662 T. |
| `learn/05_pymoo_toy.py` | NSGA-II (pymoo) on a toy problem with two goals that disagree, no FEMM: cook 1 likes recipes near x = +1, cook 2 near x = -1, both dislike large y, and recipes with x > 0.5 are not allowed. No recipe pleases both, so the answer is a front of best compromises along y = 0, not one point. | `uv run python 05_pymoo_toy.py`, from `learn/` | |

#### The figure scripts

Figure scripts for the project's explanations. `geometry_figure.py` and `toy_front_figure.py` take the output PNG path as their one argument and are run from `learn/`; `tools_figures.py` and `field_figure.py` are run from `python/` and write into `out/`.

| File | What it does, and how | Run | Result |
|---|---|---|---|
| `learn/geometry_figure.py` | Draws four panels of pole 0 from the same recipe ([motorgeo.py](motorgeo.py)): the reference `Params()` and three sets of changed numbers, with the label points FEMM gets (dots), the magnet directions (arrows) and the `check()` verdict; a set that `build()` refuses is drawn as a refusal. | `uv run python geometry_figure.py <output.png>`, from `learn/` (the output folder must exist) | |
| `learn/toy_front_figure.py` | Draws what NSGA-II returns on the two-cooks toy problem of `05_pymoo_toy.py`: the recipes (generation 1, random, against generation 150, the front) and their scores, where no blue point is beaten on both goals. No FEMM needed. | `uv run python toy_front_figure.py <output.png>`, from `learn/` (the output folder must exist) | |
| `learn/tools_figures.py` | The band-free motor as each tool sees it: the cross-section drawn by `motorgeo`, the Gmsh mesh of the 90-degree sector (`motorgeo.to_gmsh`, rendered in Gmsh's window through `shot.geo`), and the FEMM field read from the saved sweep in `out/flux_explorer/` (made by `flux_explorer_sweep.py`). No solver runs. Writes `out/tools_fig/`. | `uv run python learn/tools_figures.py [--gmsh]`, from `python/` (`--gmsh` also opens Gmsh to render the mesh) | |
| `learn/field_figure.py` | The band-free motor at work, drawn in the look of the Rotor Flux Explorer (the interactive flux page, published separately): a fresh FEMM solve of the 90-degree sector at 10 A peak and the best angle found by `learn/mtpa`, drawn as B per triangle with flux lines (contours of A), tinted slot layers and magnet arrows, with checks against FEMM's own answers. | `uv run python learn/field_figure.py [--render-only] [--theta-e DEG] [--lines N]`, from `python/` (about 6 s; `--render-only` redraws from the saved solution, no FEMM) | Mean torque of the six rotor positions 1.1275 N.m, matching learn/mtpa's 1.1275 (-0.004 %); flux density up to 2.83 T, in the rotor's outer bridges. |

#### Torque in d-q (`learn/dq_torque/`)

The FEMM runs behind a study of torque in the d-q frame on the band-free rotor, `Params(barrier="steel")` (the hand-drawn rotor with its air band filled with steel). Every case is solved twice, with the magnets as modelled and with N45's coercivity set to 0, so what changes between the two is the magnets' flux alone. Run `run.py`, then `report.py` and `figures.py`, all from `python/`; they work in `out/learn/dq_torque/`. The two `.m` files are MATLAB versions of small formulas, written but not yet run in MATLAB.

| File | What it does, and how | Run | Result |
|---|---|---|---|
| `learn/dq_torque/common.py` | Shared settings and helpers: the band-free rotor with magnets on (N45 as modelled, H_c = 1,030,272 A/m) and off (the same file with H_c = 0), the current angle measured from +q toward -d, the 6 rotor positions whose average cancels the 6th, 12th and 18th torque harmonics, and the split of the d-q torque into three field-times-current terms. | | |
| `learn/dq_torque/run.py` | The FEMM runs, on one FEMM under the solver slot of [femm_queue.py](femm_queue.py), fine mesh, magnets on and off: at 10 A the current angle from 0 to 90 deg in 7.5 deg steps and the no-load flux, each at 6 rotor positions; L_d and L_q at 5, 20, 30 and 40 A; field snapshots with B read at pole 0's bridges and centre rib. | `uv run python learn/dq_torque/run.py`, from `python/` (about 3.5 minutes, 330 solves) | |
| `learn/dq_torque/report.py` | No FEMM: reads the CSV results of `run.py`, prints seven small tables (magnets on against off, the three torque terms at the best angle, two torque routes inside FEMM, L_d and L_q against current, an axis check, B in the bridges, a route to the magnet torque by hand) and writes `summary.json`. | `uv run python learn/dq_torque/report.py`, from `python/` | |
| `learn/dq_torque/figures.py` | No FEMM: draws three figures from the results of `run.py` and the `summary.json` of `report.py`: `fig_torque.png` (torque against current angle at 10 A, magnets on and off, and the torque split into its three terms), `fig_bridges.png` (B in one rotor pole) and `fig_saliency.png` (L_q / L_d against current). | `uv run python learn/dq_torque/figures.py`, from `python/` (a few seconds) | |
| `learn/dq_torque/park.m` | MATLAB function: phase quantities (currents in A or flux linkages in Wb) to the rotor's d-q frame, amplitude-invariant, the same transform as `FemmModel.solve_abc` in [motorgeo.py](motorgeo.py): a phase peak of 10 A gives sqrt(d^2 + q^2) = 10 A. Written, not yet run in MATLAB. | MATLAB: `[d, q] = park(xa, xb, xc, theta_e_deg)` | |
| `learn/dq_torque/three_terms.m` | MATLAB function: splits the d-q torque 1.5 p (psi_d i_q - psi_q i_d) into three field-times-current products (magnets x i_q, the iron's q field x i_d, i_d's own d field x i_q) and their total, as `three_terms` in `common.py` does in Python. Written, not yet run in MATLAB. | MATLAB: `T = three_terms(p, psi_pm, psi_d, psi_q, i_d, i_q)` | Its example (the band-free rotor at its best angle, 10 A, FEMM 5.0, fine mesh): psi_pm = 16.607e-3 Wb, Ld = 1.1785e-3 H, Lq = 2.1502e-3 H. |

#### Maximum torque per ampere (`learn/mtpa/`)

The FEMM runs behind a study of the best current angle on the same rotor from 5 to 40 A: does the angle keep sliding toward 45 deg as the current grows, as the constant-parameter formula says, or does saturation bend it back? Run `run.py`, then `report.py` and `figures.py`, all from `python/`; they reuse `learn/dq_torque/common.py` and work in `out/learn/mtpa/`. `mtpa_angle.m` is the formula in MATLAB, written but not yet run in MATLAB.

| File | What it does, and how | Run | Result |
|---|---|---|---|
| `learn/mtpa/run.py` | The FEMM runs, magnets on, fine mesh, one FEMM under the solver slot: the no-load flux at 6 rotor positions, then at 5, 10, ... 40 A peak the current angle from 0 to 60 deg in 5 deg steps plus 90 deg (all on -d, for L_d), each at the 6 positions. Writes `solves.csv` and `mtpa.fem`. | `uv run python learn/mtpa/run.py`, from `python/` (678 solves, about 7 minutes) | |
| `learn/mtpa/report.py` | No FEMM: from `solves.csv` it gives, for each current, FEMM's best angle (the top of a parabola through the best sampled angle and its neighbours), the torque there, L_d and L_q, and the formula's angle with the 10 A constants and with each current's own; what the 10 A angle costs in torque; and a torque to (i_d, i_q) lookup table. Writes `summary.json`. | `uv run python learn/mtpa/report.py`, from `python/` | At 10 A the best angle is 22.9 degrees from +q toward -d, with a mean torque of 1.1275 N.m (as quoted in `learn/field_figure.py`). |
| `learn/mtpa/figures.py` | No FEMM: draws two figures from `solves.csv` and `summary.json`: `fig_angle.png`, the best current angle against current (FEMM, and the formula with the 10 A constants and with each current's own L_d and L_q), and `fig_trajectory.png`, the (i_d, i_q) plane with circles of equal current, lines of equal torque and the MTPA path. | `uv run python learn/mtpa/figures.py`, from `python/` (seconds) | |
| `learn/mtpa/mtpa_angle.m` | MATLAB function: the best current angle of the constant-parameter d-q model, from +q toward -d, from dT/dgamma = 0 solved as a quadratic in sin(gamma); the same formula as `learn/mtpa/report.py` in Python. Written, not yet run in MATLAB. | MATLAB: `gamma_deg = mtpa_angle(psi_pm, Ld, Lq, I)` | Its example (psi_pm = 16.607e-3, Ld = 1.1785e-3, Lq = 2.1502e-3) gives 14.8, 23.5, 31.7, 37.5 deg at 5, 10, 20, 40 A. |

#### The proximity effect (`learn/proximity/`)

Demos that follow the proximity effect in copper from one round wire up to a slot of the optimized stator: the four numbered scripts solve FEMM's time-harmonic problem (through `prox_common.py`), compare it with theory and write a figure into `out/learn/proximity/`. The `.m` files are the same maths in MATLAB (skin depth, a wire's R_ac / R_dc, the proximity loss) with a demo that prints the tables of the Python code; all are written, not yet run in MATLAB.

| File | What it does, and how | Run | Result |
|---|---|---|---|
| `learn/proximity/prox_common.py` | Shared by the demos: small FEMM time-harmonic models of round copper wires in air (each wire in a circuit of a given current, 0 A for the proximity effect alone, optionally in a uniform field brought in as A = -B x on the outer boundary), `solve()` through the solver slot, the current density in every triangle of the wires, and the plot helpers. | | |
| `learn/proximity/01_one_wire.py` | The current density inside one 0.63 mm copper wire at 100 degC as the frequency rises (d / delta = 0.3, 1, 2, 4): the skin effect (the wire alone, 1 A) and the proximity effect (no net current, in a uniform 1 T field), in FEMM's time-harmonic solver against the exact solution in `optimization/ac_theory.py`. Writes `one_wire.png`. | `uv run python learn/proximity/01_one_wire.py`, from `python/` (about 5 s of FEMM, 8 solves) | R_ac / R_dc 1.264971 at d / delta = 4 (exact 1.264643; FEMM within 4e-4 of the exact R_ac / R_dc at all four d / delta); proximity loss over the low-frequency formula 0.37945 (exact 0.36931). |
| `learn/proximity/02_two_wires.py` | Two neighbouring 0.63 mm wires at 57.9 kHz (d / delta = 2): the field of a current in one wire at the other, the passive wire's eddy loss against the formula for spacings s = 1.1 d ... 8 d, and R_ac / R_dc of the pair with currents in the same and in opposite directions (pictures at s = 1.3 d). Writes `two_wires.png`. | `uv run python learn/proximity/02_two_wires.py`, from `python/` (about 4 s with the solver slot free, 24 solves) | The passive wire's loss falls as 1 / s^2 (slope 1.98 between 2 d and 8 d); R_ac / R_dc of the pair, same direction, 1.0673 ... 1.0213 for s / d = 1.1 ... 8, against the lone wire's 1.0205. |
| `learn/proximity/03_slot_strands.py` | A slot of the optimized stator (the winding study's example: 26 turns a coil side of 8 strands of 0.315 mm, 4 paths, 416 strands) in FEMM's time-harmonic solver at 200 Hz, 5 kHz and 20 kHz plus a static solve: each strand's loss over its DC loss, the current density at the top and in the depth of the slot, and loss against depth. Writes `slot_strands.png`. | `uv run python learn/proximity/03_slot_strands.py`, from `python/` (about 7 s, four solves) | R_ac / R_dc 1.00038 at 200 Hz and 4.3967 at 20 kHz; 63 % of the extra loss is made in the first 3 mm below the top of the coil. |
| `learn/proximity/04_rac_vs_frequency.py` | R_ac / R_dc of the same slot against frequency (twelve frequencies from 100 Hz to 200 kHz, with laminated and with lossless steel) and the law that predicts it from one static solve, (R_ac - R_dc) / R_dc = K (d k / delta^2)^2, K a constant of the slot. Draws FEMM's two curves, the law and the lone strand's skin effect. Writes `rac_vs_frequency.png`. | `uv run python learn/proximity/04_rac_vs_frequency.py`, from `python/` (about 18 s, 25 solves) | K = 15.889 mm^2; R_ac / R_dc with laminated steel 1.0004 at 200 Hz, 4.397 at 20 kHz and 28.1 at 60 kHz. |
| `learn/proximity/demo_proximity.m` | MATLAB script: for a 0.63 mm copper wire at 100 degC it sweeps the frequency so that d / delta runs from 0.1 to 5, plots R_ac / R_dc of the wire alone and the proximity loss in a 10 mT (peak) field (exact against the low-frequency formula), and prints the table of the Python code so the two can be compared. Written, not yet run in MATLAB. | MATLAB: `demo_proximity`, with this folder on the path | Expected values from the Python run at d / delta = 1: R_ac / R_dc 1.0013007, proximity ratio 0.9928916. |
| `learn/proximity/copper_resistivity.m` | MATLAB function: annealed copper's resistivity at t_c degC, rho_20 (1 + alpha_20 (t_c - 20)) with rho_20 = 1.7241e-8 Ohm m (IEC 60028) and alpha_20 = 0.00393 per K, the line also used in `optimization/winding.py` and `ac_theory.py`. Written, not yet run in MATLAB. | MATLAB: `rho = copper_resistivity(t_c)` | 2.2662e-8 Ohm m at 100 degC. |
| `learn/proximity/skin_depth.m` | MATLAB function: the skin depth of a non-magnetic conductor, sqrt(rho / (pi f mu0)), from the diffusion equation of the field; the same formula as `skin_depth` in `optimization/ac_theory.py`. Written, not yet run in MATLAB. | MATLAB: `delta = skin_depth(f_hz, rho)` | Copper at 100 degC: 5.36 mm at 200 Hz and 0.536 mm at 20 kHz. |
| `learn/proximity/rac_rdc_round_wire.m` | MATLAB function: R_ac / R_dc of one round wire alone in space (the skin effect), exact, Re[(z / 2) I0(z) / I1(z)] with z = (1 + 1j) d / (2 delta), using scaled Bessel functions so that large z does not overflow. Written, not yet run in MATLAB. | MATLAB: `r = rac_rdc_round_wire(d, f_hz, rho)` | 1.0013 at d / delta = 1, 1.0205 at 2 and 1.0973 at 3 (copper at 100 degC). |
| `learn/proximity/proximity_lowfreq.m` | MATLAB function: the low-frequency proximity loss of a round wire with no net current in a transverse field, per unit length, pi sigma w^2 B^2 d^4 / 128 for a sinusoid of peak B, valid while the wire is thin against the skin depth (the formula of `optimization/winding.py`). Written, not yet run in MATLAB. | MATLAB: `p = proximity_lowfreq(d, f_hz, b_peak, rho)` | |
| `learn/proximity/proximity_ratio_exact.m` | MATLAB function: the exact proximity loss of a round wire in a uniform transverse field over the low-frequency formula of `proximity_lowfreq.m`, from the field inside the wire (Bessel functions and Lommel's integral). Written, not yet run in MATLAB. | MATLAB: `r = proximity_ratio_exact(d, f_hz, rho)` | 0.9929 at d / delta = 1, 0.8976 at 2 and 0.6384 at 3 (copper at 100 degC). |

### 7. The optimization study

The study looks, on the band-free motor (the rotor without the air band behind each magnet, `motorgeo.Params(barrier="none")`, and the stator around it), for the geometries where the torque cannot rise any more without the ripple rising too: the Pareto front of mean torque against torque ripple at the scoring point, inside a fixed envelope (radii, air gap, shaft, stack and the bought magnets' size). Every file is driven from one black box, `optimization/design.py`, and the table follows the order of the study (check, sweeps, screening, optimizer runs, cross-check, fine-mesh re-score, DXF export, side-by-side figure). Each file is run from `python/` as a module; FEMM is started only through `femm_queue.femm_pool` (one heavy run at a time), and results go to `out/optimization/<step>/` (git-ignored).

| File | What it does, and how | Run | Result |
|---|---|---|---|
| `optimization/__init__.py` | The package docstring: the study's overview, the order of its files and where each one writes. Rules kept throughout: one heavy run at a time (every FEMM through `femm_queue.femm_pool`), the band left out in Python, and the outer-bridge guard fixed at 1.4 mm (relaxing it is a manufacturing call, not the study's). | | |
| `optimization/design.py` | The black box: a candidate (a dict of `motorgeo.Params` overrides; `{}` is the reference) goes in, and mean torque, ripple and feasibility come out. It is screened against the limits in Python, then scored in FEMM at its own MTPA angle over one ripple period (23 solves, about 8 s on one worker); `scoring` `AT`, `J` or `P` holds the reference's ampere-turns, current density or copper loss. | | |
| `optimization/check_design.py` | Holds the black box against numbers it must reproduce before anything is trusted: in Python the reference's 1.558 mm bridge, the Fourier peak-to-peak of a sampled sine and `screen()` against `motorgeo`'s refusals; in FEMM the reference's MTPA angle (within 1 degree of 22.9) and mean torque (within 1 % of 1.12914 N.m, fine mesh), as in the bench (`bench/b1_femm.py`). | `uv run python -m optimization.check_design` (about a minute on the solver slot) | Every check is printed with PASS or FAIL; exit status 0 if all pass. |
| `optimization/sweeps_rotor.py` + `optimization/sweeps_rotor_figures.py` | Sweeps the rotor tier's variables (`mag_x` or its mapped form `bridge_mm`, `mag_y`, `v_half_deg`) one at a time across everything the black box allows, so that the optimizer is chosen after looking at the landscape: feasible intervals and what ends each, the shape of torque and ripple, the noise floor, a 2-D map. The figures file draws ten PNGs from the CSVs (no FEMM). | `uv run python -m optimization.sweeps_rotor <stage>`, stages in order `scan`, `sweeps --with-noise`, `batch`, `valley`, `strip`, `fine-map`, `analyse` (about 10 minutes of one core for `scan`, about 8 minutes of pool time for the rest); then `uv run python -m optimization.sweeps_rotor_figures` | Torque rises as the outer bridge thins to its guard (1.1217 N.m at the reference, 1.1726 N.m at a bridge of 1.4 mm). The ripple has valleys along `mag_y` and `v_half_deg`, in parallel diagonal bands on the 2-D map (lowest ripple 6.01 %). |
| `optimization/sweeps_stator.py` + `optimization/sweeps_stator_figures.py` | Moves each of the five stator variables (`slot_half_deg`, `slot_open`, `h_open`, `r_shoe`, `r_wall`) alone across its whole feasible interval, under scoring `J` and `AT`, with noise, fine-mesh and 2-D map stages; it also finds a hidden constraint (the coil layers' split must lie on the straight slot walls). The figures file reads the CSVs, prints tables and draws six PNGs (no FEMM). | `uv run python -m optimization.sweeps_stator <stage>`, stages `screen` (2 minutes, no FEMM), `j`, `at`, `noise`, `fine`, `map slot_open slot_half_deg` (about 7.5 minutes of pool time in all); then `uv run python -m optimization.sweeps_stator_figures <part>`, parts `tables`, `shapes`, `noise`, `ladder`, `fine`, `map`, `derived`, `cost`, `figures` | Under `J` the torque follows the coil area exactly (Spearman 1.00), so slot area is paid for in current; under `AT` it hardly changes while the copper loss swings widely. On the `slot_open` against `slot_half_deg` map the lowest ripple is 4.23 % and the two variables interact little (3.3 % of the ripple's variance). |
| `optimization/screening.py` | Morris's method (SALib) on the study's real box, for the mean torque and the ripple: `mu*`, `mu`, `sigma` and `sigma / mu*` show which variables matter and how nonlinearly or jointly they act, before an optimizer spends its budget. Each sample point is screened in Python first (a refused one stops the run before FEMM); k = 8 and r = 12 make 108 designs, about 2 minutes on 8 workers. | `uv run python -m optimization.screening --box joint --r 12` (`--box` reads `out/optimization/boxes.json`, which is not part of this folder) | As reported in `crosscheck.py`: `sigma / mu*` of the ripple is 0.76 to 1.10 on all six variables of the joint problem, so they act together and nonlinearly. |
| `optimization/run_moo.py` | NSGA-II (pymoo) on the black box, every evaluation logged: a Latin-hypercube start plus given seed designs, the screen's constraints, and a torque floor of 0.8 N.m so that the ripple in per cent cannot reward dead rotors. The front is read from the whole log, not from the last population, and written with its knee; a progress line per generation reports the hypervolume. | `uv run python -m optimization.run_moo --run rotor_nsga2 --box rotor --scoring AT --pop 40 --gens 30 --seed 1` (`--bounds FILE.json` replaces `--box`, which reads `out/optimization/boxes.json`, not part of this folder; also `--seeds`, `--fix`) | |
| `optimization/run_grid.py` | A full-factorial grid over a box (`--levels` points per variable), every point scored and the front read from all of them, as in `run_moo.py`. Used for the stator tier, where the sweeps found three variables that matter and little interaction between `slot_open` and `slot_half_deg`, so a few hundred designs at about 0.8 s each measure what an evolutionary search would only approximate. | `uv run python -m optimization.run_grid --run stator_grid --box stator --levels "slot_open=11,slot_half_deg=9,r_wall=6" --scoring P --fix "{\"h_open\": 0.5}" --fix-from out\optimization\rotor_nsga2\knee.json` (`--box` reads `out/optimization/boxes.json`, not part of this folder) | |
| `optimization/crosscheck.py` + `optimization/crosscheck_figure.py` | A second, independently chosen search of the joint problem (6 variables, 2,000 designs at most): a feasible cube whose faces are the limits, Gaussian processes that predict the torque waveform (not the ripple), the expected hypervolume improvement to pick each round, and a stop only after the run stalls and a probe of designs the model did not choose gains under 0.1 %. The figure file draws the front, knee and convergence. | `uv run python -u -m optimization.crosscheck run` (resumable; also `probe` and `report`), then `uv run python -m optimization.crosscheck_figure`; the reported run took about 43 minutes of pool time. It reads `out/optimization/boxes.json`, which is not part of this folder | The front's knee (design.knee on the front's own range) is 1.802 N.m at 4.41 % ripple (coarse mesh); on the same mesh the reference scores 1.1217 N.m and 19.62 % (see `sweeps_rotor.py`). Most front designs sit on the bridge guard, the narrowest opening and the tooth limit; some also on the rib limit. |
| `optimization/finalize.py` | The study's last step: keeps the non-dominated designs of the union of the named runs' fronts and of the independent cross-check, re-scores up to `--max` of them on the fine mesh (plus the reference and each run's own knee), takes the fine front's knee (both objectives scaled 0 to 1, nearest the ideal corner) as the chosen design and writes it as a DXF with `export.py`. | `uv run python -m optimization.finalize --runs joint_nsga2 rotor_nsga2 stator_grid --crosscheck crosscheck --max 24` (each named run's `front.csv` must exist under `out/optimization/`) | The reason for re-scoring: over 51 designs of the sweeps the fine mesh moves the torque by +0.5 % and the ripple by -0.7 to -0.9 points, and ranks the designs the same way (Spearman 1.00). |
| `optimization/export.py` | Writes a candidate as a DXF of the whole motor, clean enough for CAD: layers `ROTOR`, `MAGNETS`, `MAGNET_DIR`, `STATOR`, `COILS` and `LABELS` drawn from `motorgeo`'s regions, with only the motor's real edges. The file is then read back with ezdxf and its areas and counts checked against the model (16 slots, 16 magnets, 72 coil faces), and a preview PNG is drawn from it. | `uv run python -m optimization.export --overrides "{}" --out out\optimization\export\reference.dxf` (no FEMM) | On the reference every area is within 0.05 % of the model's, the counts match, and a preview is written next to the file. |
| `optimization/compare_designs.py` | One figure of the starting design and the optimized design side by side: the geometry of one 90-degree sector with the changed dimensions marked (centre rib, outer bridge, V angle, slot opening, narrowest tooth, yoke), and the magnetic field at each design's comparison point (\|B\| as a colour on one scale, flux lines in equal steps of flux). Both designs are solved on the fine mesh through the solver slot, and every printed number is held against the study's own record (`final.json`). Also writes a geometry-only picture, a wide single-row picture and a JSON of every number with its checks. | `uv run python -m optimization.compare_designs` (about 23 s of wall time; needs `out/optimization/final/final.json`); `--reuse` draws again from the saved fields, with no FEMM | Mean torque 1.1288 and 1.8073 N.m, ripple 18.45 and 4.84 %, for the starting and the optimized design (equal to the study's); 53 checks, all PASS |

### 8. The rotor stress check

The optimizer thinned the two strips that hold each pole's outer steel and its magnets against the centrifugal pull (the centre rib to 1.0 mm against 3.3 mm on the reference, the outer bridges to 1.4 mm against 1.56 mm), and the bridge guard and the rib floor are manufacturing limits, not strength limits. `optimization/stress_ccx.py` therefore puts the optimized rotor through the bench's centrifugal-load case in CalculiX and reports stress only (the electromagnetic cost of a wider rib or bridge is not in it). The strength limits it uses are placeholders: the maker's sheet skips the mechanics of the lamination steel M-19, so they come from a neighbouring grade and similar grades.

| File | What it does, and how | Run | Result |
|---|---|---|---|
| `optimization/stress_ccx.py` | CalculiX stress of the optimized rotor under centrifugal load, through the bench's validated case ([`bench/b4_ccx.py`](bench/b4_ccx.py)), gated on the reference rotor first: the peak and where it sits, the speeds at which it reaches placeholder strength limits (stress scales with the speed squared, so one solve gives every speed) and its sensitivity to rib, bridge and corner radius. | `uv run python -m optimization.stress_ccx` (the whole case, 5 to 7 minutes), `--gate-only` (the gate alone, about 10 s), `--redo` (report and pictures again from the last run's saved state, no solve); reported with CalculiX 2.23 and Gmsh 4.15.2 | The peak is 39.061 MPa at 10,000 rpm, in the centre rib. It reaches the 300 MPa yield at 27,713 rpm; the maximum operating speed, with a 1.2 x overspeed, is 18,857 rpm at yield / 1.5 and 16,330 rpm at yield / 2. |

### 9. Copper losses with the proximity effect, and the winding studies

#### The copper losses (skin and proximity effect)

The first winding study (`optimization/winding.py`) priced the winding's AC loss with one low-frequency proximity formula and found it negligible at 3,000 rpm; these files test that formula strand by strand against FEMM and follow R_ac / R_dc (the AC resistance over the DC one) from the fundamental up to the PWM switching frequency, and the loss over the whole speed range. `ac_theory.py` holds the exact results for round wires and `ac_calibration.py` tests FEMM's time-harmonic solver against them; `ac_slot.py` draws one slot strand by strand (studies in `ac_slot_study.py`), `ac_machine.py` takes the machine's own field at the copper from magnetostatic solves of the sector, `ac_pwm.py` derives the inverter's ripple current, and `copper_loss.py` adds these up as one fast function that `copper_loss_study.py` checks against the slot solves. Everything is in `optimization/` and runs from `python/`; the studies on the motor read the optimized design from `out/optimization/final/final.json` (written by `finalize.py`) and write to `out/optimization/copper_ac/`.

| File | What it does, and how | Run | Result |
|---|---|---|---|
| `optimization/ac_theory.py` | Exact AC results for round copper wires, no FEMM: the skin effect (modified Bessel functions, checked with Kelvin functions), the proximity loss of a lone wire in a uniform transverse field (closed form) and the circulating current of two parallel wires. The yardstick for the FEMM work and the source of the fast model's high-frequency factors. | `uv run python -m optimization.ac_theory` (self-checks, about a second, exit status 0 if all pass) | Exact proximity loss over the low-frequency formula: 0.993 at d / delta = 1, 0.898 at 2, 0.638 at 3. |
| `optimization/ac_slot.py` | FEMM side of the slot model: one slot of the optimized stator with every round strand drawn (random packing, laminated steel as one complex-permeability material), solved time-harmonically for R_ac / R_dc, each strand's proximity loss and the circulating currents of parallel strands; static solves test the first winding study's formula. | | R_ac / R_dc of in-phase layers for the 26 turns x 8 strands x 0.315 mm winding, one random layout: 1.00038 at 200 Hz, 1.230 at 5 kHz, 4.397 at 20 kHz. |
| `optimization/ac_slot_figures.py` | Figures of the slot studies, no FEMM: R_ac / R_dc against frequency, the collapse onto one scaling law, the first winding study's formula against FEMM strand by strand, current-density and loss maps of the strands, and the loss added by connecting strands in parallel. Called by `ac_slot_study.py` after its stages. | | |
| `optimization/ac_slot_study.py` | Resumable stages (`sweep`, `maps`, `circ`, `sens`, `rotor`, `val`) on one FEMM pool: R_ac / R_dc of two windings from 50 Hz to 200 kHz, strand maps, circulating currents for four placements of parallel strands, sensitivity to the modelling choices, the rotor's field, and the law (R_ac - R_dc) / R_dc = K (d k / delta^2)^2 tested on other strands. | `uv run python -m optimization.ac_slot_study --stage sweep` (about 1 minute of FEMM); `uv run python -m optimization.ac_slot_study` (every stage) | W1 (26 turns x 8 x 0.315 mm), same-phase layers, mean of three random layouts: R_ac / R_dc 1.0109 at 1,090 Hz and 4.27 at 20 kHz; W2 (13 x 4 x 0.630 mm): 14.8 at 20 kHz. |
| `optimization/ac_calibration.py` | Tests FEMM's time-harmonic solver on cases with exact answers (`ac_theory.py`) before it is used on the slot, at the slot model's own discretisation and at a finer one: a lone wire's skin effect, a lone wire's proximity loss in a uniform field, and two wires in one parallel circuit. The pass criteria are set before the run. | `uv run python -m optimization.ac_calibration` (a few seconds of FEMM); with `--redraw` only the figure is redrawn, no FEMM | Skin effect within 8.4e-4 of the exact result at the slot's settings for d / delta 0.1 ... 3. The proximity criteria fail above d / delta 1.5 (2.9e-2 at 3, from the mesh of the air round the wire), so the exit status is 1. |
| `optimization/ac_pwm.py` | Ripple current of a two-level three-phase inverter with space-vector PWM, no FEMM: from the volt-seconds of one switching period to the rms, peak-to-peak and harmonics of the phase current, in closed forms for the piecewise-linear ripple. Checked against Parseval, the one-leg textbook case, a time-domain simulation and zero modulation. | `uv run python -m optimization.ac_pwm` (about 5 s; also writes the ripple table and `fig_pwm_ripple.png`) | The rms ripple h(m) rises to 0.02515 at m = 1 (units V_dc / (L f_sw)); the example winding at 48 V and 20 kHz has 0.103 A rms (0.68 A peak-to-peak at most) at m = 1. |
| `optimization/ac_machine.py` | The machine's own field at the copper: FEMM magnetostatic solves of the 90 degree sector (48 rotor positions of one electrical period; no load, MTPA at 0.5 to 3 x rated, field weakening) reduced to the harmonic spectra `G_k` (rate of change of the field) and `H_k` (spread of the vector potential) over the coil area, with flux linkages and torque. | `uv run python -m optimization.ac_machine` (all stages, about 1 minute of FEMM); `uv run python -m optimization.ac_machine --stage analyse` (saved results only, no FEMM) | G reproduces the first winding study's point to a relative difference of 2e-15; at the rated MTPA point the layer next to the opening has G 12.3 against 1.39 for the bottom layer (1e-4 T^2/rad^2). |
| `optimization/ac_machine_report.py` | The analysis half of `ac_machine.py`, no FEMM: checks G against the first winding study's point, tabulates every operating point, fits `G_k`, `H_k`, the flux linkages and the torque with leave-one-out errors, and writes `tables.json` (for `copper_loss.py`) and the field figure. Called by `ac_machine.py --stage analyse`. | | |
| `optimization/copper_loss.py` | One fast function pricing any winding of the optimized stator at any operating point, copper temperature and stack length, in watts: DC loss (slots, end turns), skin effect, the machine's proximity loss, PWM ripple loss and circulating currents of parallel strands; `losses_arrays` takes numpy arrays. Proximity loss at high speed is an upper bound. | `uv run python -m optimization.copper_loss` (prints the interface, a check against the first winding study and the speed per call); `uv run python -m optimization.copper_loss --build` (makes the tables); `uv run pytest tests/test_copper_loss.py -q` (no FEMM) | Example winding (26 turns x 8 x 0.315 mm, 4 paths) at 118.6 ampere-turns, 3,000 rpm, 20 kHz, 48 V, 100 degC, 20 mm stack: total 48.54 W, of which proximity 0.0070 W; 189 microseconds a call. |
| `optimization/copper_loss_build.py` + `optimization/copper_loss_tables.json` | Reads the studies' outputs (machine field, slot AC resistance, PWM ripple) once and writes the JSON next to `copper_loss.py`: geometry, field fits, ripple tables, the slot constant K and the iron's screening `c_iron(f)`, circulating-current constants, each table with its source. The optimizer then needs neither FEMM nor the studies' folders. | `uv run python -m optimization.copper_loss --build` (no FEMM, 0.1 s; needs the studies' outputs) | Slot constant K 15.95 mm^2 for layers in phase (mean of 12 layouts, spread 3.4 %) and 13.01 mm^2 for layers 60 degrees apart. |
| `optimization/copper_loss_figures.py` | Four figures of the copper-loss answer, drawn from the fast model, no FEMM: the loss parts over the DC loss against speed for the two example windings, the proximity map over strand size and speed, the PWM ripple and its loss for six windings, and the circulating-current loss for four strand placements. | `uv run python -m optimization.copper_loss_figures` (about 2 s; also called by `copper_loss_study.py`) | |
| `optimization/copper_loss_study.py` | The answers of the copper-loss work from the fast model: the model against every FEMM slot solve (those that built it and others), each loss part from 3,000 rpm to the 16,330 rpm stress limit, the proximity map, the PWM ripple of six windings, circulating currents by strand placement, and the speed where the 48 V bus runs out. | `uv run python -m optimization.copper_loss_study` (no FEMM, 2 s, after the studies and `copper_loss_tables.json`; also draws the four figures) | For the 26 turns x 8 x 0.315 mm winding at rated current and the MTPA angle at every speed (hypothetical above the corner speed, where the real machine is in field weakening): AC loss over DC loss 0.031 % at 3,000 rpm and 0.44 % at 16,330 rpm; strands in parallel at random add 13.8 % of the DC loss at 16,330 rpm. |

#### The winding studies

`winding.py` chooses the turns, the wire, the strands in hand and the parallel paths of a fixed geometry by enumerating every combination, so that the exact Pareto front of copper loss, peak current and corner speed (where the bus voltage is reached) is read off, not estimated, and uses it to grade NSGA-II and NSGA-III; `winding_femm.py` is its FEMM stage (the rated point, the field of the copper, a check that the turns do not change it). `winding_study.py` repeats the enumeration for the optimized motor with everything modelled since: the copper losses of `copper_loss.py`, the thermal network (`thermal.py`) and the flux maps (`maps.py`, `iron_loss.py`); each study has a figures module that it calls. Outputs go to `out/optimization/winding/<label>/` and `out/optimization/winding_study/`.

| File | What it does, and how | Run | Result |
|---|---|---|---|
| `optimization/winding.py` | Winding study of a fixed geometry (the reference one by default): one numpy sweep enumerates all 102,600 combinations of turns, wire, strands in hand and parallel paths, so the exact Pareto front (loss, peak current, corner speed) is read off and verified; NSGA-II and NSGA-III are graded against it by hypervolume ratio, IGD and exact points found. | `uv run python -m optimization.winding --label reference` (about a minute, 25 s of FEMM; `--reuse-femm` skips FEMM; exit status 0 if all 13 checks pass) | AC loss at most 0.055 % of the loss of a front design; NSGA-II reaches a hypervolume ratio of 0.949 but finds the exact optimum for 36.5 % of the front's points. |
| `optimization/winding_femm.py` | FEMM side of the winding study (116 solves in one run): the rated point (100 ampere-turns a coil side at its MTPA angle: the rated torque and the flux linkages each winding is scaled from), the field of the copper (G, mean square of dB/d(theta_e) over the coil area, from 48 rotor positions) and a check that the turns leave that field unchanged. | | Rated torque 1.12880 N.m; G 6.6824e-4 T^2/rad^2 (48 positions used); 5, 10 and 20 turns give the same field of the copper (0.0 T apart). |
| `optimization/winding_figures.py` | The four pictures of `winding.py`, no FEMM, each with its numbers in a CSV beside it: the exact front on two projections, NSGA-II and NSGA-III over the exact front, the hypervolume ratio and the share of exact points against generation, and the copper loss split into DC and AC against the fill. Called by `winding.py` (`--no-figures` skips them). | | |
| `optimization/winding_study.py` | The winding optimizer for the optimized motor: enumerates 20,316 windings (up to 30 strands in hand), applies the thermal limits (network with the copper losses of `copper_loss.py`) and the voltage rule (flux maps), and reads off the exact front of short-term current, corner speed and copper loss at a high-speed point, verified against all designs. | `uv run python -m optimization.winding_study --stage headline` (7 s); `uv run python -m optimization.winding_study` (everything and the figures, about 95 s); `uv run pytest tests/test_winding_study.py -q` (37 tests, 8 s); no FEMM, needs the optimized design and flux maps from earlier runs in `out/` | At 60 mm stack, 48 V, shaft fan: the exact front has 8 designs; the recommended winding is 9 turns a coil side, 4 paths, 7 x 0.56 mm strands in a cluster, 81.5 A short-term. |
| `optimization/winding_study_figures.py` | The pictures of `winding_study.py`, no FEMM: the front with the recommended winding, what the shortlisted windings' copper loss is made of, the strand arrangements, the fronts of the four stacks with the bus, magnet and fan variants, the cap on strands in hand, and the torque-speed envelopes. Called by `winding_study.py`. | | |

### 10. The thermal network, the flux maps and the motor map

The four parts below are written up in the repository's [README](../README.md) (steps 8, 9 and 11) and in [Motor map.md](../Motor%20map.md); the flux maps' MATLAB tables and scripts are in [`matlab/maps/`](../matlab/maps/), validated in MATLAB R2025b (2026-11-11); the Simulink block is the next step.

#### Thermal network

A lumped thermal network turns the motor's losses into part temperatures and so into the current each cooling can carry, checked against FEMM and CalculiX heat-flow solutions of one stator slice; it reads the optimized design from `out/optimization/final/final.json` (written by `optimization/finalize.py`), and the machine-level modules also need the maps listed under "Flux maps and iron loss".

| File | What it does, and how | Run |
|---|---|---|
| `optimization/thermal.py` | Lumped thermal network: eleven nodes (winding, end turns, teeth, yoke, housing, rotor, magnets and others) joined by thermal resistances, solved as a linear system. Takes the losses as inputs; returns temperatures, steady and against time, and the current at which the winding insulation or the magnets reach their limit first, for four coolings. | `uv run python -m optimization.thermal` (self-checks against textbook cases, a speed test, a one-line summary) |
| `optimization/thermal_geometry.py` | Draws one slot pitch of the stator (the slot and half a tooth each side) as heat-conduction regions in millimetres with shapely: winding block, liner, teeth, yoke, contact layer, housing. FEMM's heat solver and CalculiX both take these regions, so the two solve the same slice. Pure Python; no solver. | `uv run python -m optimization.thermal_geometry` (draws the slice, prints its areas against `motorgeo`'s, saves a picture) |
| `optimization/thermal_fem.py` | Calibrates the heat solvers on cases with exact answers (a heated cylinder, a layered annulus; three meshes; tolerances fixed before the first run), then solves the slot-pitch slice in FEMM and compares it with the network's reduced 2D form (winding hot spot and mean, iron-region means) for several variants. Exit status 0 only if every check passes. | `uv run python -m optimization.thermal_fem` (all stages; `--only STAGE` for one of `femm_cal`, `ccx_cal`, `sector`, `sector_mesh`, `sector_split`; `--reevaluate` and `--rederive` work on saved rows with no solver) |
| `optimization/thermal_ccx.py` | Solves the same slice in CalculiX 2.23 as a second, independent check: Gmsh makes a conformal mesh refined at the liner and contact layer, a plain-text deck holds the heat sources and the outer film coefficient, and region means are integrals over the curved elements. Reuses the variants and tolerances of `thermal_fem.py`; no FEMM. | `uv run python -m optimization.thermal_ccx` (every variant; `--only base --only iron_only` for some) |
| `optimization/thermal_machine.py` | Drives the network with the motor's own models (flux maps at the MTPA point, the iron-loss map, the copper-loss model as a function of copper temperature) behind one `Machine` object. `continuous_limit` bisects for the largest current that keeps winding and magnets within their limits; `short_term` gives an overload's torque and time from cold. | `uv run python -m optimization.thermal_machine` (one worked example and its speed) |
| `optimization/thermal_study.py` | Asks the network the design questions for each cooling (natural, forced air, liquid jacket), stack length and insulation class (F, H) at the rated speed: sustainable loss and its binding limit (winding or magnets), time constants, overloads, sensitivity to each assumed coefficient, top speed. Writes CSV tables and four figures; no solver. | `uv run python -m optimization.thermal_study` (`--no-figures` leaves the pictures out) |
| `optimization/thermal_figures.py` | Draws the thermal study's four pictures with matplotlib (no solver): the network as a diagram with its resistances, node temperatures at each cooling's continuous limit, sustainable current against stack length, and heating curves. Each has its numbers in a CSV beside it. | `uv run python -m optimization.thermal_figures` (also called by `thermal_study.py`) |
| `optimization/thermal_fan_study.py` | The shaft fan: a model (air speed in the fin channels proportional to shaft speed, the pressure the channels and cowl ask for, shaft power over a fan efficiency) with two sizings; the continuous limit against speed for each cooling at MTPA currents; where the heat goes; a capability table; sensitivity. All powers are estimates; no solver. | `uv run python -m optimization.thermal_fan_study` (`--no-figures`; `--quick` for the 60 mm stack only; `--no-sensitivity`; `--figures-only` redraws from the saved `fan_study.json`) |
| `optimization/thermal_fan_figures.py` | Draws the shaft-fan study's four pictures with matplotlib (no solver): the fan's air speed and shaft power against speed with the sizing trade, the continuous limit against speed, where the heat goes, and capability against stack length; each has its numbers in a CSV. Called by `thermal_fan_study.py`. | |

#### Flux maps and iron loss

FEMM computes the optimized motor's flux linkages and torque over the d-q current plane and the flux-density waveforms of its steel, and these modules analyse and check that output, fit the iron loss, draw the figures and export the maps for a Simulink block, leaving `flux_map.npz` and `iron_map.npz` in `out/optimization/maps/chosen/`.

| File | What it does, and how | Run |
|---|---|---|
| `optimization/maps.py` | The flux maps as callable functions: `FluxMaps` gives `psi_d`, `psi_q`, torque, ripple, apparent and incremental inductances and the MTPA path at any current (`i_d`, `i_q`), for any winding (turns, paths) and stack length, by a bicubic spline over FEMM's grid and a scaling rule (the field depends on ampere-turns only). Re-exports `iron_loss`. | `uv run python -m optimization.maps` (loads the maps, prints a few values, times each call) |
| `optimization/maps_femm.py` | The FEMM side of the maps: tasks that `femm_queue.femm_pool` workers run for `maps_run.py` on the optimized motor (2D, fine mesh): flux linkages and torques at given currents and positions; frozen permeability, separating the magnets' flux from the current's in saturated steel; each steel triangle's flux-density waveform over one electrical period. | |
| `optimization/maps_run.py` | The batch driver of the FEMM runs: plans the regression, lamination-fill, position-count, mirror, flux-grid (both halves of the current plane), held-out, frozen-permeability and iron-loss stages, runs them through the solver queue in batches, releasing the solver between batches, and saves each result as it comes, so a stopped run resumes. | `uv run python -m optimization.maps_run STAGE [STAGE ...]`: `regression lamfill`, then `kcheck mirror heldout flux`, then `loss losscheck`; `status` lists what is done (no FEMM) |
| `optimization/maps_report.py` | Analyses the FEMM rows: builds `flux_map.npz` (mean over rotor positions) and `iron_map.npz` (per-region loss sums) and runs each check against limits written before the numbers existed (positions, torque, mirror symmetry, interpolation, reciprocity, frozen permeability, loss grid); tabulates cross-saturation and its effect on the MTPA angle. | `uv run python -m optimization.maps_report SECTION [SECTION ...]` with `flux`, `cross frozen` and `loss` (no FEMM; each after the matching `maps_run.py` stages) |
| `optimization/maps_figures.py` | Draws the maps' figures with matplotlib (no FEMM), each with its numbers in a CSV: flux and torque maps over the current plane with the MTPA path, cross-saturation and reciprocity, inductances, iron loss against current at three speeds, the Bertotti fit against the datasheet, and the position-count and mirror-symmetry checks. | `uv run python -m optimization.maps_figures` (all figures; or some, for example `flux_maps iron_loss`) |
| `optimization/maps_matlab.py` | Arranges the maps in the tables Simulink's FEM-Parameterized PMSM block takes (flux linkage, torque, iron-loss coefficients, an MTPA table, the numbers a MATLAB run must reproduce); writes `matlab/maps/fem_maps.mat` (the `matlab/` folder is published later) and reads it back to check every array. MATLAB is NOT run here and was not run for it (the MATLAB runs come later, in a validation pass). | `uv run python -m optimization.maps_matlab` (after `maps_report.py` flux and loss; prints the check and the expected numbers) |
| `optimization/iron_loss.py` | A Bertotti iron-loss model (hysteresis, classical, excess) fitted to the M-19 datasheet and cross-validated, applied to the flux-density waveform of each mesh triangle and reduced to three speed-independent sums per region (teeth, yoke, rotor): loss = `S_h f + S_e f^2 + S_x f^1.5`. `iron_loss(i_d, i_q, rpm, stack_mm)` is the fast function. | `uv run python -m optimization.iron_loss` (fits, cross-validates and self-tests; no FEMM) |

#### Motor map

The motor map turns the flux maps, the iron-loss map, the copper-loss model and the thermal network into the torque-speed envelope and the loss and efficiency map of the optimized motor, for any winding, stack length, bus voltage and current limit.

| File | What it does, and how | Run |
|---|---|---|
| `optimization/motor_map.py` | The engine. In the d-q frame it solves the steady-state voltage equations inside the current limit and the voltage limit (a fraction of the bus): MTPA below the corner speed, field weakening and MTPV above it. Gives losses, shaft torque, efficiency and two controls (MTPA, minimum-loss); the solver is a ray-and-circle scan with exact zooms. | `uv run python -m optimization.motor_map` (a short demonstration) |
| `optimization/motor_map_stack.py` | What a stack length changes besides the electromagnetics: steel, magnet and copper masses, the rotor's moment of inertia (steel polygon, magnets, shaft), the magnets to buy, and the winding of each stack (the same on every stack, the one the winding study chose for each, or turns scaled to hold the corner speed). | `uv run python -m optimization.motor_map_stack` (the numbers of both windings for the four stacks) |
| `optimization/motor_map_thermal.py` | The motor map's current limits from the thermal network: at each speed, the best point inside the current and voltage limits gives the iron loss, the network returns the margin to the winding and magnet limits, and bisection on the current finds the continuous limit (copper temperature iterated). Also a short-term limit with its time from cold. | `uv run python -m optimization.motor_map_thermal` (the thermal rating of the 20 and 60 mm stacks' windings in each cooling at 3,000 rpm, against the network's own `sustainable()`) |
| `optimization/motor_map_run.py` | The motor map end to end: checks with limits written before the run (envelope against `maps.mtpa`, corner by hand, energy balance, MTPV condition, FEMM spot-check, thermal coupling, brute-force solver checks), then envelopes for the shaft-fan sizings and other coolings, efficiency maps, the stack table, figures. Inputs change by option, not code. | `uv run python -m optimization.motor_map_run --stages STAGES [--label NAME]` with `checks`, `run,figures`, `report` or `spot` (`spot` needs FEMM) |
| `optimization/motor_map_figures.py` | Draws the motor map's figures with matplotlib (no FEMM) from the run's saved results, each with its numbers in a CSV: torque and power envelopes for the shaft fans and other coolings, the highest speed each fan allows, losses, efficiency maps, the current plane, the stack table, the winding study's front and the 150 C magnet grade. | `uv run python -m optimization.motor_map_figures [label]` (after `motor_map_run.py`; the label is the run's folder, default `final`) |

#### Short-circuit check

The short-circuit check asks what a permanent-magnet motor does at speed when its inverter stops controlling it.

| File | What it does, and how | Run |
|---|---|---|
| `optimization/short_circuit.py` | What the motor does at speed when its inverter stops, and what an active short circuit costs. From the flux maps it solves `v_d = v_q = 0` with `fsolve` (cross-saturation included), finds the characteristic current `psi_d(i_d, 0) = 0` and gives the braking torque and the speed where the magnets' voltage passes the bus. Steady state only. | `uv run python -m optimization.short_circuit` (prints the table) |

### 11. The tests

The tests are run from `python/` with pytest and, like the code, assume Windows. `uv run pytest -m "not femm"` runs the suite without starting FEMM: the tests marked `femm` start real FEMM 5.0 processes, but the fixtures in conftest.py import `femm_session`, and with it FEMM 5.0's Python binding, for every test, so the binding must still be installed. In the table, Needs gives the number of tests marked `femm`, or says `results in out/` where tests read files that earlier runs of the studies wrote under `out/`, which is not part of the repository (the optimized design `out/optimization/final/final.json` and the flux and iron-loss maps in `out/optimization/maps/chosen/`); counts are test functions. `test_paths.py` and parts of the B4 and B5 bench tests also expect the programs named in `config.toml` to be installed. Several modules pin the wording of docstrings and of the README, so a change to those texts shows up as a test failure.

| File | What it tests | Needs |
|---|---|---|
| `tests/test_bench.py` | The bench's shared part (`bench/__init__.py`, `bench/run_bench.py`) with no solver: how a check is held against its expectation, `--only`, exit codes and `summary.json`, output roots and the run lock, and source scans that every program is started through `femm_queue`. Also pins the wording of run_bench.py's docstring and of its README row. | |
| `tests/test_bench_b1.py` | B1 (`bench/b1_femm.py`, Python to FEMM 5.0) without a solver: sweep positions and angles, the flux-linkage and torque-peak estimators, the analysis and its verdicts on synthetic rows with known answers, a stage run on a stub pool, and the limits the bench chose. | |
| `tests/test_bench_b2.py` | B2 (`bench/b2_gmsh.py`, Python to Gmsh) without a solver; Gmsh itself runs on tiny meshes and on the CAD drawings in `reference/`: the mesh read back (groups, areas, quality), chord error of fillets, DXF faces with the air band removed in memory, and that the drawings are not changed. | |
| `tests/test_bench_b3.py` | B3 (`bench/b3_elmer.py`, Gmsh to Elmer) without ElmerSolver: the solver input, the lamination fill, readers for the solver's printouts and result file, flux linkage, Park transform, waveform comparison, node matching on the real mesh, and the verdict logic. | |
| `tests/test_bench_b4.py` | B4 (`bench/b4_ccx.py`, Gmsh to CalculiX) without a solver: the hand estimate of the bridges' stress, the second-order mesh against motorgeo's areas, the magnet load and the deck, and the readers of reactions, von Mises stress and cut forces. | |
| `tests/test_bench_b5.py` | B5 (`bench/b5_prepomax.py` and its PrePoMax-side script) without PrePoMax: command-line options and help text, settings.bin and the process table, the case file, the checks of a good run and of a failed step, the picture, and the script that runs inside PrePoMax. | |
| `tests/test_bench_b6.py` | B6 (`bench/b6_ross.py`, Python to ROSS) without ROSS: the rotor's mass and inertias, the bearing, the Jeffcott hand estimate, the JSON that ROSS's environment returns, critical speeds, Campbell-diagram crossings and margins. | |
| `tests/test_bench_b7.py` | B7 (`bench/b7_salib.py`, `bench/femm_points.py`; Python to SALib to FEMM) without FEMM: the fixed choices, the four parameters and their ranges against motorgeo's checks, the seeded Morris sample, SALib on a known answer, exact comparison of two runs, the ranking and the figure. Builds a grid of 256 designs. | |
| `tests/test_bench_b8.py` | B8 (`bench/b8_matlab.py`, `bench/b8_mtpa_map.m`; a flux map interpolated in MATLAB) without FEMM or MATLAB: the map grid, Python's MTPA search against a closed form, the file the script reads and what the script may do, the MATLAB command and processes, and the checks. | |
| `tests/test_bench_b9.py` | B9 (`bench/b9_rules.py`): the rules shown with two bench runs at once, here with stand-in child processes: starting and ending only its own children, reading what a run printed, comparing two runs' numbers, rules read from runs.json, serialization on one root, the picture and the six checks. | |
| `tests/test_check_tools.py` | `check_tools.py` and the cases under `checks/`, with no tool run: missing-tool rows, exit codes, the CSV and `--only`; the known answers each case compares with (Lame ring, Euler-Bernoulli shaft, Ishigami indices, Ampere's law); the settings.bin reader and MATLAB process tracker; scans that programs start through `femm_queue.run_solver`. | |
| `tests/test_compare.py` | `validation/compare.py` without FEMM: the rules it judges FEMM 5.0's numbers by (percent change, floors, tolerances, group verdicts), the log readers and what it must notice. The last test runs the whole comparison on real folders and needs FEMM 4.2's reference outputs (`femm42-out/`, not included). | `results in out/` (1 test, skipped without them) |
| `tests/test_compare_materials.py` | `validation/compare_materials.py`: it says "equal" only when every number is, and names what moved; JSON, CSV and figure comparisons on temporary files, with tolerances, missing and extra items, and pixel-by-pixel figure checks only when asked. | |
| `tests/test_copper_loss.py` | The copper-loss code without FEMM: exact wire results (Bessel against Kelvin functions, closed form against quadrature), PWM ripple against Parseval and a time-domain simulation, random strand packing, and `copper_loss.losses` (DC loss against winding.py, scaling laws, ripple, circulating current). | `results in out/` (4 of 16 tests) |
| `tests/test_femfile_femm5.py` | That `femfile.py` still reads what FEMM 5.0 writes: B per triangle from a .ans against FEMM's own value, and the default motor saved by FEMM 5.0 holding as many nodes, segments, arcs and labels as motorgeo drew. Both tests start a real FEMM; files go to `out/tests/`. | `FEMM 5.0` (2 of 2 tests) |
| `tests/test_femm_queue.py` | `femm_queue.py`: the machine-wide solver slot, the FEMM pool and `run_solver`, using stand-in processes that hold the slot, hang, crash or start children and a lock folder of its own for each test. Two tests start real FEMMs; the rest start no solver. | `FEMM 5.0` (2 of 49 tests) |
| `tests/test_femm_session.py` | `femm_session.py`, one private FEMM 5.0 per Python process: real FEMMs on ports of their own (never joining one on 48015), two processes at once, priority class, paths with spaces; the other tests read a program's version, check how FEMM_DIR is found, probe a port with a listener made for the test and check that the priority class is put back. | `FEMM 5.0` (8 of 16 tests) |
| `tests/test_flux_explorer_build.py` | What the interactive flux page's footer says about its data (`flux_explorer_build.provenance`): the day of the sweep tables and the FEMM version, named only when the data cannot be older than that FEMM. | `results in out/` (1 test, skipped without them) |
| `tests/test_hand_reference_check.py` | `validation/hand_reference_check.py`: that it makes the same three changes as `validate_full.hand_worker` (turn the rotor and its magnets, move the air-gap label out of the rotor group, set the three phase currents), by unit tests on a tiny model and tie tests that read hand_worker's source with `ast`. No FEMM. | |
| `tests/test_m19_steel.py` | The "M-19 Steel" block that motorgeo defines itself (`motorgeo.M19_STEEL_FEMM42`, a copy of FEMM 4.2's block): it equals FEMM 4.2's library file field by field (skipped where FEMM 4.2 is not installed), has the documented values, and is taken by FEMM 5.0 when `to_femm()` saves a .fem. | `FEMM 5.0` (1 of 3 tests) |
| `tests/test_maps.py` | The flux maps and the iron-loss map (`optimization/iron_loss.py`, `maps.py`, `maps_matlab.py`): loss operators against closed forms, the fit against the datasheet, the winding scaling rule, map consistency (parity, d-q against air-gap torque, MTPA against brute force) and the MATLAB-side numbers (the .mat read-back also needs `matlab/`, published later). | `results in out/` (8 of 13 tests, skipped without them) |
| `tests/test_materials_common.py` | `materials/common.py`: where the materials scripts save figures (`out/materials`, another folder only when an environment variable asks) and which FEMM material library they read (FEMM 5.0's has no "M-19 Steel" block). Figures go to temporary sandboxes; the library tests skip where FEMM is not installed. | |
| `tests/test_mesh_checks.py` | `validation/mesh_checks.py`: the model it solves is the model's own with every mesh size scaled, and its measures are the study's, checked on known waveforms and CSV rows. Two tests start FEMM; one of them and one more read FEMM 4.2's reference outputs (not included) and are skipped without them. | `FEMM 5.0` (2 of 19 tests) |
| `tests/test_motor_map.py` | The motor map's engine (`optimization/motor_map.py`, `motor_map_thermal.py`, `motor_map_stack.py`): scaling, energy balance, the envelope against the MTPA table and the closed-form corner speed, the MTPV branch, level sets, thermal coupling, and the headline winding against the winding study's numbers. | `results in out/` (every test is skipped without the saved maps) |
| `tests/test_paths.py` | `paths.py` and `config.toml`: relative paths, missing or empty names, broken files; `config.toml` as it is on this PC (every program and folder it names must be there); who reads it; and a scan of the files git tracks that no script types a drive path of its own (tried on a small source first, skipped without git). | |
| `tests/test_provenance.py` | `validation/provenance.py`: the small analyses behind the report's hand-made numbers (slope per degree, best shift of a waveform, worst sample, a psi_d offset, pandas misreads, picture comparison), on made-up data with known answers. No FEMM. | |
| `tests/test_repeatable.py` | That FEMM 5.0 gives the same numbers on every run: the default motor is solved again (also on the fine mesh and in 2 and 4 simultaneous workers), every number is compared with `==` and the solution files byte for byte. | `FEMM 5.0` (all 3 tests; one runs for 2 and 4 workers) |
| `tests/test_rulings.py` | `rulings.py` and `stale.py`: the loader of the rulings file (design decisions with value, unit, status, source, step), the stamp a result carries (its rulings and git commit), the list of stale results and the command line, on the fixture `rulings_min.toml` and temporary copies; asks git. Pins the wording of the README row for these two files. | |
| `tests/test_run_all.py` | `validation/run_all.py` (re-runs every script on FEMM 5.0) with no study run and no FEMM started: the table of steps, the command line, the run_all.csv ledger, leftover-FEMM detection on made-up process lists, tiny child processes, the job object and lock. The check that every step's script exists looks for the three `flux_explorer_*` scripts. | |
| `tests/test_same_model.py` | `validation/same_model.py`, which says whether two FEMM files hold the same model: tiny models written as text (`fem_text_tools.make_fem`) changed one thing at a time, formatting that must not count, text that must be refused, the command line. Two tests save real models with FEMM 5.0. | `FEMM 5.0` (2 of 21 tests) |
| `tests/test_short_circuit.py` | `optimization/short_circuit.py`: the active short circuit's current and torque from the saved flux maps (braking torque equals copper loss over speed, the high-speed current tends to the characteristic current, scaling with turns, the conduction-speed formula). | `results in out/` (3 of 4 tests) |
| `tests/test_thermal.py` | `optimization/thermal.py` (the thermal network) and `thermal_geometry.py` without a solver: building blocks against textbook cases, the network against itself (heat out equals heat made, closed-form single node, transient ends at steady state, a limit is a root), and directions that must hold. | `results in out/` |
| `tests/test_thermal_fan.py` | The shaft fan of `optimization/thermal.py` and `thermal_machine.py` without a solver: the earlier coolings unchanged (twelve kept cases), the fan laws, heat flows that balance node by node, and the network driven by the flux maps, the iron-loss map and the copper-loss model. | `results in out/` (the tests of the motor models skip without the maps) |
| `tests/test_thermal_fem.py` | `optimization/thermal_fem.py` with no solver and no FEMM: the exact solutions the solvers are held to (cylinder, composite), the CalculiX deck writer and reader, the slice's segments, and the rule that turns the slice's numbers into a verdict. | `results in out/` (1 of 8 tests) |
| `tests/test_validate_full.py` | `validate_full.py`'s job lists: no two jobs may share a file name. Reads the source with `ast` and evaluates the job-list expressions as written, so no FEMM is started. | |
| `tests/test_winding_study.py` | `optimization/winding_study.py` without FEMM: the enumeration of windings (counted a second way), resistance against the copper-loss module, corner speed against the voltage equation, the high-speed solver, continuous and short-term ratings, the exact Pareto front, the pick and the rule table. | `results in out/` |
| `tests/conftest.py` | pytest set-up, not a test module: puts `python/`, `tests/` and `validation/` on `sys.path`, makes pytest's temporary folders under `out/.pytest`, quits a FEMM a test left open and restores the process priority class after every test, and holds the Windows PATH helpers `process_path`, `cut_process_path` and `path_is_put_back`. | |
| `tests/bench_test_tools.py` | Helper, no tests: what the bench test files share: `use_config` (a config.toml of the test's own, so nothing is written under the real `out/`), a fixture that keeps `run_bench.main()` from lowering the whole pytest process, `tiny_mesh` (a two-rectangle Gmsh mesh with known areas) and `P`, the folder above `tests/`. | |
| `tests/fem_text_tools.py` | Helper, no tests: `make_fem()` writes a small complete FEMM problem file as text, with any part changed by an argument; shared by test_same_model.py and test_hand_reference_check.py. No FEMM is needed to make or read these files. | |
| `tests/femm_test_tools.py` | Helper, no tests: what the femm_session tests share: the magnet they draw and solve, the worker function a spawned process imports (it has to live in a plain module), Windows process and priority-class look-ups, and the default-model solve used by test_repeatable.py. | |
| `tests/queue_test_tools.py` | Helper, no tests: what the femm_queue tests share: processes that hold the solver slot, stand-in functions for the pool's workers (they return, hang, crash or start a child), and handles that end a process only after checking its creation time. Only the two `femm` tests use it to start a FEMM. | |
| `tests/stand_in_pool.py` | Helper, no tests: stand-in programs for the pool tests, each run in a process of its own (`python -I stand_in_pool.py <mode> ...`): a process that opens a pool whose workers keep starting processes, a plain parent, a worker whose job cannot be made, the watch thread of a worker whose parent has gone, joining a job twice or failing to, a pool opened from a process that is itself in a job. | |
| `tests/stand_in_solver.py` | Helper, no tests: stand-in solver programs (`python stand_in_solver.py <mode> <folder> [seconds]`; modes `tree`, `orphan`, `launcher`, `sleeper`) that start children, announce their pid and creation time, sleep or exit at once. Standard library only; each lives 120 s at most. | |
| `tests/fixtures/rulings_min.toml` | Fixture, not a test: the smallest rulings file that test_rulings.py needs, three quantities (`rotor.bridge_outer`, `stator.slots`, `rotor.steel`) with value, unit, status, source, step and names; the tests edit single lines of a copy, so every line stays as it is. | |

## What is not in this folder

- **The built flux page and v2.** The interactive flux page, `pages/Rotor Flux Explorer.html` (about 17 MB), is not in this folder, and v2 of
  the page is published separately. This folder holds the v1 generator (`flux_explorer_sweep.py`, `flux_explorer_sweep120.py`,
  `flux_explorer_build.py`, `flux_explorer_template.html`); `validation/compare.py` checks the built page when it is there and reports it
  missing otherwise.
- **FEMM 4.2's reference outputs** (`femm42-out/`, 1.2 GB, with its SHA-256 list) are kept outside the repository.
  `validation/compare.py`, `validation/mesh_checks.py` and `validation/provenance.py` read them, `config.toml` names the folder
  (`femm42_out`), and `tests/test_paths.py` expects it to exist.
- **The MATLAB flux-map files** are in the repository's [`matlab/maps/`](../matlab/maps/), one folder up; `optimization/maps_matlab.py` writes
  `matlab/maps/fem_maps.mat` and reads it back.
- **The results of the studies** (`out/`) are git-ignored and not in the repository: the optimized design
  (`out/optimization/final/final.json`), the flux and iron-loss maps (`out/optimization/maps/chosen/`), the flux-explorer sweep and the
  other outputs the studies write. The thermal, winding, copper-loss, short-circuit and motor-map code and many tests read them; in a
  fresh clone those tests fail or are skipped until the studies have run ([section 11](#11-the-tests) names the modules).
