Bill-Gkionis/IPM-synRM/docs/figures/Calculating the initial injected currents and flux linkages.png

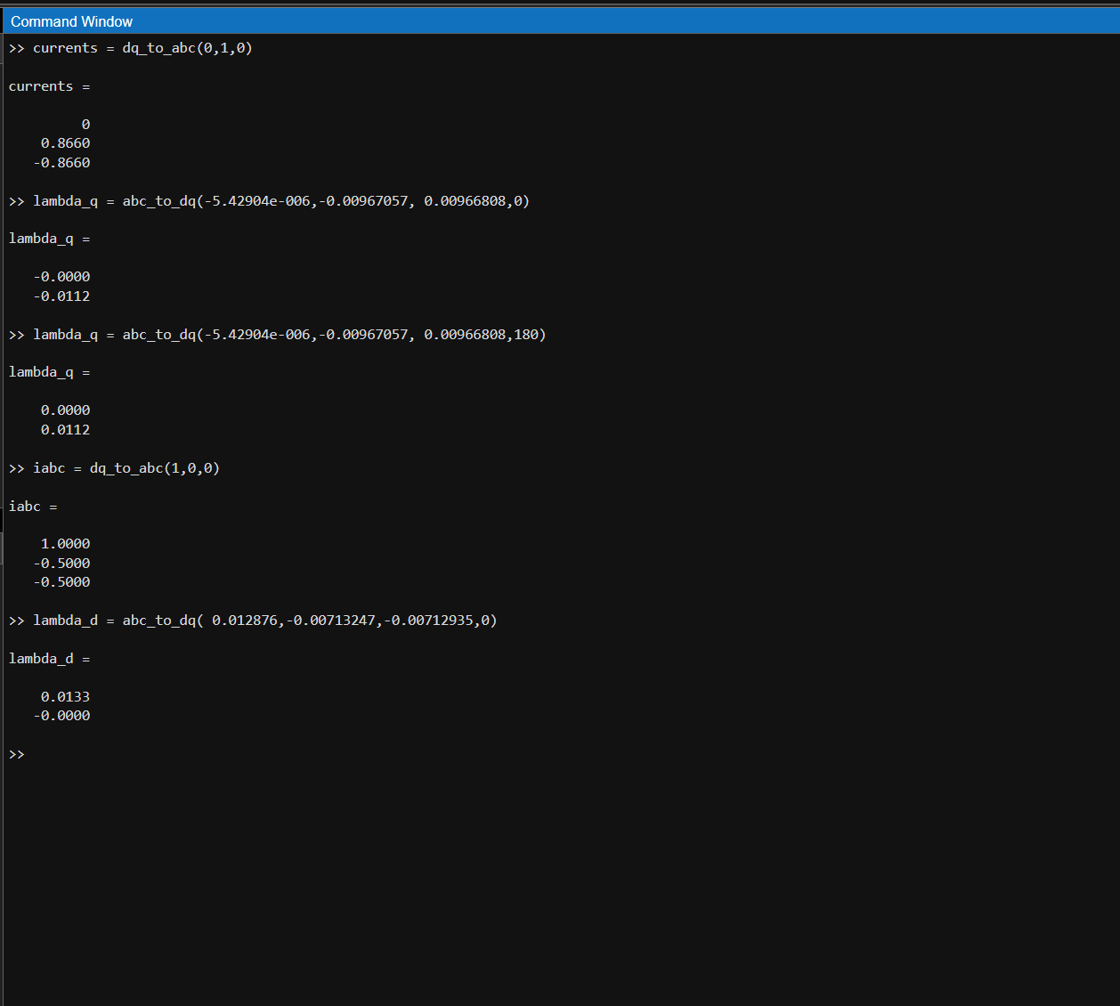
docs/figures/Calculating the initial injected currents and flux linkages.png
