Bill-Gkionis/IPM-synRM/docs/figures/FEMM_drawing.png

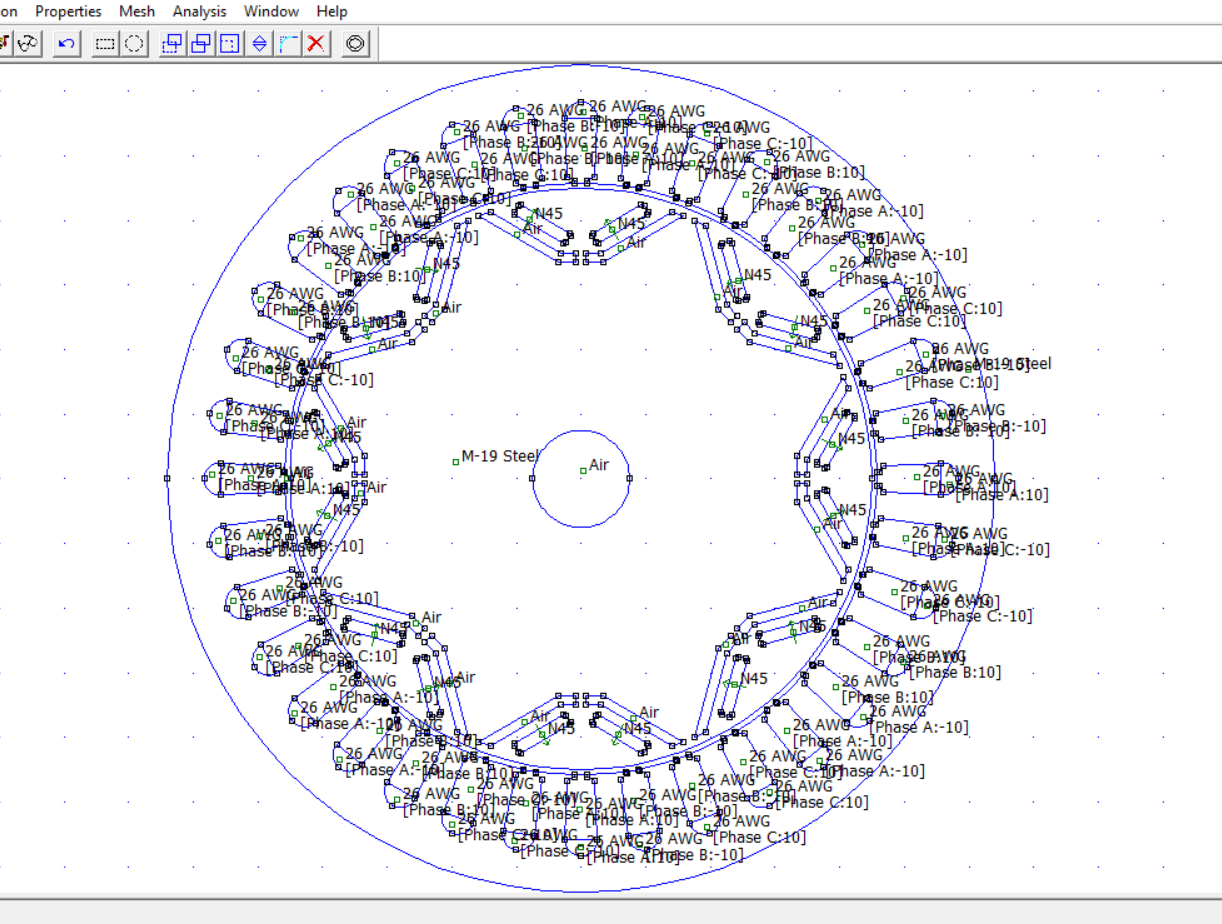
docs/figures/FEMM_drawing.png
