Bill-Gkionis/IPM-synRM/docs/figures/simulink_model.png

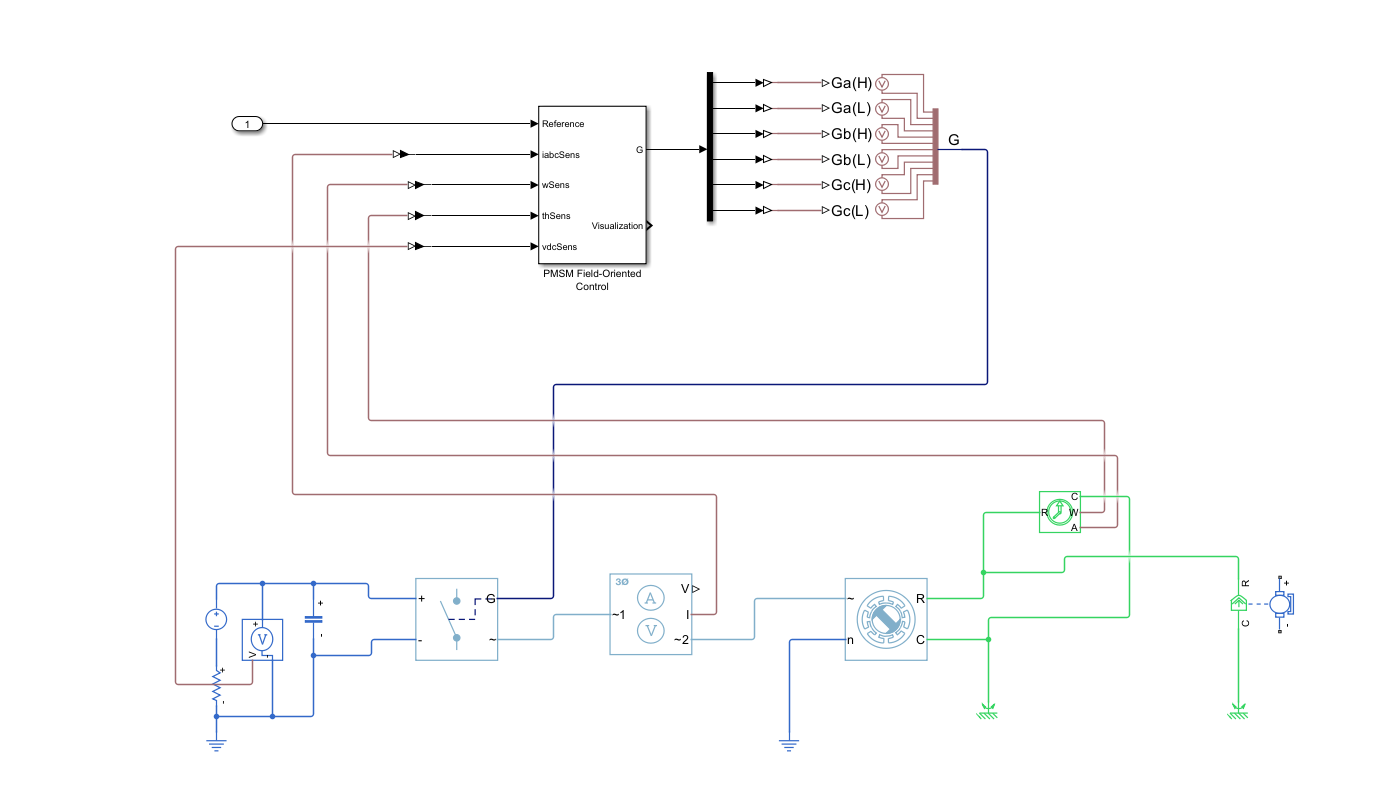
docs/figures/simulink_model.png
