Bill-Gkionis/IPM-synRM/docs/figures/stator_drawing.png

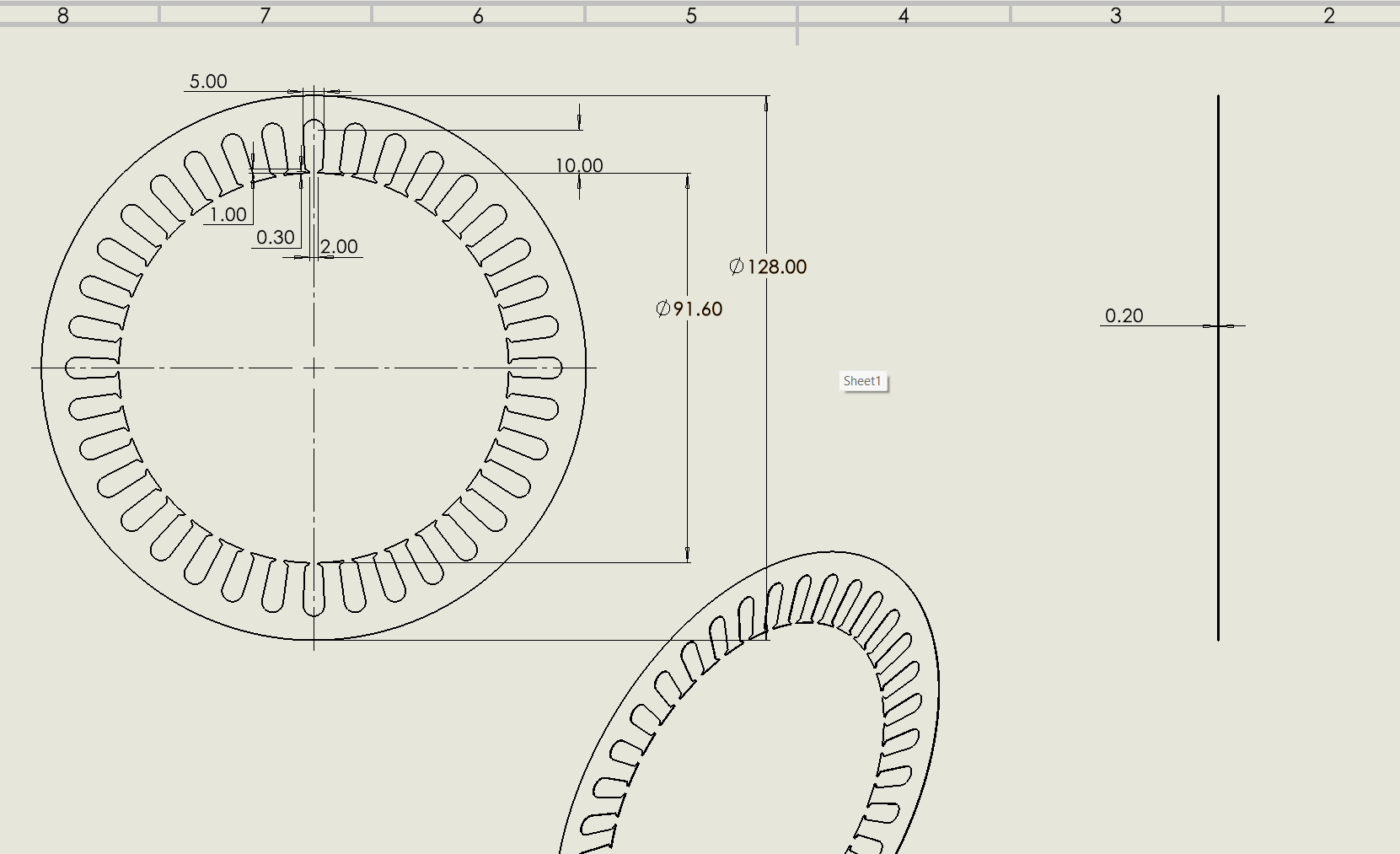
docs/figures/stator_drawing.png
