Bill-Gkionis/IPM-synRM/FEMM/screenshot_simulations/15 degrees.png

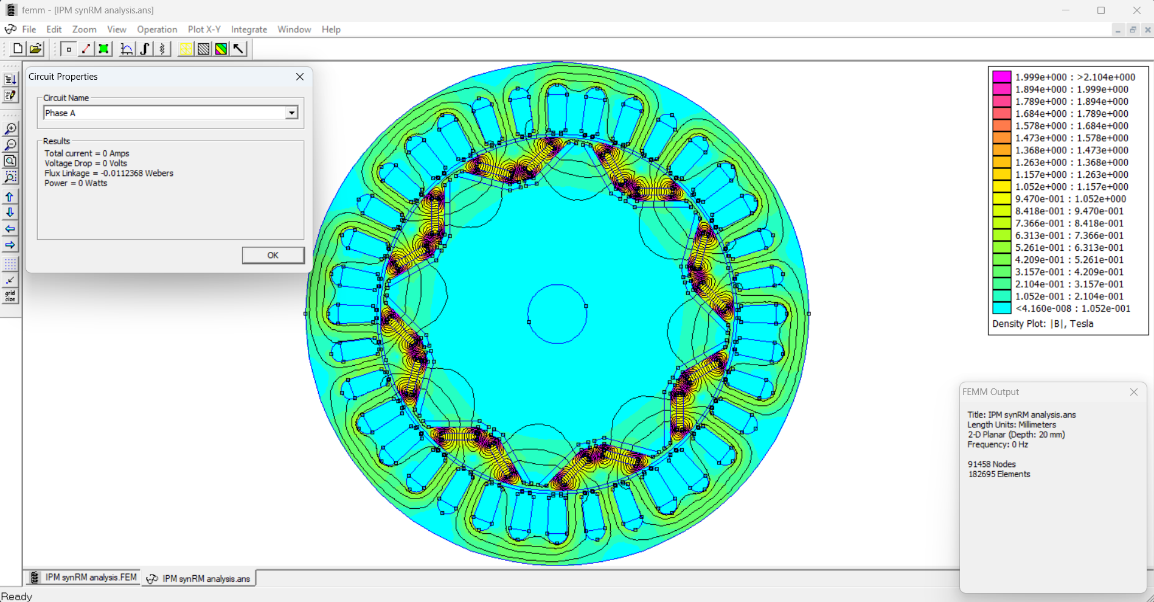
FEMM/screenshot_simulations/15 degrees.png
