Bill-Gkionis/IPM-synRM/femm/screenshots/Rotating at pre processor.png

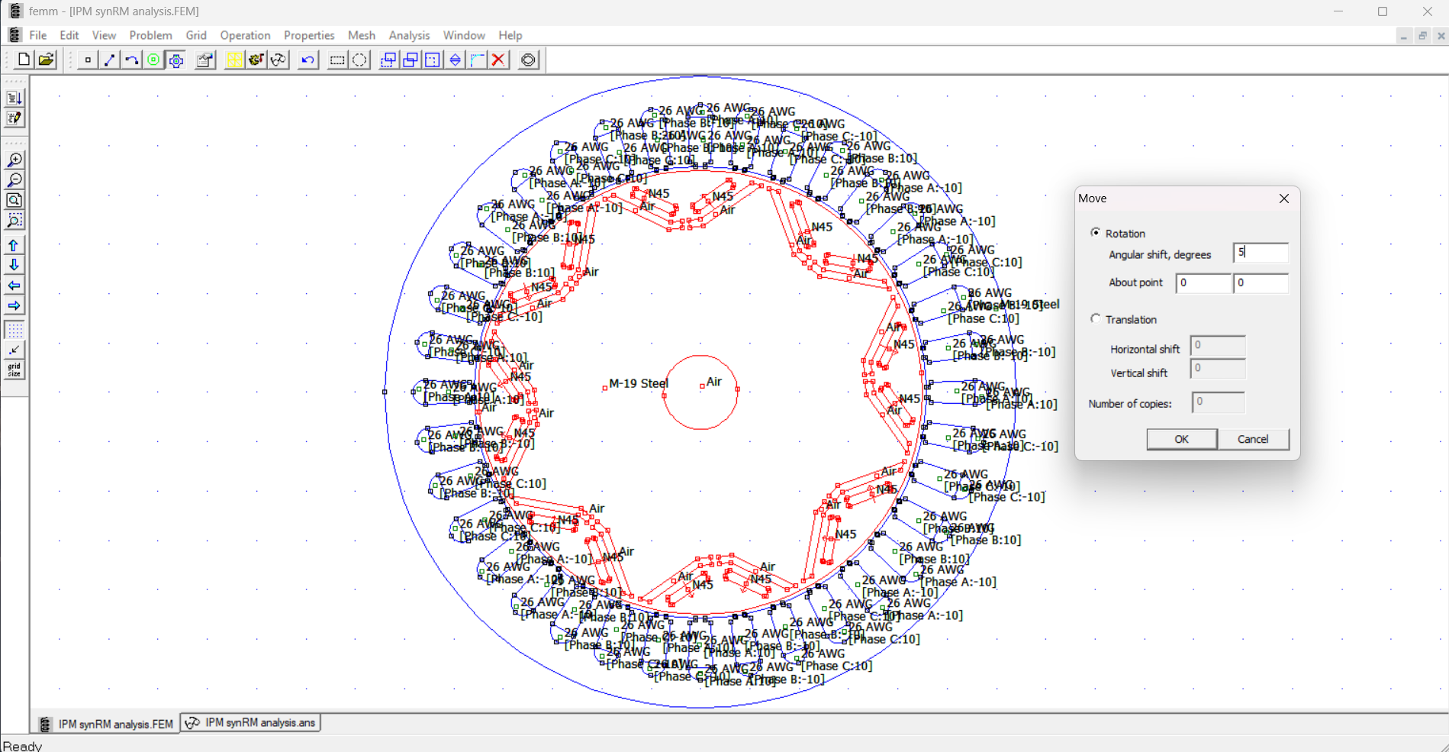
femm/screenshots/Rotating at pre processor.png
