Bill-Gkionis/IPM-synRM/screenshots/FEMM_simulation.png

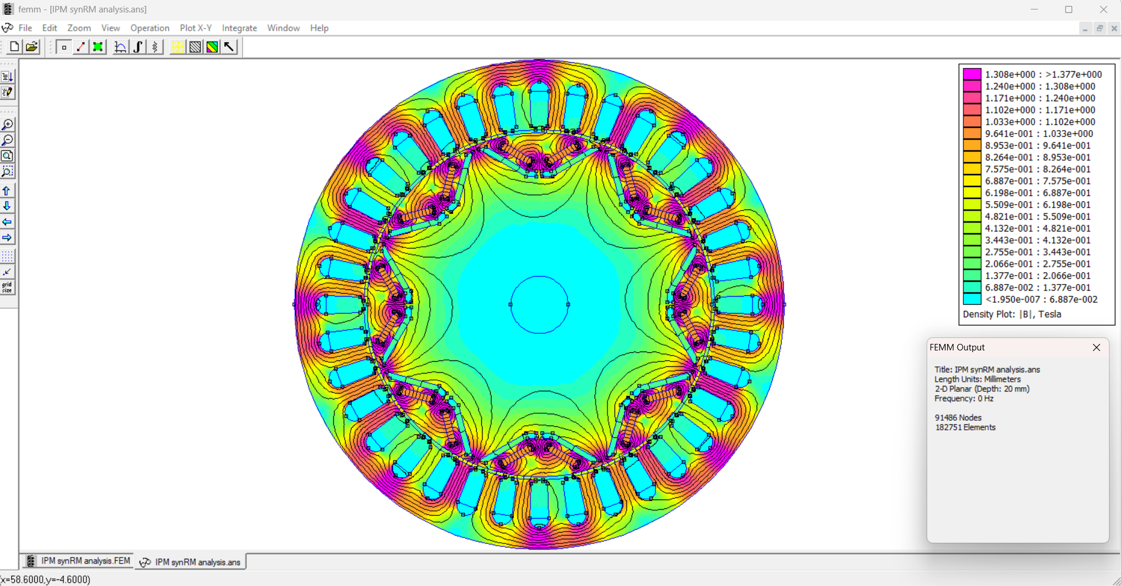
screenshots/FEMM_simulation.png
