Bill-Gkionis/IPM-synRM/screenshots/FOC not working.png

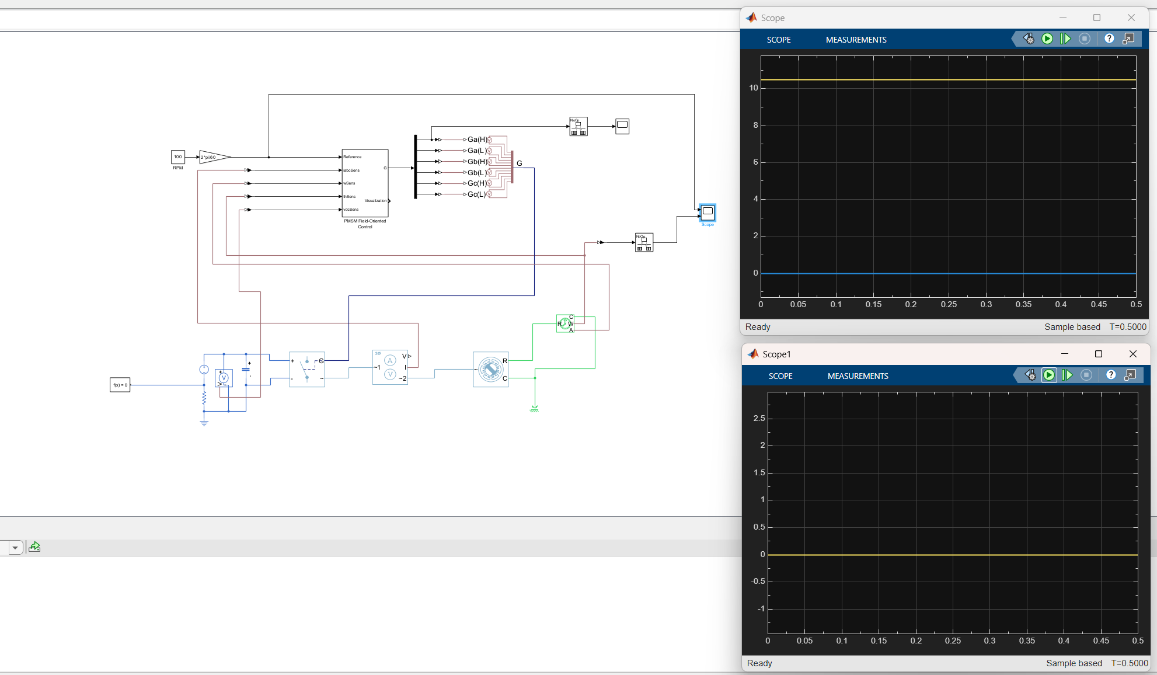
screenshots/FOC not working.png
