Bill-Gkionis/IPM-synRM/screenshots/Rotor moment of Inertia.png

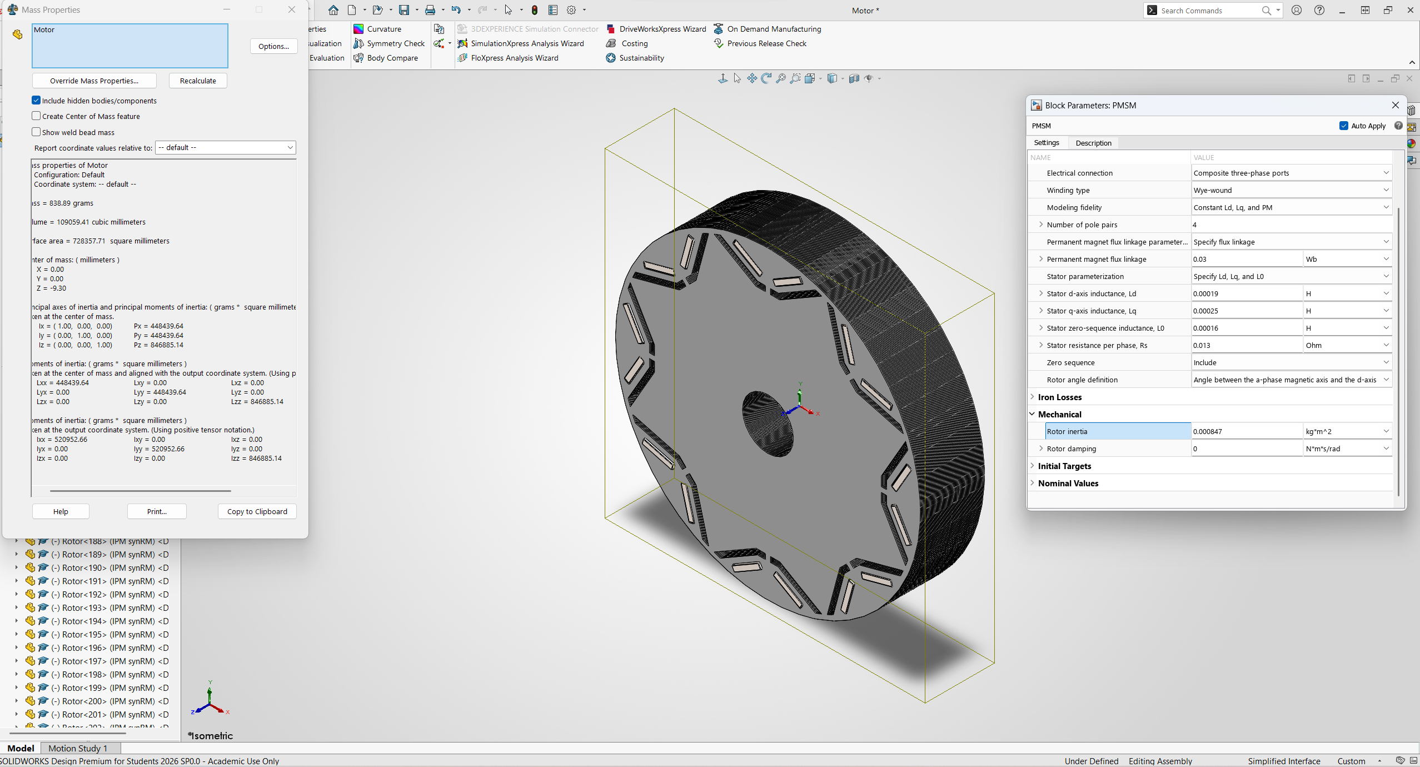
screenshots/Rotor moment of Inertia.png
