Bill-Gkionis/IPM-synRM/screenshots/rotor_drawing.png

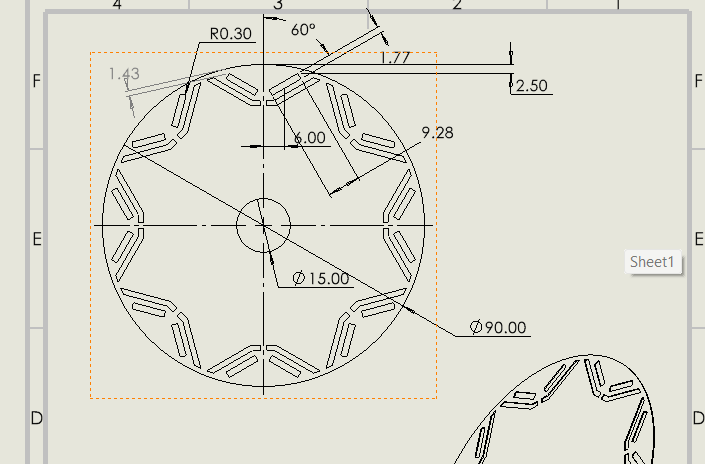
screenshots/rotor_drawing.png
