Bill-Gkionis/IPM-synRM/screenshots/Working simulink model.png

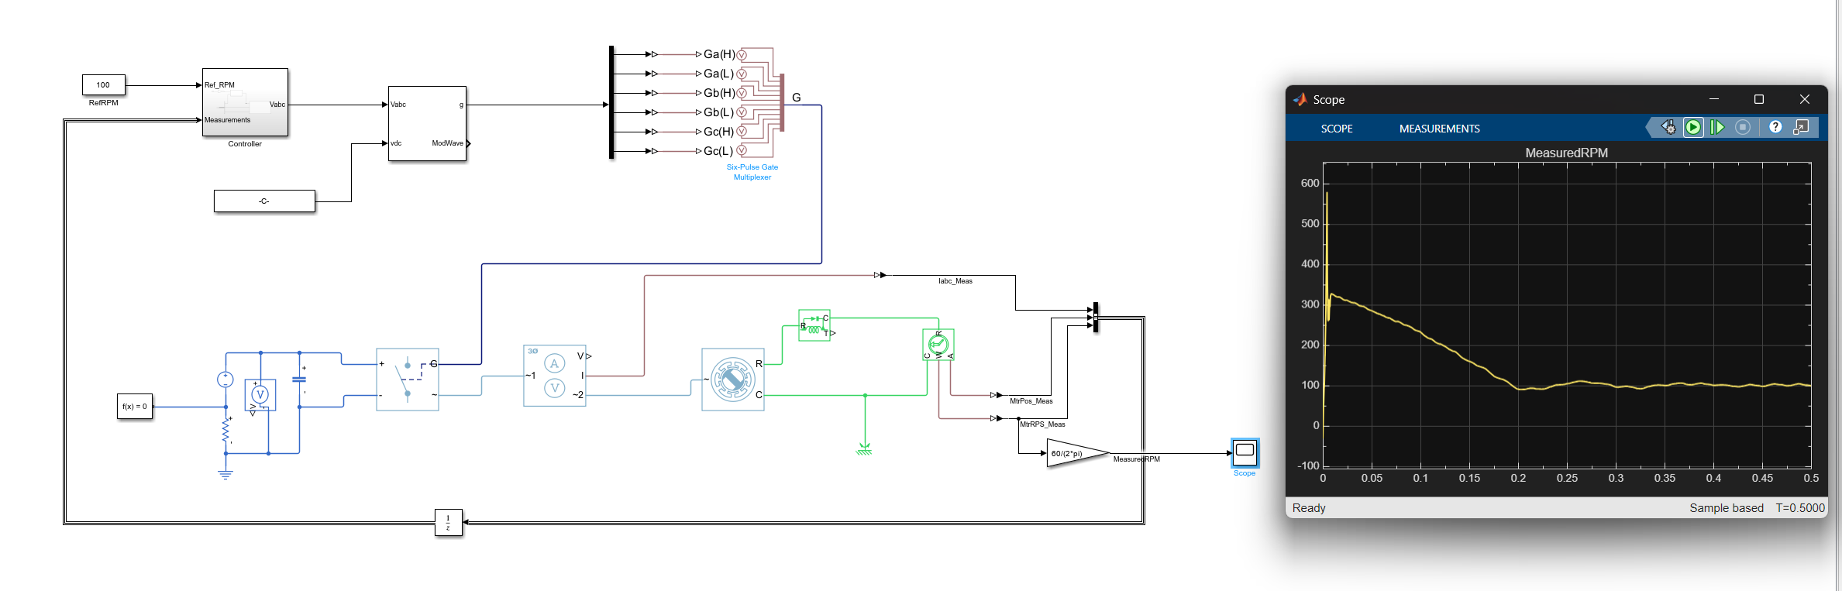
screenshots/Working simulink model.png
