Bill-Gkionis/IPM-synRM/cad/solidworks/Motor.SLDASM

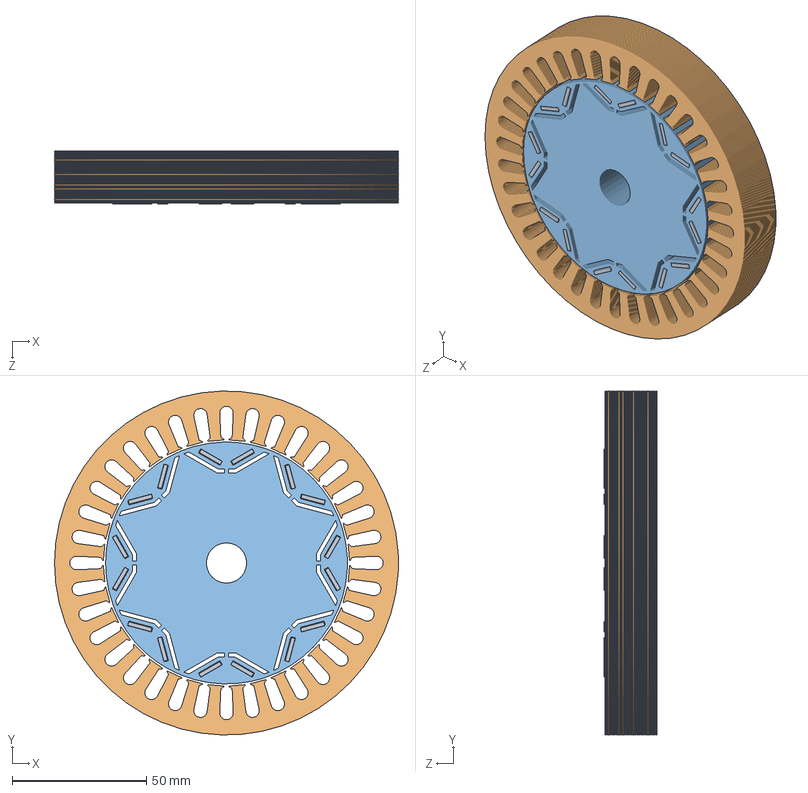
[picture p67: CAD file, 2026-11-05]
cad/solidworks/Motor.SLDASM
128.0 x 127.9 x 19.8 mm
Rotor x 63
Stator_refined x 65
Magnet x 16
