Bill-Gkionis/IPM-synRM/cad/solidworks/Magnet.SLDPRT

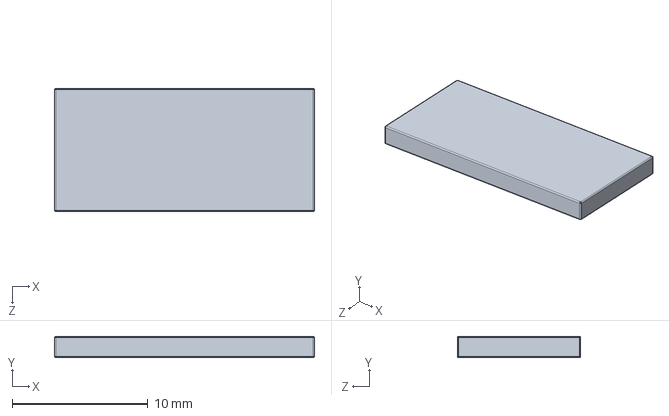
[picture p68: CAD file, 2026-11-05]
cad/solidworks/Magnet.SLDPRT
19.1 x 1.57 x 9.08 mm
