Bill-Gkionis/IPM-synRM/mechanical/solidworks/Rotor.SLDPRT

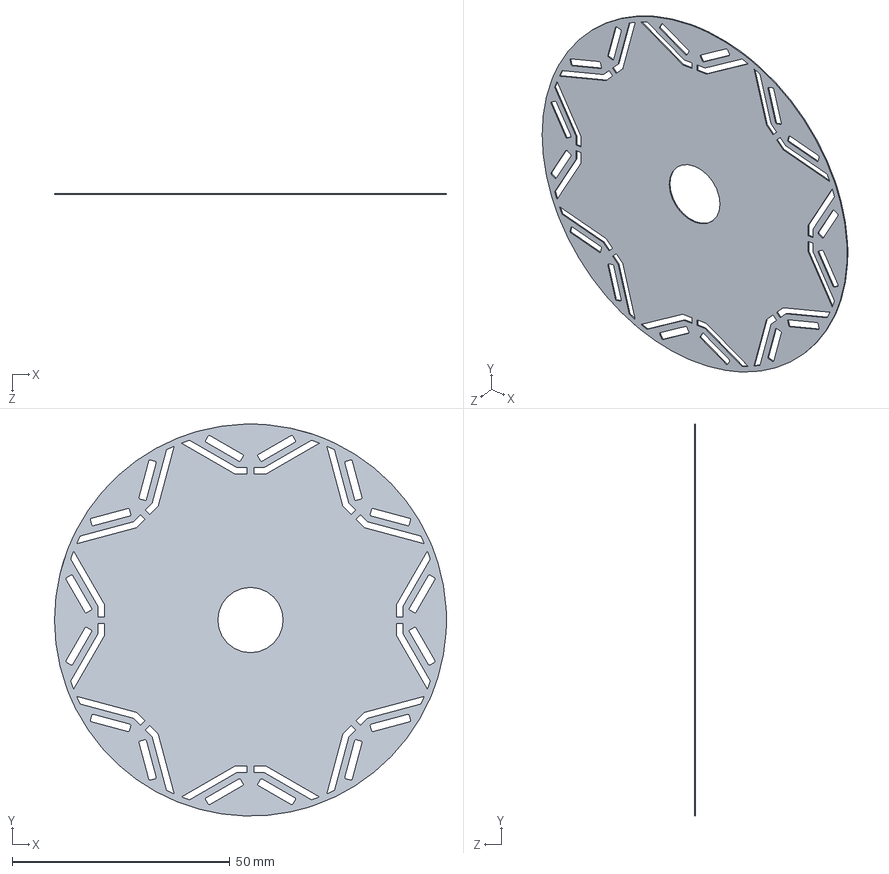
[picture p69: CAD file, 2026-03-03]
mechanical/solidworks/Rotor.SLDPRT
90.0 x 90.0 x 0.3 mm
