Bill-Gkionis/IPM-synRM/python/reference/SynRM rotor.DXF

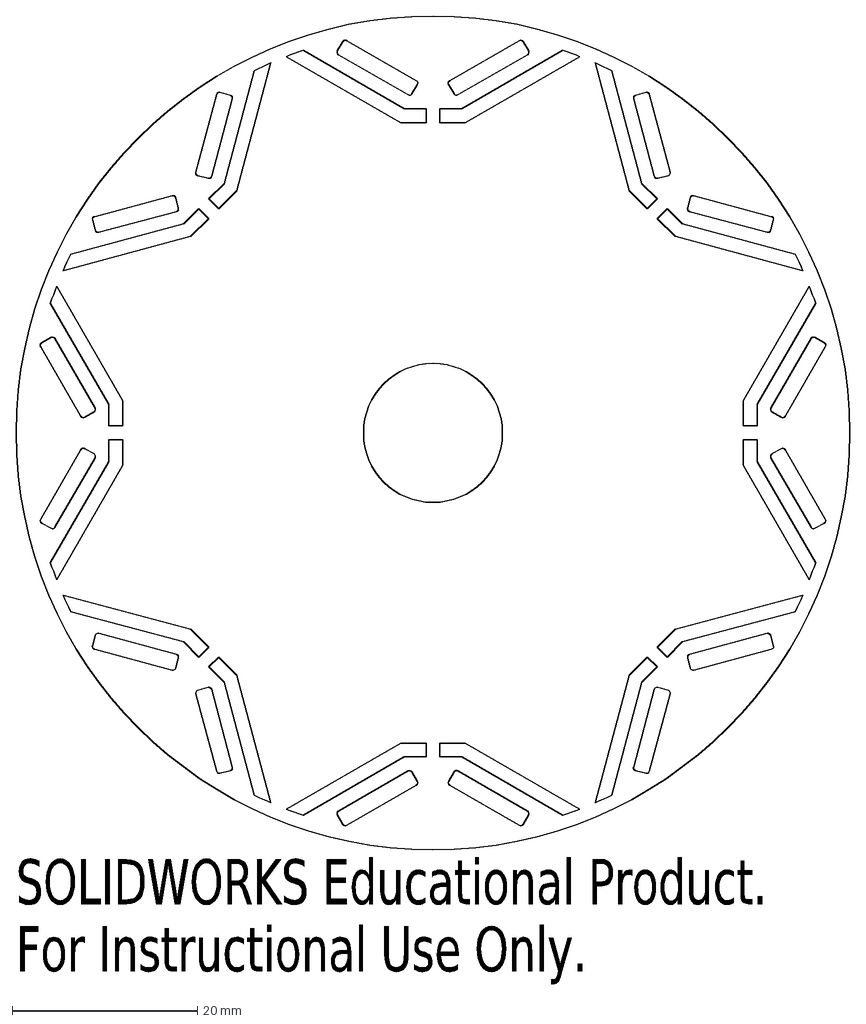
[picture p70: CAD file, 2026-11-09]
python/reference/SynRM rotor.DXF
SOLIDWORKS Educational Product.
For Instructional Use Only.
