Bill-Gkionis/IPM-synRM/mechanical/solidworks/Stator_refined.SLDPRT

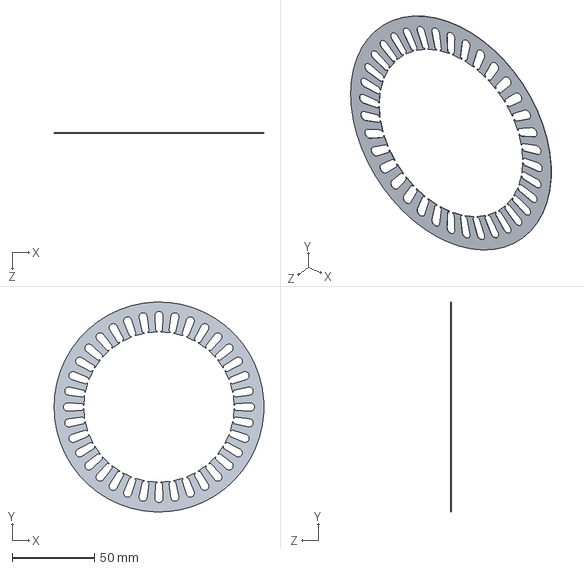
[picture p71: CAD file, 2026-02-11]
mechanical/solidworks/Stator_refined.SLDPRT
128.0 x 127.9 x 0.2 mm
