Bill-Gkionis/IPM-synRM/python/reference/Stator_refined.DXF

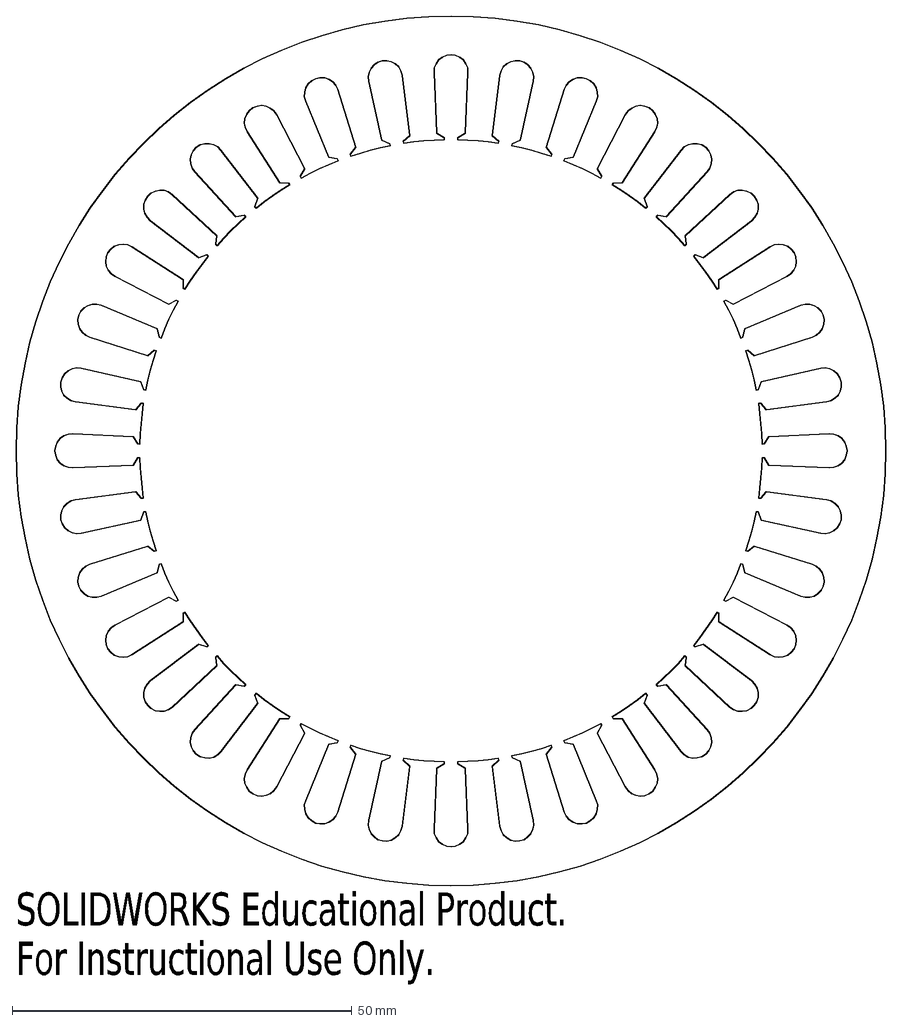
[picture p72: CAD file, 2026-11-09]
python/reference/Stator_refined.DXF
SOLIDWORKS Educational Product.
For Instructional Use Only.
