Bill-Gkionis/IPM-synRM/python/reference/Rotor.DXF

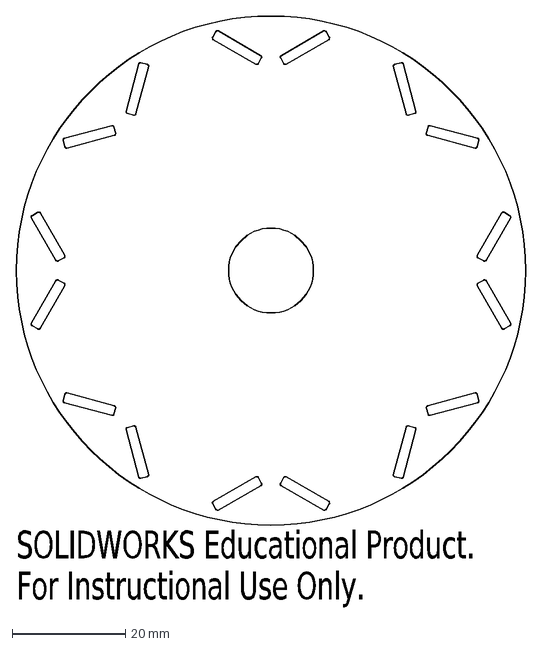
[picture p73: CAD file, 2026-11-09]
python/reference/Rotor.DXF
SOLIDWORKS Educational Product.
For Instructional Use Only.
