Bill-Gkionis/IPM-synRM/(list of files, cad)

Other CAD files:
mechanical/solidworks/Magnet.SLDPRT
cad/drawings/Magnet.SLDDRW
cad/drawings/Stator_refined.SLDDRW
mechanical/drawings/Rotor.SLDDRW
