Bill-Gkionis/IPM-synRM/python/materials/research/m19_dc_maker.csv

B_T | H_A_per_m
0.20 | 31.9
0.40 | 44.9
0.70 | 67.3
1.00 | 106
1.20 | 164
1.30 | 235
1.40 | 435
1.50 | 1109
1.55 | 1813
1.60 | 2802
1.65 | 4054
1.70 | 5592
1.80 | 9711
1.90 | 16044
2.00 | 31319
2.10 | 88491
