Bill-Gkionis/IPM-synRM/python/validation/femm5_vs_femm42.csv

study | quantity | femm42 | femm50 | delta_pct | verdict | kind | limit_pct | plain_pct | n | n_flagged | n_plain_flagged | note
not FEMM: identical | check_geometry: regions | 40 | 40 |  | identical | exact |  |  | 1 | 0 | 0 | README, 10-28
not FEMM: identical | check_geometry: centre rib [mm] | 1.5 | 1.5 |  | identical | exact |  |  | 1 | 0 | 0 | README, 10-28
not FEMM: identical | check_geometry: q-rib [mm] | 1.794 | 1.794 |  | identical | exact |  |  | 1 | 0 | 0 | README, 10-28
not FEMM: identical | check_geometry: outer bridge [mm] | 1.4 | 1.4 |  | identical | exact |  |  | 1 | 0 | 0 | README, 10-28
not FEMM: identical | check_geometry: web, thinnest point [mm] | 1.46 | 1.46 |  | identical | exact |  |  | 1 | 0 | 0 | README, 10-28
not FEMM: identical | check_geometry: tooth [mm] | 3.969 | 3.969 |  | identical | exact |  |  | 1 | 0 | 0 | README, 10-28
not FEMM: identical | check_geometry: yoke [mm] | 5.698 | 5.698 |  | identical | exact |  |  | 1 | 0 | 0 | README, 10-28
not FEMM: identical | check_geometry: magnet area [mm2] | 261.57 | 261.57 |  | identical | exact |  |  | 1 | 0 | 0 | README, 10-28
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
