Bill-Gkionis/IPM-synRM/python/validation/m19_curves.png

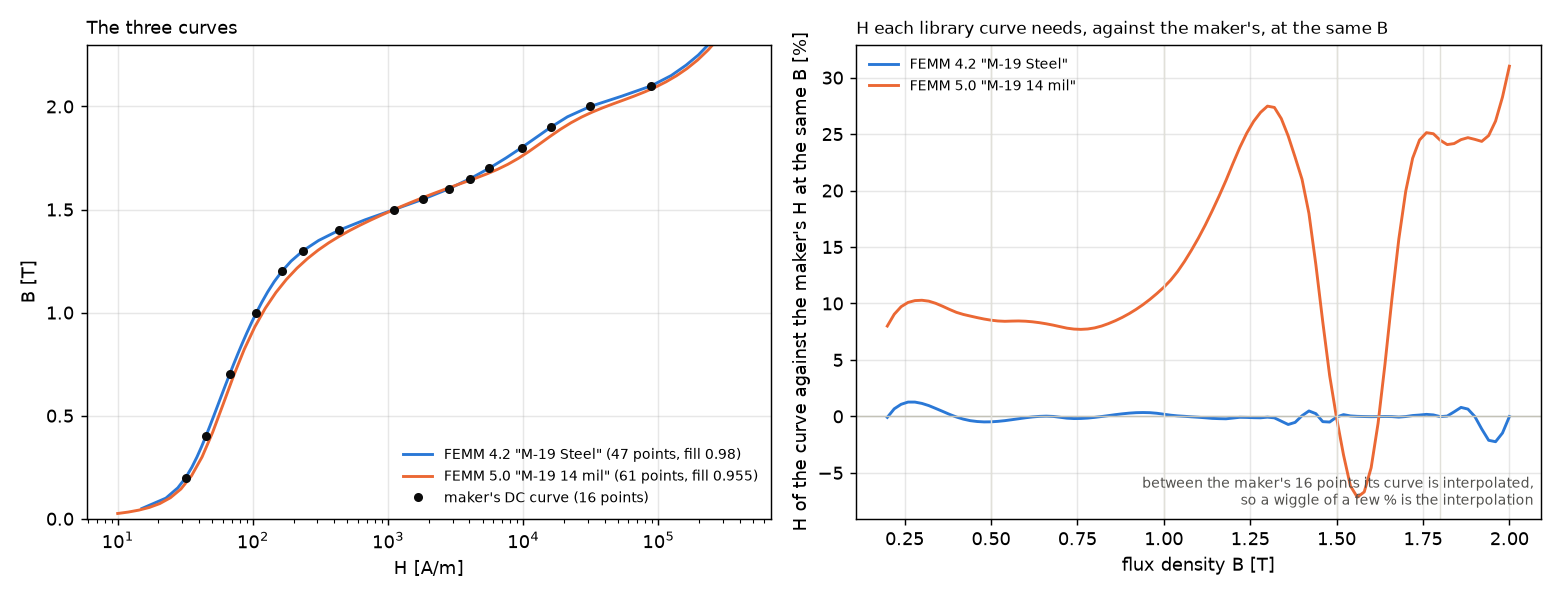
python/validation/m19_curves.png
