Bill-Gkionis/IPM-synRM/python/optimization/finalize.py

"""finalize: the study's last step. The coarse fronts re-scored on the fine mesh, the knee read there, the independent run's knee held
against it, and the chosen design written out as a DXF of the whole motor.

What it does, in order
    1. the fronts      reads front.csv of each run named (the study's tiers, and the independent cross-check), and keeps their union's
                       non-dominated designs on the coarse mesh
    2. the re-score    up to --max of them on the fine mesh (all, if there are fewer; else half evenly spread along the front by
                       torque and half the nearest to the coarse knee, so the knee's neighbourhood is dense), plus the reference design
                       and each run's own knee, so the before and after, and the runs, are compared on the same mesh
    3. the knee        the fine front's knee (design.knee: both objectives scaled 0..1 over the fine front, nearest the ideal corner).
                       That is the chosen design.
    4. the drawing     export.write: the whole motor as a DXF, checked by reading it back, with a preview
Why re-score instead of optimizing again on the fine mesh: the sweeps measured the two meshes against each other (51 designs): the
fine mesh moves the torque by +0.5 % and the ripple by -0.7 to -0.9 points, and it ranks the designs the same way (Spearman 1.00). A
second search on the fine mesh would refine inside a ranking it does not change; re-scoring the front puts the final numbers on the
mesh the study trusts.
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
