Bill-Gkionis/IPM-synRM/(commit log)

2026-03-03 Add files via upload
    Created full motor assembly with lamination stack. Created custom silicon steel m19 material and NdFeB for solidworks and added them to Stator, Rotor and magnets respectively, mainly for moment of inertia calculation.
2026-03-03 Add files via upload
    After completing materials on mechanical side, I passed the moment of inertia value, relative to the rotational axis, to PMSM block in Simscape electrical properties.
2026-03-03 Add files via upload
    Calculating Permanent Magnet flux linkage with Phase A, rotating the rotor with a 5 degrees step with a mechanical rotation of 0-90 degrees. The motor is considered a symmetrical 3-phase load, and therefore either phases selected would give the same PM flux linkage.
2026-03-07 Deleted a few draft unecessary files and added a Matlab function that automates motor value extraction with FEMM. This is the first commit, so it's currently under development.
2026-03-07 Improved flux_linkage function, and extracted results for rotor from 0-90 degrees mechanical.
2026-03-08 Added Clarke-Park transform scripts for current and flux linkage transition from abc to dq plane.
2026-03-12 Added a few matlab files that include a motor structure to run the simulink model. Created an improved plant that replaces the simscape's all in one FOC block with a block from 'Motor modeling' simul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
2026-11-05 Restructure into femm/, matlab/, cad/ and docs/figures/
    The April files, reorganised so each later stage lands in its own place:
    - femm/: the three FEMM models (IPM synRM analysis.FEM is the reference model) and, in
    femm/screenshots/, the 5-90 degree rotor sweep and the Phase A plots.
    - matlab/: flux_linkage.mlx and its .mat files; matlab/transforms/: the six Clarke/Park
    functions; matlab/simulink/: Plant_model.slx (the first attempt) and Improved_plant.slx.
    - cad/: the SolidWorks parts, the assembly, the drawings and the two equation files
    (was mechanical/).
    - docs/figures/: the nine screenshots of the first pass (was screenshots/).
    Out of the tree, still in the history (tag v0 = 00d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
2026-11-05 README: the motor first, an honest status board, and the new layout
    A light polish while the full one-screen README is still to be discussed:
    - the motor in one table (36/8, V magnets, the dimensions, N45, M-19, the d-q convention);
    - a status board (done / partly / planned) in place of claims that were never simulated: the
    "high-fidelity PMSM block", the torque-speed and efficiency results, the "optimized" slots,
    the saliency written as Ld/Lq, and LTspice listed as used are gone;
    - the plant's Lq of 11.2 mH explained (magnet flux over the 1 A test current; FEMM gives a
    saliency Lq/Ld of about 1.8);
    - what each folder holds, the next steps, and how it's made.
2026-11-09 python: the pipeline's code, with a guide to every file
    The code that draws the motor (motorgeo), drives FEMM 5.0 through a solver queue, runs the
    first studies, the validation against the original model and FEMM 4.2, the tool checks and test
    bench, the materials scripts, the teaching scripts, the optimization study, the rotor stress
    check, the copper losses with the proximity effect and the winding studies; the thermal, flux-map
    and motor-map code is in place with its write-up to come. Set up for one Windows PC (config.toml);
    README.md describes each file, how to run it, and which tests need the studies' outputs.
2026-11-09 docs/explorer: the interactive Flux Explorer for GitHub Pages
    One self-contained page (8.9 MB) of the three designs from 11,718 FEMM solves: the field with
    the rotor turning, the current dial with MTPA, the phase currents and vectors, the torque ripple,
    the current plane with field weakening, and the optimizer's design space. Stored byte for byte;
    docs/.nojekyll lets GitHub Pages serve it as it is.
2026-11-09 README: the project, the pipeline and the steps to date
    The motor at a glance, the pipeline and its principles, each step from the first pass to the
    winding with its numbers and figures, the interactive flux page, what comes next, a fidelity
    checklist, the layout and how to run the code.
2026-11-09 python: the figures-copy option points at the repository's docs/figures
    The materials scripts copy their figures into a second folder only when asked. That folder is
    now the repository's own docs/figures (config.toml docs_figures = '../docs/figures', asked for
    with MOTOR_FIGURES_DIR=docs) instead of a path on the development PC. Tests follow.
2026-11-09 The flux maps, the thermal model and the motor map, published
    README: three new steps in the order the work ran. The flux maps (425 points, 15,202 FEMM
    solves, cross-saturation, the iron loss) come before the thermal model (a lumped network,
    within 2 % of a 2D finite-element slice), which comes before the copper losses and the winding
    that use them. The motor map is its own step (4.2 N·m continuous, 8.7 N·m short-term, 2.97 kW
    peak and 95.2 % best efficiency on 48 V), and step 6 gains the size of the search. The status
    box, the pipeline, the fidelity checklist and the layout follow. Motor map.md, matlab/maps/
    (prepared, not yet run in MATLAB) and their figures join them.
2026-11-11 The flux maps validated in MATLAB, and the README made precise
    matlab/maps: check_fem_maps.m passes all 14 checks against the Python reference in MATLAB
    R2025b, fem_maps_setup.m runs, and on the 60 mm motor's own winding MATLAB and Python agree
    within 0.2 degrees and 0.02 %; the Simulink block is the next step. README: each MTPA figure
    names its rotor, current and formula variant (the starting rotor at 40 A, the optimized rotor
    at 3 x rated, 35.6 A), the torque lost at a formula's angle is told apart from a
    constant-parameter model's overprediction, the power factor 0.81 to 0.87 and pymoo are named,
    the first-pass FOC drive with SVPWM in Simscape Electrical is described, the solve count is
    b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
